austinmam/TSI/Datasheets/Linear Potentiometer Sensor with Rod End Joints_LPPS-100_Silver_Cable.png

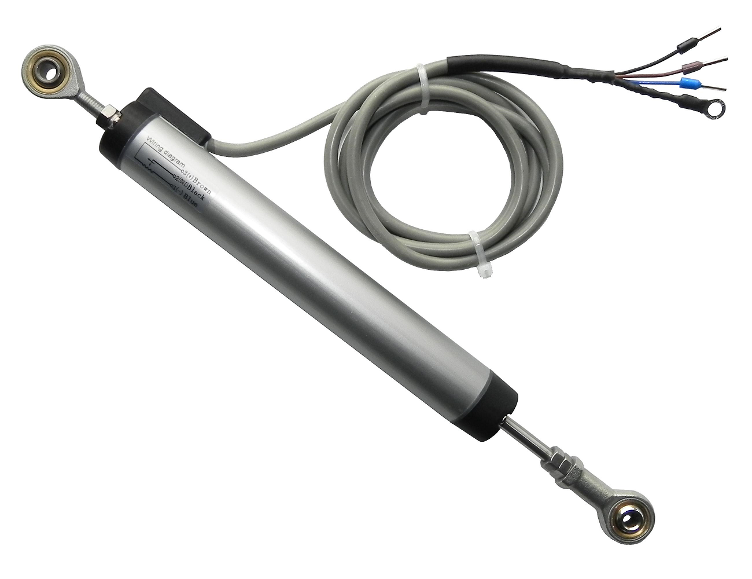
Datasheets/Linear Potentiometer Sensor with Rod End Joints_LPPS-100_Silver_Cable.png
