austinmam/TSI/Diagrams/CurtisMC_Precharge_Circuitry.PNG

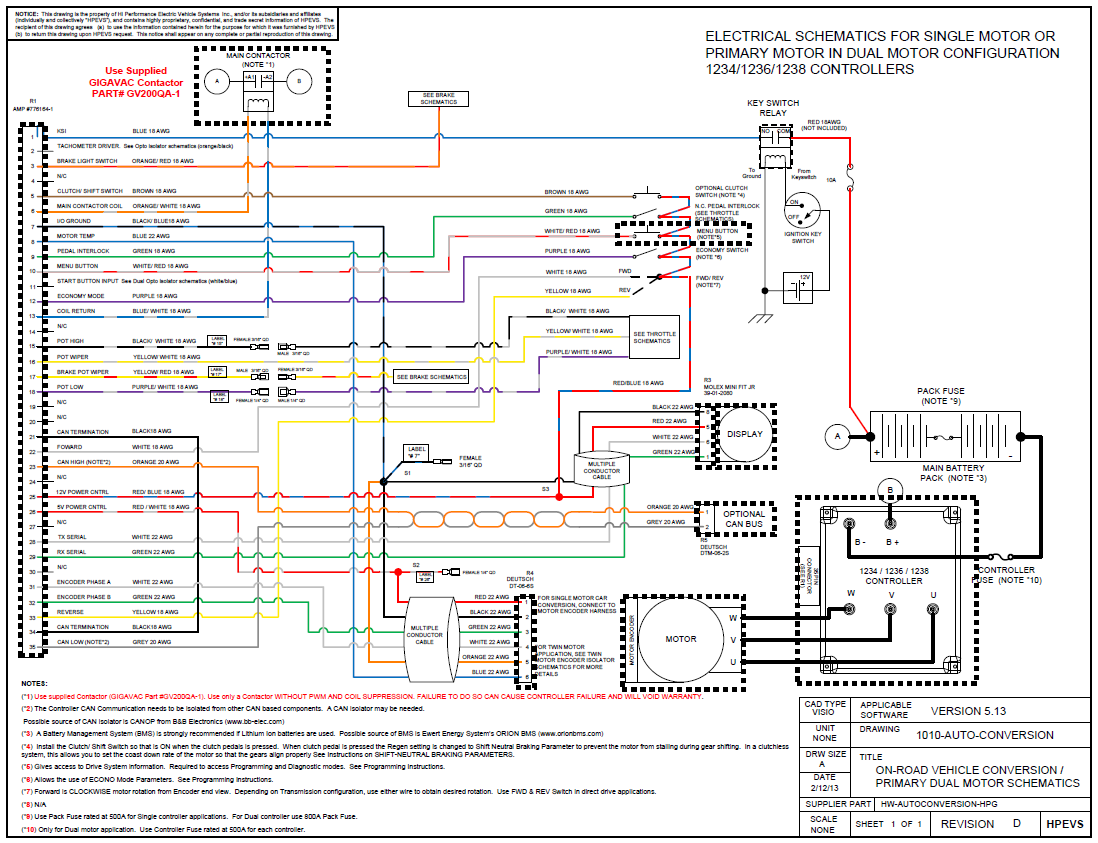
Diagrams/CurtisMC_Precharge_Circuitry.PNG
