austinmam/TSI/Diagrams/shutdown_diagram.PNG

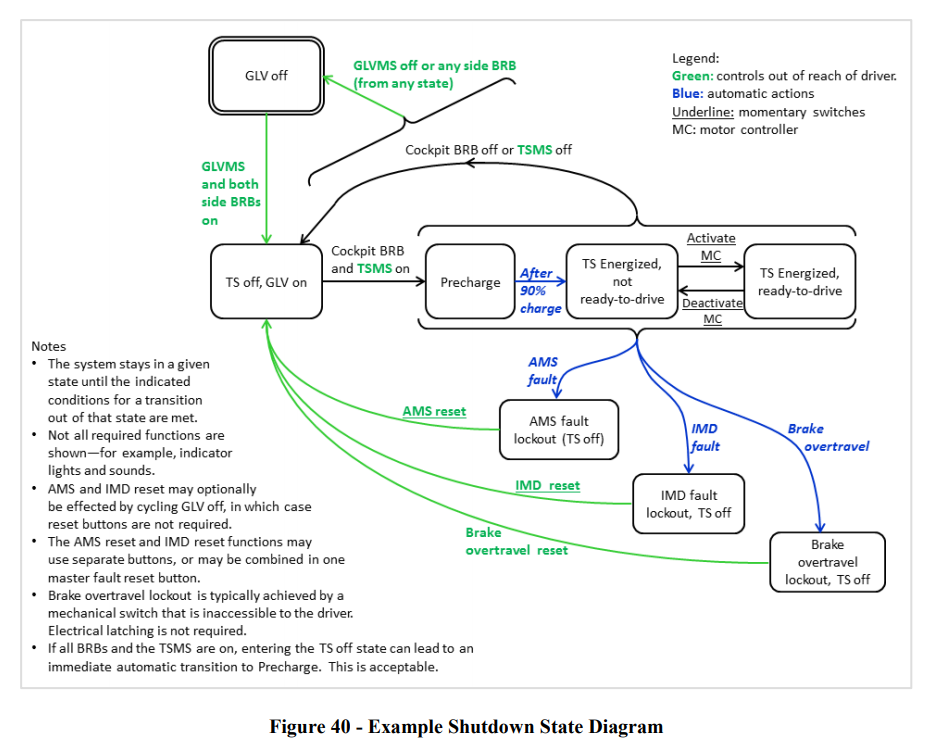
Diagrams/shutdown_diagram.PNG
