austinmam/TSI/Diagrams/ShutdownSystemPoster.png

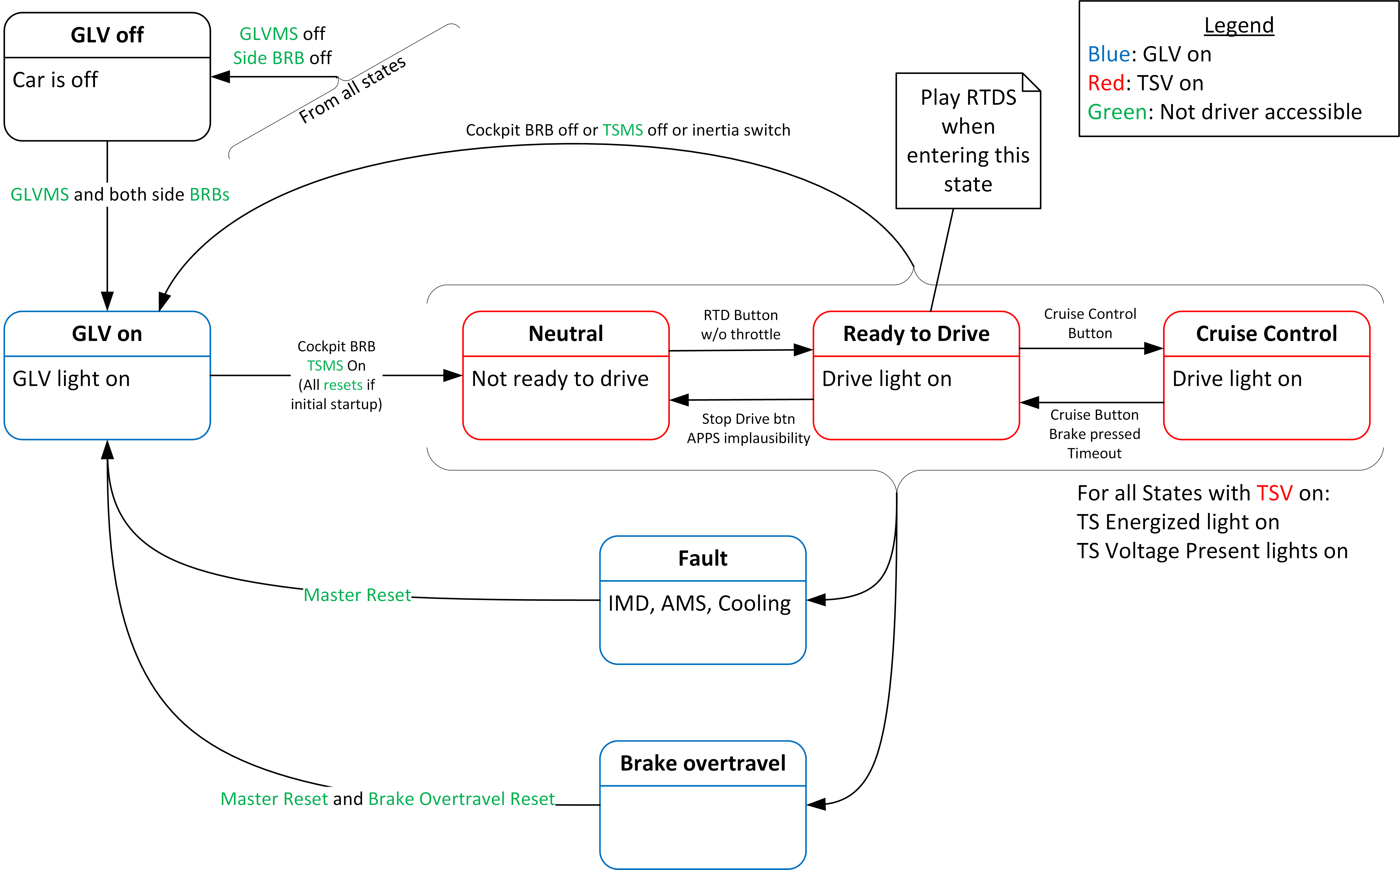
Diagrams/ShutdownSystemPoster.png
