austinmam/TSI/Diagrams/System_States.png

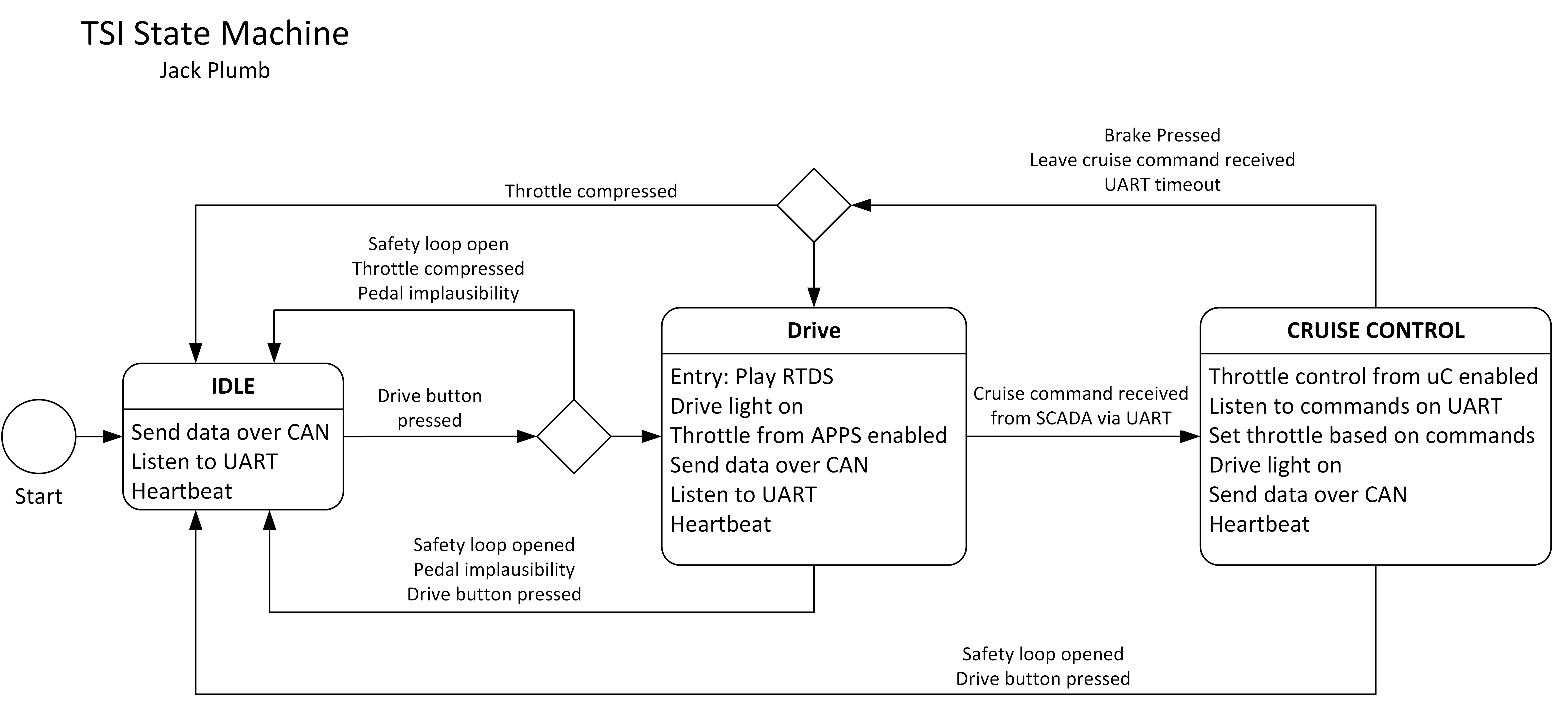
Diagrams/System_States.png
