austinmam/TSI/Diagrams/TSI_Func_Block_Diagram.png

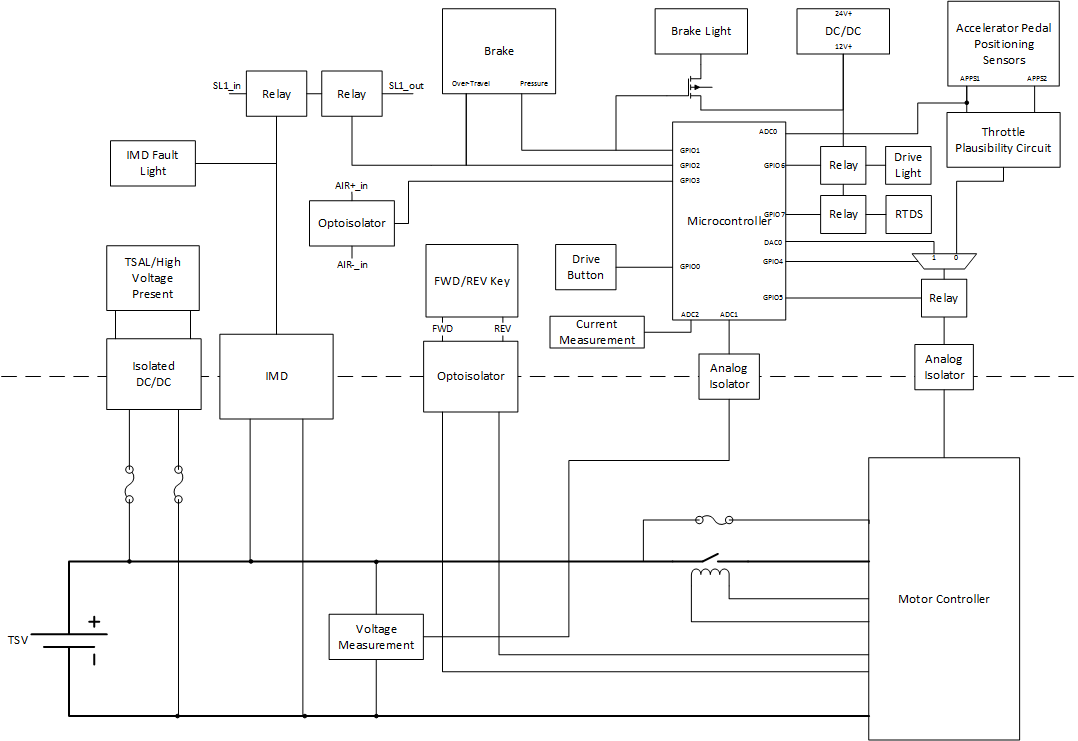
Diagrams/TSI_Func_Block_Diagram.png
