austinmam/TSI/Diagrams/TSV_to_MC.png

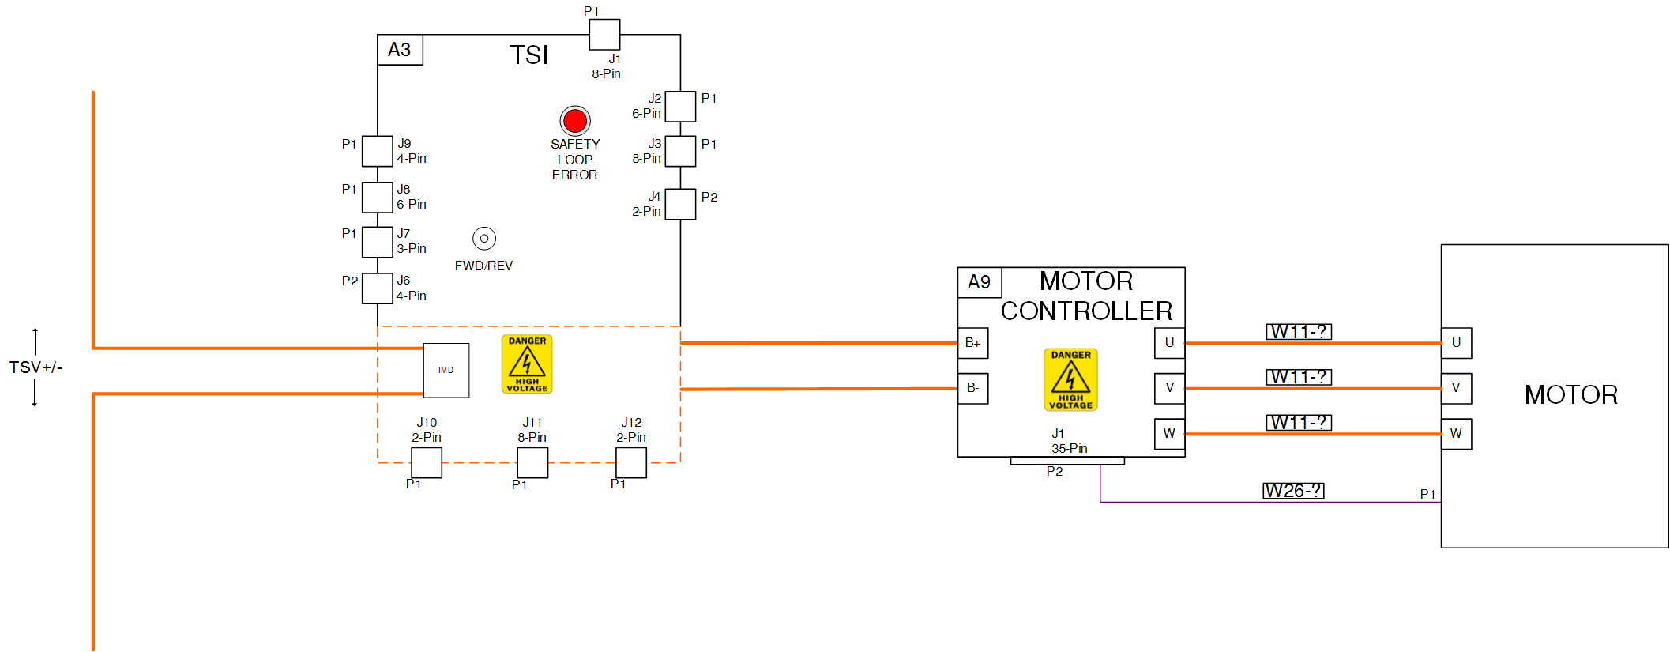
Diagrams/TSV_to_MC.png
