austinmam/TSI/For trash/Box Inventor/TSI_Box_Back_Panel.dxf

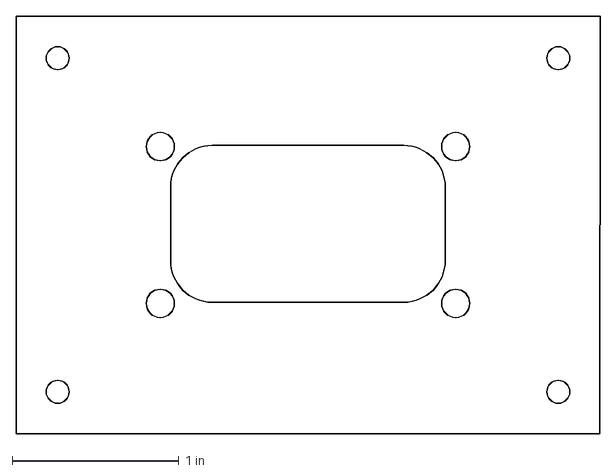
[picture p14: CAD file, 2017-04-13, last stored version]
For trash/Box Inventor/TSI_Box_Back_Panel.dxf
3.50 x 2.50 in
