austinmam/TSI/TSI Inventor Parts/TSI Inventor Parts/Wall Laser Cut.dxf

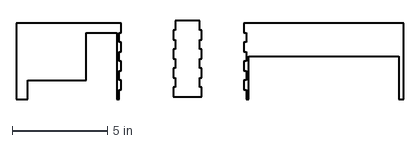
[picture p15: CAD file, 2017-05-05, last stored version]
TSI Inventor Parts/TSI Inventor Parts/Wall Laser Cut.dxf
20.3 x 4.13 in
