austinmam/TSI/For trash/Box Inventor/TSI Front Panel Cutout.dxf

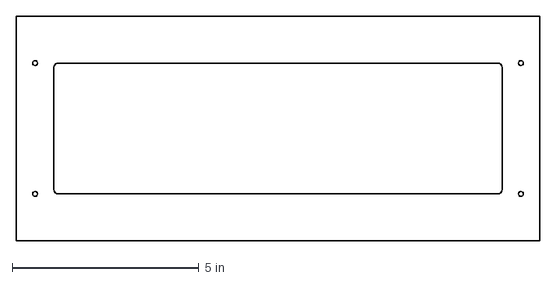
[picture p16: CAD file, 2017-04-13, last stored version]
For trash/Box Inventor/TSI Front Panel Cutout.dxf
14.0 x 6.00 in
