austinmam/TSI/Rack Plate Inventor/TSI_Rack_Plate.dxf

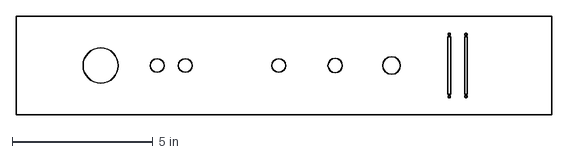
[picture p17: CAD file, 2017-04-03, last stored version]
Rack Plate Inventor/TSI_Rack_Plate.dxf
19.0 x 3.50 in
