austinmam/TSI/For trash/Box Inventor/TSI TSV+ Panel Cutout.dxf

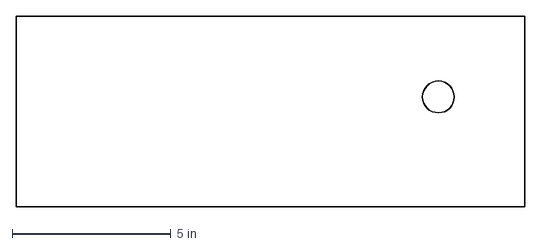
[picture p18: CAD file, 2017-04-13, last stored version]
For trash/Box Inventor/TSI TSV+ Panel Cutout.dxf
16.0 x 6.00 in
