austinmam/TSI/Rack Plate Inventor/pta4543-2x15cpxxxx.stp

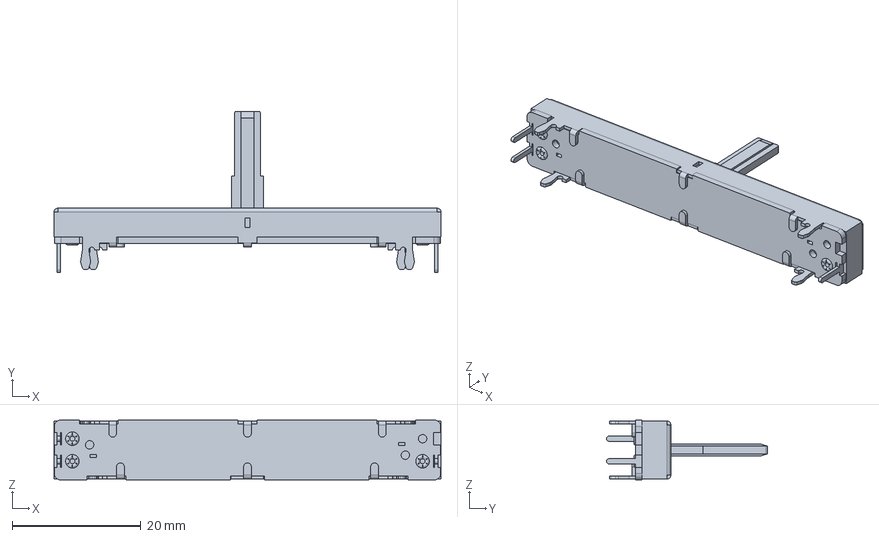
[picture p19: CAD file, 2017-03-31, last stored version]
Rack Plate Inventor/pta4543-2x15cpxxxx.stp
60.0 x 25.0 x 9.30 mm
