austinmam/TSI/TSI Inventor Parts/TSI Inventor Parts/TSI Back Panel Cutout.dxf

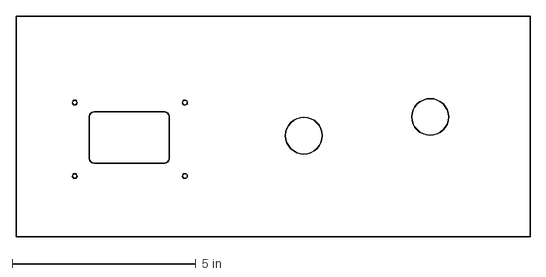
[picture p20: CAD file, 2017-04-13, last stored version]
TSI Inventor Parts/TSI Inventor Parts/TSI Back Panel Cutout.dxf
14.0 x 6.00 in
