austinmam/TSI/For trash/Box Inventor/Back Panel.dxf

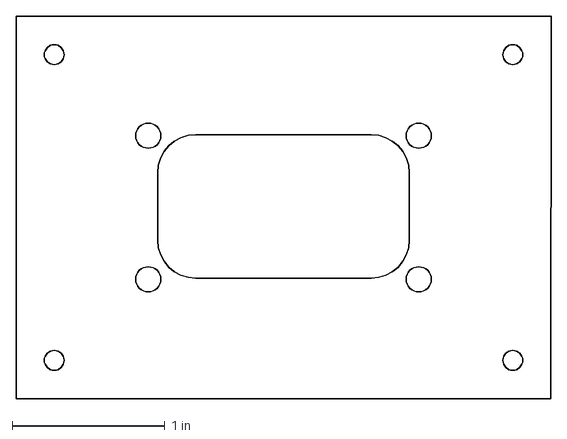
[picture p21: CAD file, 2017-04-13, last stored version]
For trash/Box Inventor/Back Panel.dxf
3.50 x 2.50 in
