austinmam/TSI/TSI Inventor Parts/TSI Inventor Parts/Mounting Plate Cut.dxf

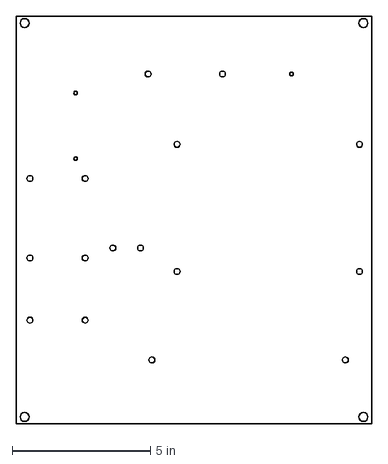
[picture p22: CAD file, 2017-04-13, last stored version]
TSI Inventor Parts/TSI Inventor Parts/Mounting Plate Cut.dxf
12.9 x 14.8 in
