austinmam/TSI/TSI Inventor Parts/TSI Inventor Parts/TSI_Box_Front_Panel.dxf

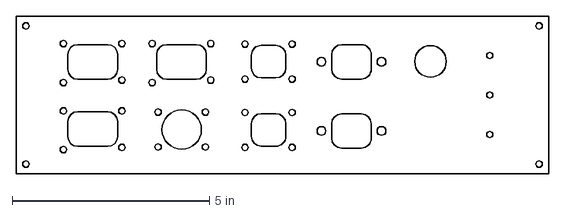
[picture p23: CAD file, 2017-04-13, last stored version]
TSI Inventor Parts/TSI Inventor Parts/TSI_Box_Front_Panel.dxf
13.5 x 4.00 in
