austinmam/TSI/For trash/Box Inventor/Front Panel.dxf

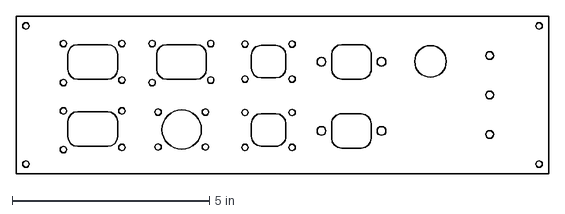
[picture p24: CAD file, 2017-04-13, last stored version]
For trash/Box Inventor/Front Panel.dxf
13.5 x 4.00 in
