austinmam/TSI/TSI Inventor Parts/TSI Inventor Parts/Current Sensor Bar.dxf

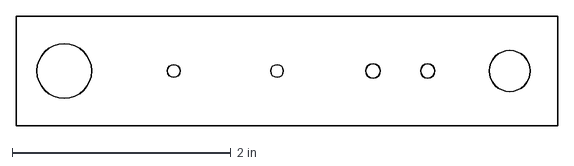
[picture p25: CAD file, 2017-04-13, last stored version]
TSI Inventor Parts/TSI Inventor Parts/Current Sensor Bar.dxf
4.95 x 1 in
