austinmam/TSI/For trash/Box Inventor/TSV-Bar.dxf

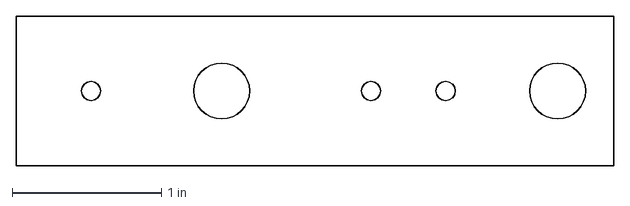
[picture p26: CAD file, 2017-04-13, last stored version]
For trash/Box Inventor/TSV-Bar.dxf
4.00 x 1 in
