austinmam/TSI/(list of files, cad)

Other CAD files:
Initial_Layout.dwg
TSI Inventor Parts/TSI Inventor Parts/15x11Plate.dwg
For trash/Box Inventor/15x11Plate.dwg
Box Inventor/1 inch screw.ipt
Box Inventor/15x11Plate.dwg
Box Inventor/15x11Plate.idw
Box Inventor/15x11Plate.ipt
Box Inventor/18x12x6Box.ipt
Box Inventor/2inStandoff.ipt
Box Inventor/2inchMcMasterStandoff.ipt
Box Inventor/2inchStandoff.ipt
Box Inventor/6-32 .25 inch screw.ipt
Box Inventor/6-32 inserts.ipt
Box Inventor/94335A115_ELECTRICAL-INSULATING FEM THRDED STANDOFF.ipt
Box Inventor/BackPanel Cutout.idw
Box Inventor/BackPanel Cutout.ipt
Box Inventor/BackPanel.idw
Box Inventor/BackPanel.ipt
Box Inventor/Box Connector Panel.ipt
Box Inventor/CAN2CAN.ipt
Box Inventor/CANIMDWall.ipt
Box Inventor/Current Sensor Bar.idw
Box Inventor/Current Sensor Bar.ipt
Box Inventor/DIN Rail (TS) 35mm Wide v1.ipt
Box Inventor/DIN Rail (TS) 35mm Wide v1/OldVersions/TS35x7.5 mm H - 5.2 mm dia slot - 100 mm long.0001.ipt
Box Inventor/DIN Rail (TS) 35mm Wide v1/TS35x7.5 mm H - 5.2 mm dia slot - 100 mm long.ipt
Box Inventor/FrontPanel.idw
Box Inventor/FrontPanel.ipt
Box Inventor/Garalite Support.ipt
Box Inventor/IMD20216.ipt
Box Inventor/L16-TSV-64.2.ipt
Box Inventor/L16-TSV-65.1.iam
Box Inventor/MockPCB.ipt
Box Inventor/OldVersions/15x11Plate.0003.dwg
Box Inventor/OldVersions/15x11Plate.0010.idw
Box Inventor/OldVersions/15x11Plate.0055.ipt
Box Inventor/OldVersions/18x12x6Box.0065.ipt
Box Inventor/OldVersions/BackPanel Cutout.0003.ipt
Box Inventor/OldVersions/BackPanel Cutout.0009.idw
Box Inventor/OldVersions/BackPanel Cutout.0011.idw
Box Inventor/OldVersions/BackPanel.0007.idw
Box Inventor/OldVersions/BackPanel.0014.ipt
Box Inventor/OldVersions/Box Connector Panel.0008.ipt
Box Inventor/OldVersions/CAN2CAN.0002.ipt
Box Inventor/OldVersions/CANIMDWall.0002.ipt
Box Inventor/OldVersions/Current Sensor Bar.0006.idw
Box Inventor/OldVersions/Current Sensor Bar.0007.idw
Box Inventor/OldVersions/Current Sensor Bar.0023.ipt
Box Inventor/OldVersions/DIN Rail (TS) 35mm Wide v1.0011.ipt
Box Inventor/OldVersions/FrontPanel.0008.idw
Box Inventor/OldVersions/FrontPanel.0018.ipt
Box Inventor/OldVersions/Garalite Support.0002.ipt
Box Inventor/OldVersions/IMD20216.0001.ipt
Box Inventor/OldVersions/L16-TSV-65.1.0018.iam
Box Inventor/OldVersions/MockPCB.0010.ipt
Box Inventor/OldVersions/PCBWall.0001.ipt
Box Inventor/OldVersions/Plug-in Plate.0001.ipt
Box Inventor/OldVersions/PrechargeRelay2016.0005.ipt
Box Inventor/OldVersions/Ring Connector model 2.0001.ipt
Box Inventor/OldVersions/Ring Connector model 3.0009.ipt
Box Inventor/OldVersions/Ring Connector model 4.0005.ipt
Box Inventor/OldVersions/Ring Connector model 5.0005.ipt
Box Inventor/OldVersions/SmallWall.0006.ipt
Box Inventor/OldVersions/TSI Front Cutout.0003.ipt
Box Inventor/OldVersions/TSI Front Cutout.0010.idw
Box Inventor/OldVersions/TSI Front Cutout.0012.idw
Box Inventor/OldVersions/TSIWall.0006.ipt
Box Inventor/OldVersions/TSI_Assembly.0045.iam
Box Inventor/OldVersions/TSV+ Side Panel.0001.ipt
Box Inventor/OldVersions/TSV+ Side Panel.0005.idw
Box Inventor/OldVersions/TSV+Panel.0002.ipt
Box Inventor/OldVersions/TSV+Panel.0005.ipt
Box Inventor/OldVersions/TSV+Support.0003.ipt
Box Inventor/OldVersions/TSV-Bar.0006.idw
Box Inventor/OldVersions/TSV-Bar.0017.ipt
Box Inventor/OldVersions/TSV-Panel.0001.ipt
Box Inventor/OldVersions/TSV-PanelCutout.0002.ipt
Box Inventor/OldVersions/TSV-PanelCutout.0008.idw
Box Inventor/OldVersions/TSV-Support.0006.ipt
Box Inventor/OldVersions/WallBend.0001.ipt
Box Inventor/PCBWall.ipt
Box Inventor/Plug-in Plate.ipt
Box Inventor/PrechargeRelay2016.ipt
Box Inventor/Ring Connector model 2.ipt
Box Inventor/Ring Connector model 3.ipt
Box Inventor/Ring Connector model 4.ipt
Box Inventor/Ring Connector model 5.ipt
Box Inventor/Ring Connector model.ipt
Box Inventor/SmallWall.ipt
Box Inventor/TSAL2016.ipt
Box Inventor/TSI Front Cutout.idw
Box Inventor/TSI Front Cutout.ipt
Box Inventor/TSI TSV- Panel Cutout.dxf
Box Inventor/TSIWall.ipt
Box Inventor/TSI_Assembly.iam
Box Inventor/TSV+ Side Panel.idw
Box Inventor/TSV+ Side Panel.ipt
Box Inventor/TSV+In.ipt
Box Inventor/TSV+Panel.ipt
Box Inventor/TSV+Support.ipt
Box Inventor/TSV-Bar.idw
Box Inventor/TSV-Bar.ipt
Box Inventor/TSV-Panel.ipt
Box Inventor/TSV-PanelCutout.idw
Box Inventor/TSV-PanelCutout.ipt
Box Inventor/TSV-Support.ipt
Box Inventor/WallBend.ipt
For trash/Box Inventor/1 inch screw.ipt
For trash/Box Inventor/15x11Plate.idw
For trash/Box Inventor/15x11Plate.ipt
For trash/Box Inventor/18x12x6Box.ipt
For trash/Box Inventor/2inStandoff.ipt
For trash/Box Inventor/2inchMcMasterStandoff.ipt
For trash/Box Inventor/2inchStandoff.ipt
For trash/Box Inventor/6-32 .25 inch screw.ipt
For trash/Box Inventor/6-32 inserts.ipt
For trash/Box Inventor/94335A115_ELECTRICAL-INSULATING FEM THRDED STANDOFF.ipt
For trash/Box Inventor/BackPanel Cutout.idw
For trash/Box Inventor/BackPanel Cutout.ipt
For trash/Box Inventor/BackPanel.idw
For trash/Box Inventor/BackPanel.ipt
For trash/Box Inventor/Box Connector Panel.ipt
For trash/Box Inventor/CAN2CAN.ipt
For trash/Box Inventor/CANIMDWall.ipt
For trash/Box Inventor/Current Sensor Bar.idw
For trash/Box Inventor/Current Sensor Bar.ipt
For trash/Box Inventor/DIN Rail (TS) 35mm Wide v1.ipt
For trash/Box Inventor/DIN Rail (TS) 35mm Wide v1/OldVersions/TS35x7.5 mm H - 5.2 mm dia slot - 100 mm long.0001.ipt
For trash/Box Inventor/DIN Rail (TS) 35mm Wide v1/TS35x7.5 mm H - 5.2 mm dia slot - 100 mm long.ipt
For trash/Box Inventor/FrontPanel.idw
For trash/Box Inventor/FrontPanel.ipt
For trash/Box Inventor/Garalite Support.ipt
For trash/Box Inventor/IMD20216.ipt
For trash/Box Inventor/L16-TSV-64.2.ipt
For trash/Box Inventor/L16-TSV-65.1.iam
For trash/Box Inventor/MockPCB.ipt
For trash/Box Inventor/OldVersions/15x11Plate.0003.dwg
For trash/Box Inventor/OldVersions/15x11Plate.0010.idw
For trash/Box Inventor/OldVersions/15x11Plate.0055.ipt
For trash/Box Inventor/OldVersions/18x12x6Box.0065.ipt
For trash/Box Inventor/OldVersions/BackPanel Cutout.0003.ipt
For trash/Box Inventor/OldVersions/BackPanel Cutout.0009.idw
For trash/Box Inventor/OldVersions/BackPanel Cutout.0011.idw
For trash/Box Inventor/OldVersions/BackPanel.0007.idw
For trash/Box Inventor/OldVersions/BackPanel.0014.ipt
For trash/Box Inventor/OldVersions/Box Connector Panel.0008.ipt
For trash/Box Inventor/OldVersions/CAN2CAN.0002.ipt
For trash/Box Inventor/OldVersions/CANIMDWall.0002.ipt
For trash/Box Inventor/OldVersions/Current Sensor Bar.0006.idw
For trash/Box Inventor/OldVersions/Current Sensor Bar.0007.idw
For trash/Box Inventor/OldVersions/Current Sensor Bar.0023.ipt
For trash/Box Inventor/OldVersions/DIN Rail (TS) 35mm Wide v1.0011.ipt
For trash/Box Inventor/OldVersions/FrontPanel.0008.idw
For trash/Box Inventor/OldVersions/FrontPanel.0018.ipt
For trash/Box Inventor/OldVersions/Garalite Support.0002.ipt
For trash/Box Inventor/OldVersions/IMD20216.0001.ipt
For trash/Box Inventor/OldVersions/L16-TSV-65.1.0018.iam
For trash/Box Inventor/OldVersions/MockPCB.0010.ipt
For trash/Box Inventor/OldVersions/PCBWall.0001.ipt
For trash/Box Inventor/OldVersions/Plug-in Plate.0001.ipt
For trash/Box Inventor/OldVersions/PrechargeRelay2016.0005.ipt
For trash/Box Inventor/OldVersions/Ring Connector model 2.0001.ipt
For trash/Box Inventor/OldVersions/Ring Connector model 3.0009.ipt
For trash/Box Inventor/OldVersions/Ring Connector model 4.0005.ipt
For trash/Box Inventor/OldVersions/Ring Connector model 5.0005.ipt
For trash/Box Inventor/OldVersions/SmallWall.0006.ipt
For trash/Box Inventor/OldVersions/TSI Front Cutout.0003.ipt
For trash/Box Inventor/OldVersions/TSI Front Cutout.0010.idw
For trash/Box Inventor/OldVersions/TSI Front Cutout.0012.idw
For trash/Box Inventor/OldVersions/TSIWall.0006.ipt
For trash/Box Inventor/OldVersions/TSI_Assembly.0045.iam
For trash/Box Inventor/OldVersions/TSV+ Side Panel.0001.ipt
For trash/Box Inventor/OldVersions/TSV+ Side Panel.0005.idw
For trash/Box Inventor/OldVersions/TSV+Panel.0002.ipt
For trash/Box Inventor/OldVersions/TSV+Panel.0005.ipt
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
