austinmam/TSI/Diagrams/Wiring_Diagram.png

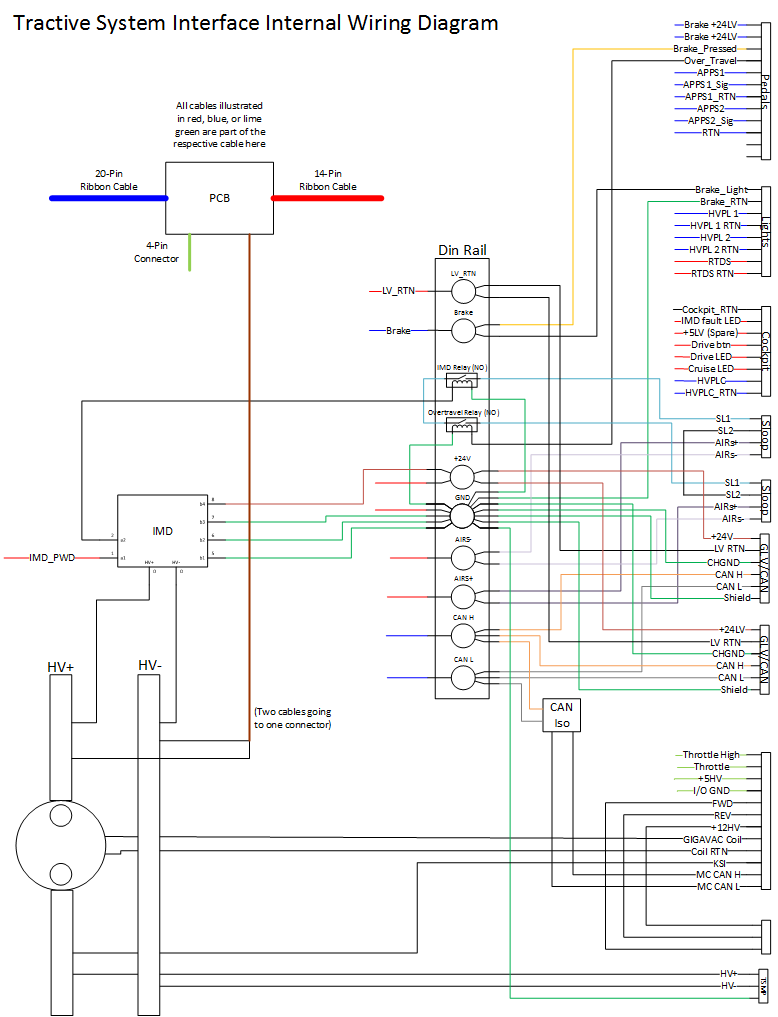
Diagrams/Wiring_Diagram.png
