austinmam/TSI/Diagrams/DriveStates.pdf

## DRIVE_SETUP

## DRIVE

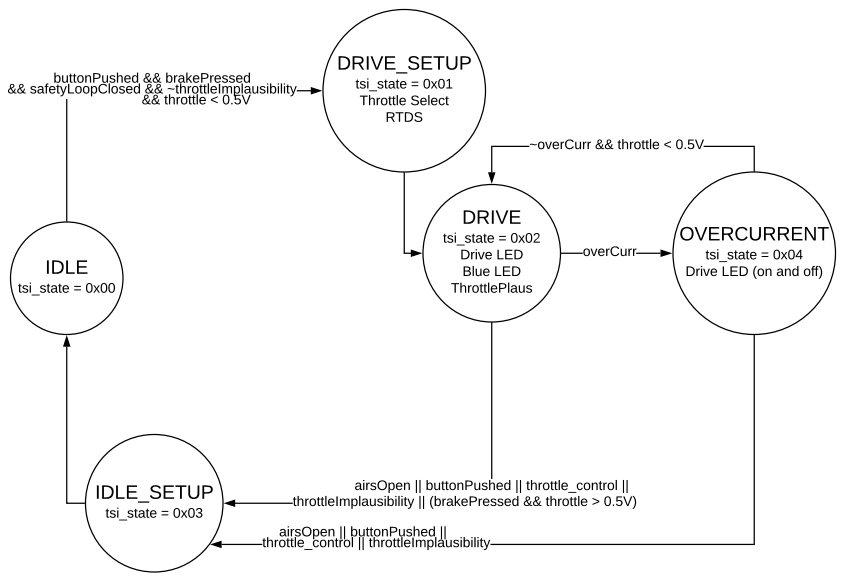
[picture p38: page 1]
IDLE; tsi_state = 0x00; tsi_state = 0x01 Throttle Select RTDS; tsi_state = 0x02 Drive LED Blue LED ThrottlePlaus; IDLE_SETUP; tsi_state = 0x03; airsOpen || buttonPushed || throttle_control ||; airsOpen || buttonPushed || throttle_control || throttleImplausibility; ~overCurr && throttle < 0.5V; overCurr

buttonPushed && brakePressed
&& safetyLoopClosed && ~throttleImplausibility && throttle < 0.5V

OVERCURRENT
tsi_state = 0x04
Drive LED (on and off)

throttleImplausibility || (brakePressed && throttle > 0.5V)
