austinmam/TSI/(list of files, drawings)

Other design files:
For trash/TSI_HV_Isolater/TSI_HV_Isolater.dsn
TSI_HV_Isolater/TSI_HV_Isolater.dsn
