austinmam/TSI/For trash/TSI_HV_Isolater/TSI_HV_Isolater.kicad_pcb

## KiCad design For trash/TSI_HV_Isolater/TSI_HV_Isolater.kicad_pcb (2017-02-14, last stored version)

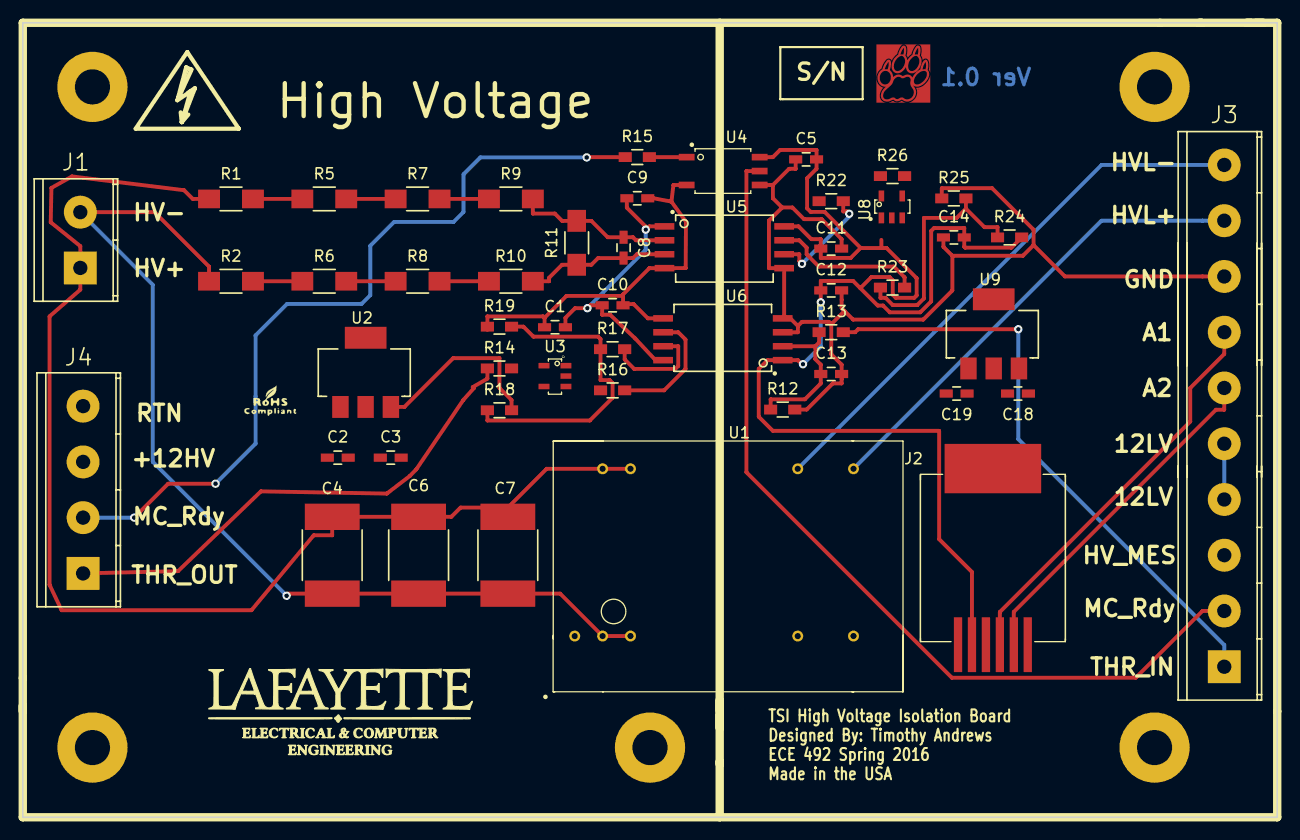
[picture p39: board TSI_HV_Isolater.kicad_pcb from above]

Board: 2 copper layers, 114.3 x 72.4 mm, 59 parts (0 on the bottom side), 34 nets.

Parts:
C1, C5, C9, C10, C11, C12, C13, C14: 0.1u; C_0603_HandSoldering
C2, C18: 10u; C_0603_HandSoldering
C3, C19: 22u; C_0603_HandSoldering
C4, C6, C7: 1u; C_2220_HandSoldering
C8: 330p; C_0603_HandSoldering
J1: CONN_01X02; TerminalBlock_Pheonix_MPT-5.08mm_2pol
J2: RJ12; MOLEX_RJ11
J3: CONN_01X10; TerminalBlock_Pheonix_MPT-5.08mm_10pol
J4: CONN_01X04; TerminalBlock_Pheonix_MPT-5.08mm_4pol
R1, R2, R5, R6, R7, R8, R9, R10: 10k; R_1206_HandSoldering
R11: 120; R_1206_HandSoldering
R12, R18, R19, R24, R25: 2k; R_0603_HandSoldering
R13: 3k; R_0603_HandSoldering
R14, R16, R17, R22, R23: 1k; R_0603_HandSoldering
R15: 20k; R_0603_HandSoldering
R26: 4.99k; R_0603_HandSoldering
U1: RDD08110S12
U2, U9: AZ1117CH-5.0TRG1; SOT-223_cus
U3, U8: MCP6001; MCP6001_SOT_23-5
U4: TLP2361; FODM8701
U5: AMC1100DWVR; amc1100_SOIC
U6: ACPL-C870; amc1100_SOIC
U10: place_holder; logo_lafayette_ece_24mmx9mm
U11: place_holder; lafLogo
U12: place_holder; rohs_symbol
U13: place_holder; Symbol_HighVoltage_Type2_FSilk_VerySmall
U16, U17, U18, U21, U30: place_holder; MountingHole_3.2mm_M3_Pad

Connections:
/24MC_RDYHV: J4.2, R15.1
/24MC_RDYLV: J3.2, U4.5
/+5HV: C1.2, C3.1, C9.1, C10.1, R18.2, U2.2, U3.5, U5.1, U6.8
/+5LV: C5.2, C11.1, C12.1, C14.2, C19.1, J2.5, R24.2, U4.6, U5.8, U6.1, U8.5, U9.2
/+12HV: C2.1, J4.3, U2.3
/+12LV: C18.1, J3.4, J3.5, U9.3
/A1_LV: J2.3, J3.7
/A2_LV: J2.2, J3.6
/GND: C5.1, C11.2, C12.2, C13.2, C14.1, C18.2, C19.2, J2.4, J3.8, R12.2, R25.1, U4.4, U5.5, U6.3, U6.4, U8.2, U9.1
/HV+: C4.2, C6.2, C7.2, J1.1, R1.1, U1.22, U1.23
/HV-: C4.1, C6.1, C7.1, J1.2, R2.1, U1.2, U1.3
/HV_LED+: J3.9, U1.14
/HV_LED-: J3.10, U1.16
/HV_MES: J3.3, R26.1, U8.1
/RTN: C1.1, C2.2, C3.2, C9.2, C10.2, J4.4, R19.1, U2.1, U3.2, U4.3, U5.4, U6.5
/Throttle_IN: J3.1, R13.2
/Throttle_OUT: J4.1, R14.1, U3.1
unnamed: C8.1, R9.2, R11.2, U5.2
unnamed: C8.2, R10.2, R11.1, U5.3
unnamed: C13.1, R12.1, R13.1, U6.2
unnamed: R1.2, R5.1
unnamed: R2.2, R6.1
unnamed: R5.2, R7.1
unnamed: R6.2, R8.1
unnamed: R7.2, R9.1
unnamed: R8.2, R10.1
unnamed: R14.2, R16.1
unnamed: R15.2, U4.1
unnamed: R17.1, R18.1, R19.2, U6.7
unnamed: R17.2, U3.3
unnamed: R22.1, R26.2, U8.4
unnamed: R22.2, U5.6
unnamed: R23.1, R24.1, R25.2, U8.3
unnamed: R23.2, U5.7
