austinmam/TSI/Circuit_layout/Circuit_layout.kicad_pcb

## KiCad design Circuit_layout/Circuit_layout.kicad_pcb (2017-03-28, last stored version)

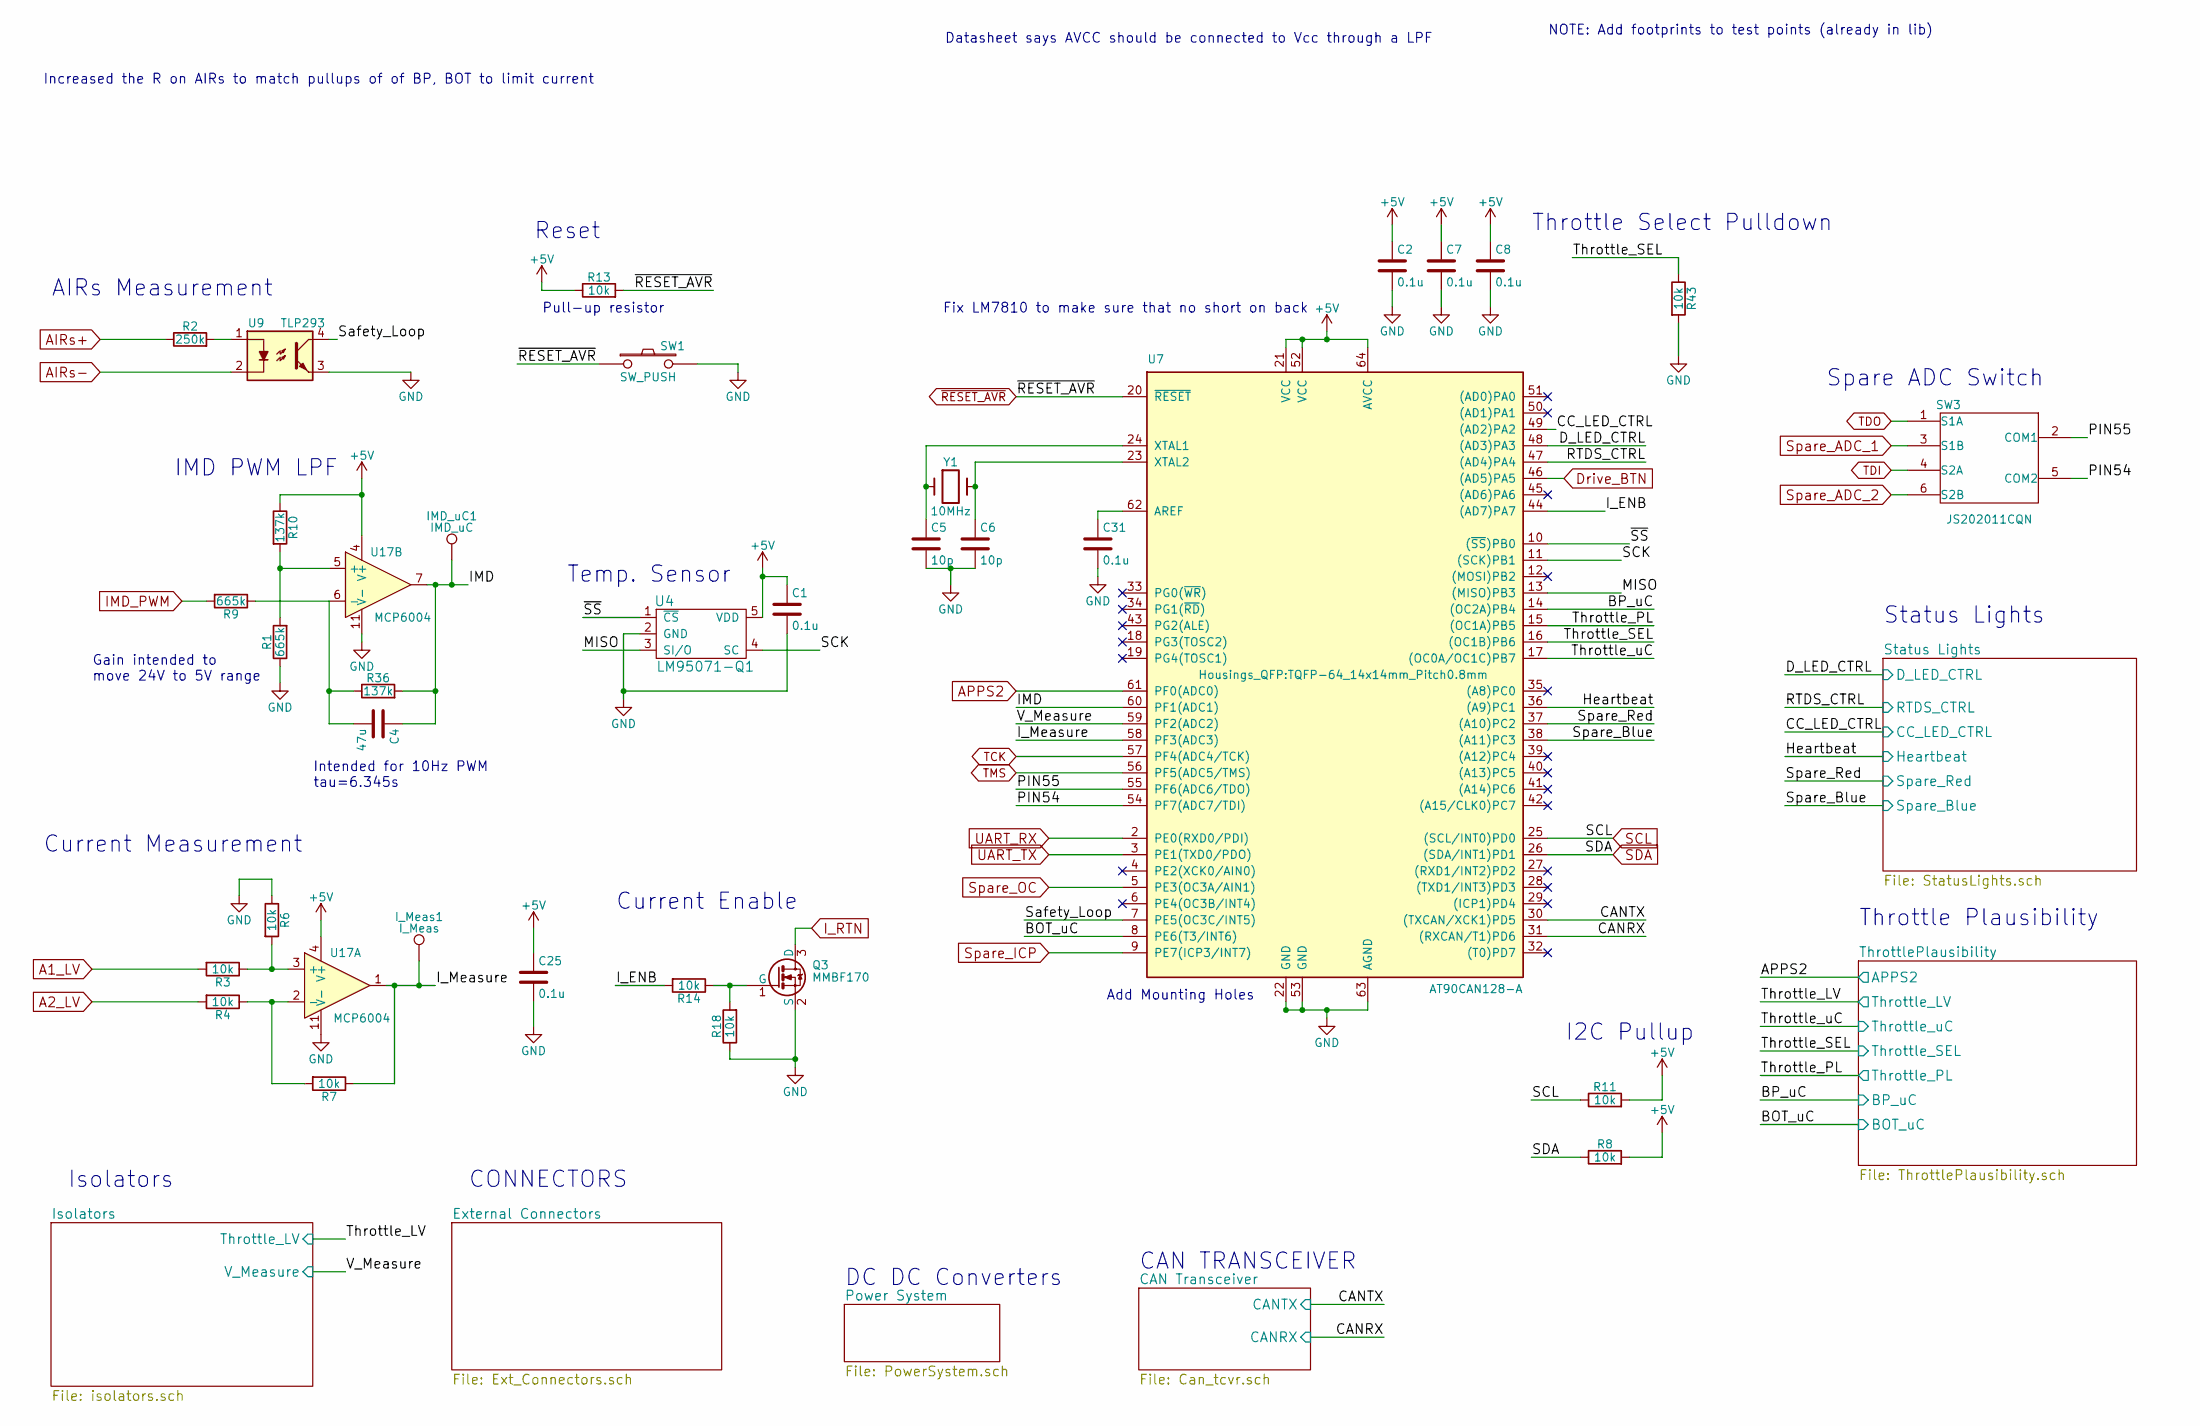
[picture p40: schematic Circuit_layout.sch, Tractive System Interface]

Parts:
C1, C2, C7, C8, C25, C31: 0.1u; C_0805_HandSoldering; Digikey P/N 399-1168-1-ND
C4: 47u; C_1210_HandSoldering; Digikey P/N 490-6538-1-ND
C5, C6: 10p; C_0805_HandSoldering; DigiKey P/N 399-1108-1-ND
IMD_uC1: IMD_uC; Measurement_Point_Round-SMD-Pad_Big
I_Meas1: I_Meas; Measurement_Point_Round-SMD-Pad_Big
Q3: MMBF170; SOT-23; Digikey P/N MMBF170CT-ND
R1, R9: 665k; R_0805_HandSoldering; DigiKey P/N P665KCCT-ND
R2: 250k; R_0805_HandSoldering; DigiKey P/N P249KCCT-ND
R3, R4, R6, R7, R8, R11, R13, R14, R18, R43: 10k; R_0805_HandSoldering; DigiKey P/N P10.0KCCT-ND
R10, R36: 137k; R_0805_HandSoldering; DigiKey P/N P137KCCT-ND
SW1: SW_PUSH; SW_RACON_8; DigiKey P/N 1715-1676-1-ND
SW3: JS202011CQN; CK_DPDT_Switch; DigiKey P/N 401-2001-ND
U4: LM95071-Q1; SOT-23-5_HandSoldering; DigiKey P/N 296-40259-1-ND
U7: AT90CAN128-A; TQFP-64_14x14mm_Pitch0.8mm; DigiKey P/N AT90CAN128-16AURCT-ND
U9: TLP293; SOP-4_4.4x2.8mm_Pitch1.27mm; DigiKey P/N TLP293(GB-TPLECT-ND
U17: MCP6004; SOIC-14_3.9x8.7mm_Pitch1.27mm; Digikey P/N MCP6004T-I/SLCT-ND
Y1: 10MHz; crystal_TXC_7A; DigiKey P/N 887-1741-1-ND

Connections:
+5V: C1.1, C2.1, C7.1, C8.1, C25.1, R8.2, R10.1, R11.2, R13.1, U4.5 (VDD), U7.21 (VCC), U7.52 (VCC), U7.64 (AVCC), U17.4 (V+); also elsewhere on the board
/CAN Transceiver/CANRX: U7.31 ((RXCAN/T1)PD6); also elsewhere on the board
/CAN Transceiver/CANTX: U7.30 ((TXCAN/XCK1)PD5); also elsewhere on the board
/IMD: C4.1, IMD_uC1.1, R36.2, U7.60 (PF1(ADC1)), U17.7
/I_ENB: R14.2, U7.44 ((AD7)PA7)
/I_Measure: I_Meas1.1, R7.1, U7.58 (PF3(ADC3)), U17.1
/Isolators/V_Measure: U7.59 (PF2(ADC2)); also elsewhere on the board
/MISO: U4.3 (SI/O), U7.13 ((MISO)PB3)
/PIN54: SW3.5 (COM2), U7.54 (PF7(ADC7/TDI))
/PIN55: SW3.2 (COM1), U7.55 (PF6(ADC6/TDO))
/SCK: U4.4 (SC), U7.11 ((SCK)PB1)
/Safety_Loop: U7.7 (PE5(OC3C/INT5)), U9.4
/Status Lights/CC_LED_CTRL: U7.49 ((AD2)PA2); also elsewhere on the board
/Status Lights/D_LED_CTRL: U7.48 ((AD3)PA3); also elsewhere on the board
/Status Lights/Heartbeat: U7.36 ((A9)PC1); also elsewhere on the board
/Status Lights/RTDS_CTRL: U7.47 ((AD4)PA4); also elsewhere on the board
/Status Lights/Spare_Blue: U7.38 ((A11)PC3); also elsewhere on the board
/Status Lights/Spare_Red: U7.37 ((A10)PC2); also elsewhere on the board
/ThrottlePlausibility/BOT_uC: U7.8 (PE6(T3/INT6)); also elsewhere on the board
/ThrottlePlausibility/BP_uC: U7.14 ((OC2A)PB4); also elsewhere on the board
/ThrottlePlausibility/Throttle_PL: U7.15 ((OC1A)PB5); also elsewhere on the board
/ThrottlePlausibility/Throttle_SEL: R43.1, U7.16 ((OC1B)PB6); also elsewhere on the board
/ThrottlePlausibility/Throttle_uC: U7.17 ((OC0A/OC1C)PB7); also elsewhere on the board
/~SS: U4.1 (~CS), U7.10 ((~SS~)PB0)
A1_LV: R3.2; also elsewhere on the board
A2_LV: R4.2; also elsewhere on the board
AIRs+: R2.1; also elsewhere on the board
AIRs-: U9.2; also elsewhere on the board
APPS2: U7.61 (PF0(ADC0)); also elsewhere on the board
CH_GND: C1.2, C2.2, C5.2, C6.2, C7.2, C8.2, C25.2, C31.2, Q3.2 (S), R1.1, R6.1, R18.1, R43.2, SW1.2, U4.2 (GND), U7.22 (GND), U7.53 (GND), U7.63 (AGND), U9.3, U17.11 (V-); also elsewhere on the board
Drive_BTN: U7.46 ((AD5)PA5); also elsewhere on the board
IMD_PWM: R9.2; also elsewhere on the board
I_RTN: Q3.3 (D); also elsewhere on the board
unnamed: C4.2, R9.1, R36.1, U17.6 (-)
unnamed: C5.1, U7.24 (XTAL1), Y1.1
unnamed: C6.1, U7.23 (XTAL2), Y1.2
unnamed: C31.1, U7.62 (AREF)
unnamed: Q3.1 (G), R14.1, R18.2
unnamed: R1.2, R10.2, U17.5 (+)
unnamed: R2.2, U9.1
unnamed: R3.1, R6.2, U17.3 (+)
unnamed: R4.1, R7.2, U17.2 (-)
SCL: R11.1, U7.25 ((SCL/INT0)PD0); also elsewhere on the board
SDA: R8.1, U7.26 ((SDA/INT1)PD1); also elsewhere on the board
Spare_ADC_1: SW3.3 (S1B); also elsewhere on the board
Spare_ADC_2: SW3.6 (S2B); also elsewhere on the board
Spare_ICP: U7.9 (PE7(ICP3/INT7)); also elsewhere on the board
Spare_OC: U7.5 (PE3(OC3A/AIN1)); also elsewhere on the board
TCK: U7.57 (PF4(ADC4/TCK)); also elsewhere on the board
TDI: SW3.4 (S2A); also elsewhere on the board
TDO: SW3.1 (S1A); also elsewhere on the board
TMS: U7.56 (PF5(ADC5/TMS)); also elsewhere on the board
UART_RX: U7.2 (PE0(RXD0/PDI)); also elsewhere on the board
UART_TX: U7.3 (PE1(TXD0/PDO)); also elsewhere on the board
~RESET_AVR: R13.2, SW1.1, U7.20 (~RESET); also elsewhere on the board

Notes on the sheet:
CONNECTORS
CAN TRANSCEIVER
Current Measurement
IMD PWM LPF
AIRs Measurement
Throttle Plausibility
Status Lights
DC DC Converters
Isolators
Add Mounting Holes
Intended for 10Hz PWM tau=6.345s
I2C Pullup
Datasheet says AVCC should be connected to Vcc through a LPF
Pull-up resistor
Reset
Throttle Select Pulldown
NOTE: Add footprints to test points (already in lib)
Spare ADC Switch
Increased the R on AIRs to match pullups of of BP, BOT to limit current
Current Enable
Gain intended to move 24V to 5V range
Temp. Sensor
Fix LM7810 to make sure that no short on back

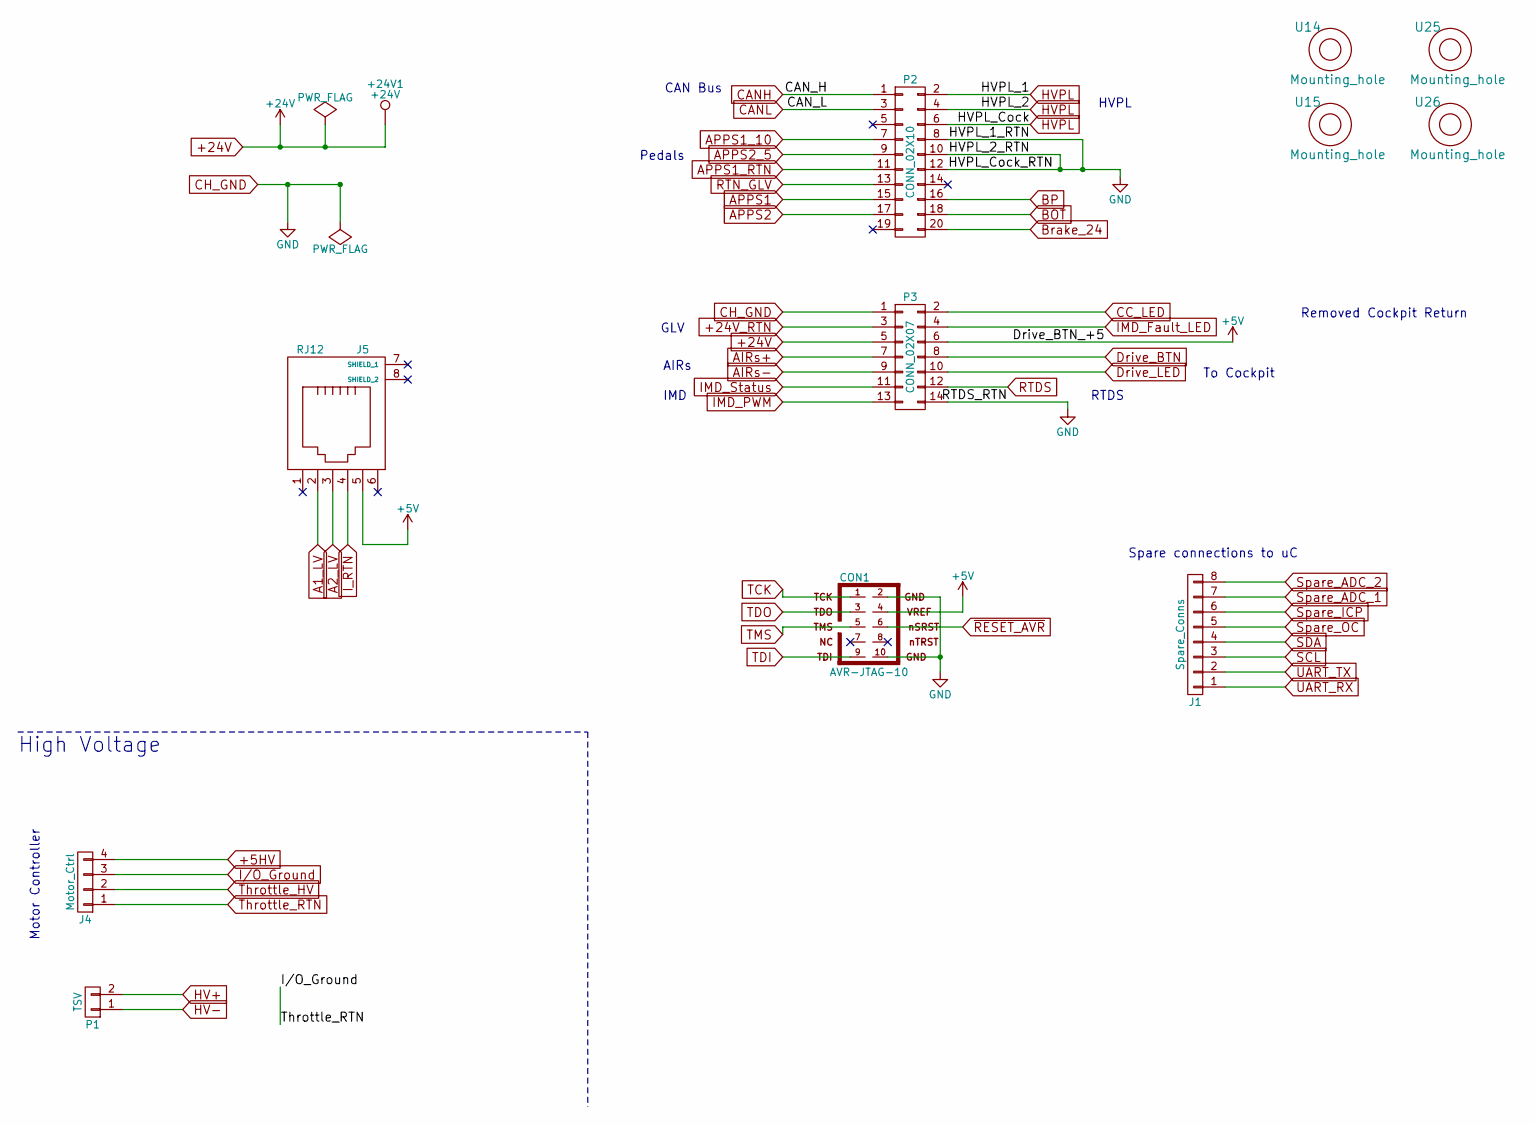
[picture p41: schematic Ext_Connectors.sch, Tractive System Interface]

Parts:
+24V1: +24V; Measurement_Point_Round-SMD-Pad_Big
CON1: AVR-JTAG-10; JTAG; DigiKey P/N 609-4054-ND
J1: Spare_Conns; Molex_8x1_2.54mm; DigiKey P/N WM4128-ND
J4: Motor_Ctrl; Molex_4x1_2.54mm; DigiKey P/N WM4802-ND
J5: RJ12; MOLEX_RJ11; DigiKey P/N WM3789CT-ND
P1: TSV; AMPCONN_2; DigiKey P/N A113980-ND
P2: CONN_02X10; IDC_Header_Straight_20pins; DigiKey P/N WM14741-ND
P3: CONN_02X07; IDC_Header_Straight_14pins; DigiKey P/N WM8632-ND
U14, U15, U25, U26: Mounting_hole; MountingHole_3.5mm_Pad

Connections:
+5HV: J4.4; also elsewhere on the board
+5V: CON1.4, J5.5, P3.6; also elsewhere on the board
+24V: +24V1.1, P2.20, P3.5; also elsewhere on the board
+24V_RTN: P3.3; also elsewhere on the board
A1_LV: J5.2; also elsewhere on the board
A2_LV: J5.3; also elsewhere on the board
AIRs+: P3.7; also elsewhere on the board
AIRs-: P3.9; also elsewhere on the board
APPS1: P2.15; also elsewhere on the board
APPS1_10: P2.7; also elsewhere on the board
APPS1_RTN: P2.11; also elsewhere on the board
APPS2: P2.17; also elsewhere on the board
APPS2_5: P2.9; also elsewhere on the board
BOT: P2.18; also elsewhere on the board
BP: P2.16; also elsewhere on the board
CANH: P2.1; also elsewhere on the board
CANL: P2.3; also elsewhere on the board
CC_LED: P3.2; also elsewhere on the board
CH_GND: CON1.2, CON1.10, P2.8, P2.10, P2.12, P2.13, P3.1, P3.14; also elsewhere on the board
Drive_BTN: P3.8; also elsewhere on the board
Drive_LED: P3.10; also elsewhere on the board
HV+: P1.2; also elsewhere on the board
HV-: P1.1; also elsewhere on the board
HVPL: P2.2, P2.4, P2.6; also elsewhere on the board
I/O_Ground: J4.1, J4.3; also elsewhere on the board
IMD_Fault_LED: P3.4; also elsewhere on the board
IMD_PWM: P3.13; also elsewhere on the board
IMD_Status: P3.11; also elsewhere on the board
I_RTN: J5.4; also elsewhere on the board
RTDS: P3.12; also elsewhere on the board
SCL: J1.3; also elsewhere on the board
SDA: J1.4; also elsewhere on the board
Spare_ADC_1: J1.7; also elsewhere on the board
Spare_ADC_2: J1.8; also elsewhere on the board
Spare_ICP: J1.6; also elsewhere on the board
Spare_OC: J1.5; also elsewhere on the board
TCK: CON1.1; also elsewhere on the board
TDI: CON1.9; also elsewhere on the board
TDO: CON1.3; also elsewhere on the board
TMS: CON1.5; also elsewhere on the board
Throttle_HV: J4.2; also elsewhere on the board
UART_RX: J1.1; also elsewhere on the board
UART_TX: J1.2; also elsewhere on the board
~RESET_AVR: CON1.6; also elsewhere on the board

Notes on the sheet:
To Cockpit
Motor Controller
AIRs
CAN Bus
High Voltage
IMD
GLV
Spare connections to uC
RTDS
Pedals
HVPL
Removed Cockpit Return

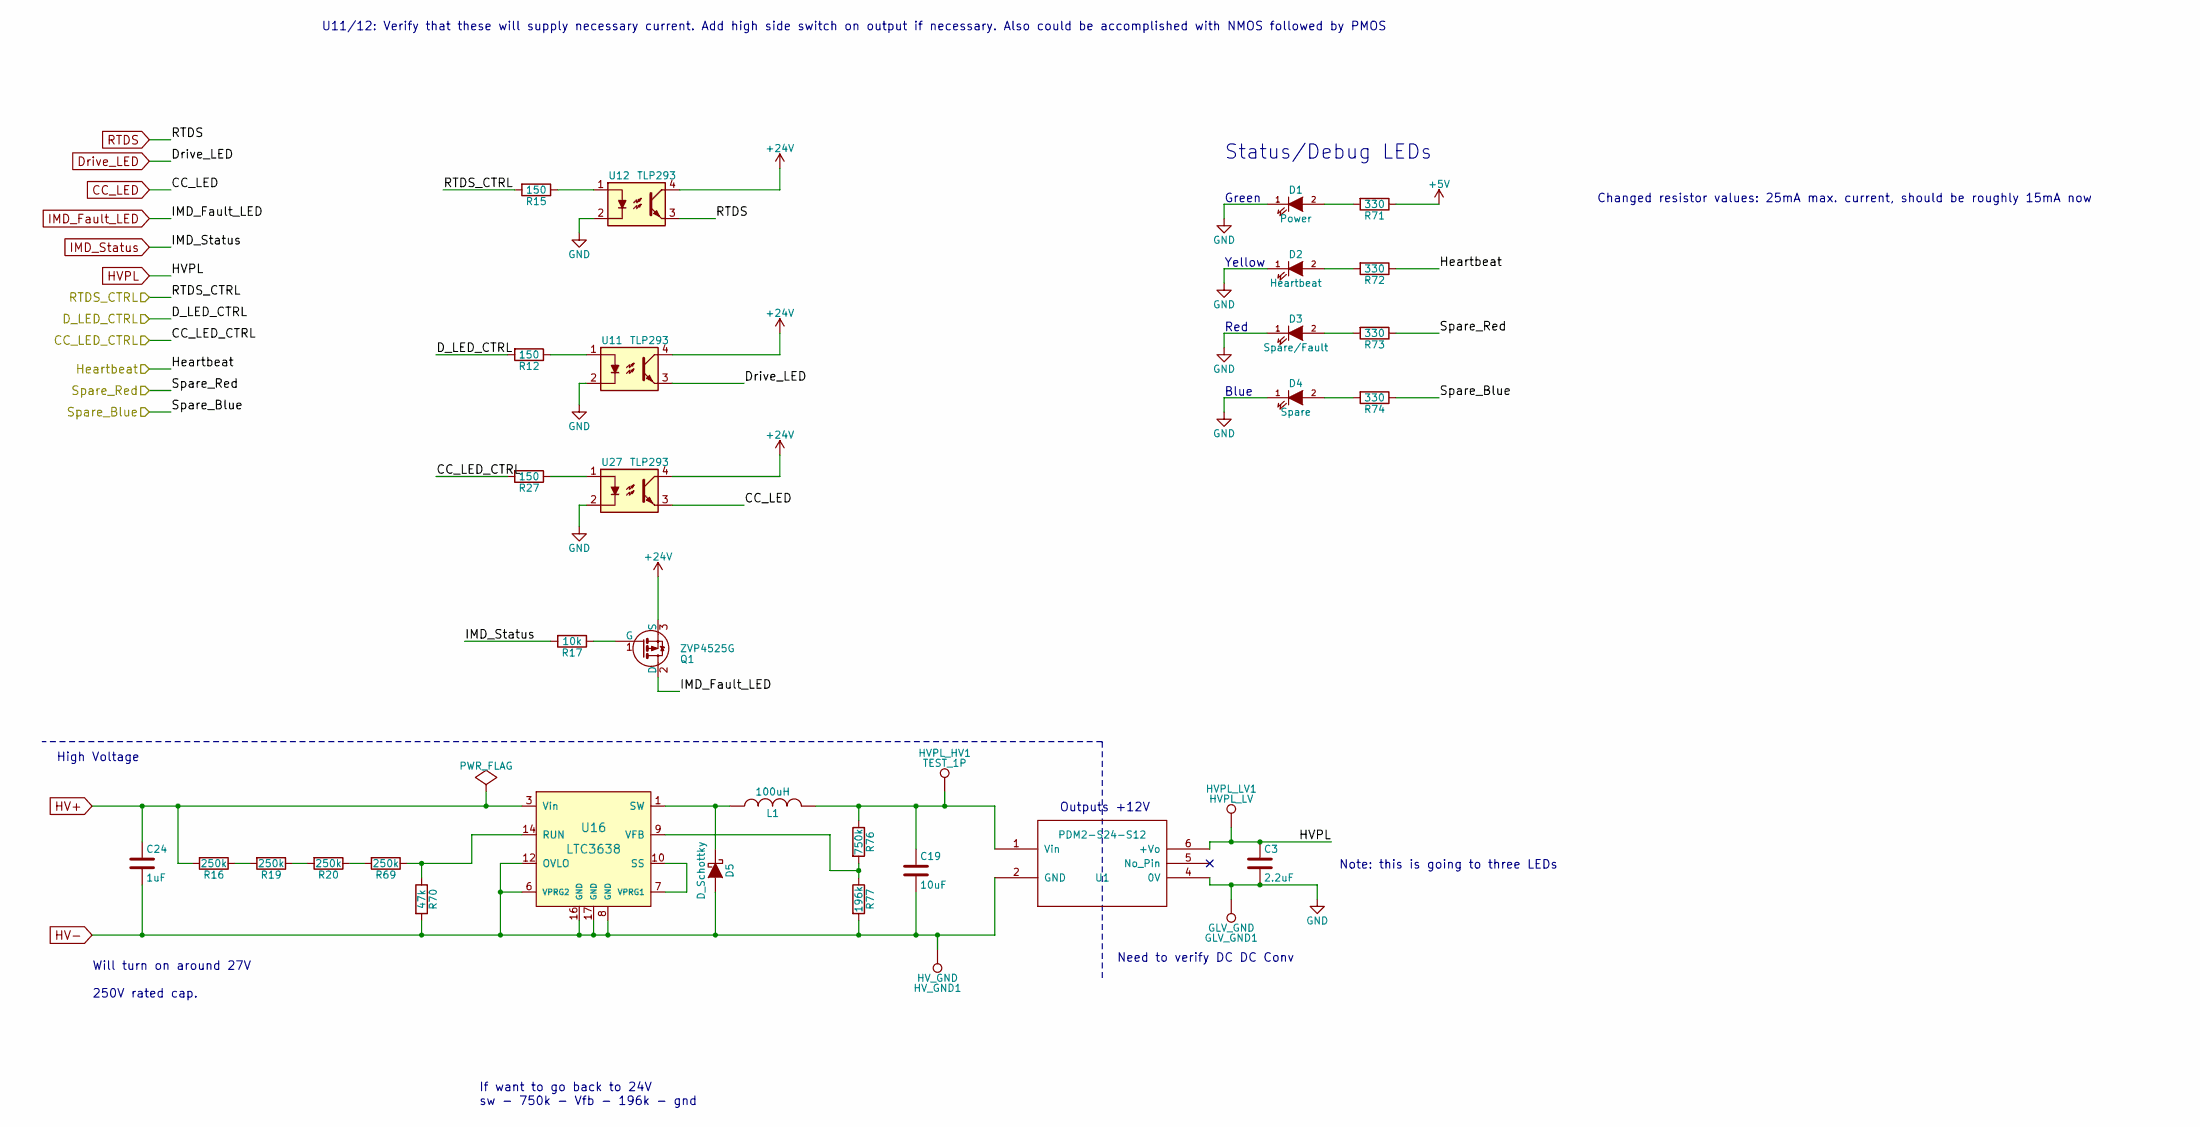
[picture p42: schematic StatusLights.sch, Tractive System Interface]

Parts:
C3: 2.2uF; C_0805_HandSoldering; DigiKey P/N 587-1293-1-ND
C19: 10uF; C_0805_HandSoldering; DigiKey P/N 490-10515-1-ND
C24: 1uF; C_2220_HandSoldering; DigiKey P/N 490-3550-1-ND
D1: Power; LED_0805; DigiKey P/N 475-1410-1-ND
D2: Heartbeat; LED_0805; DigiKey P/N 475-2560-1-ND
D3: Spare/Fault; LED_0805; DigiKey P/N 475-1278-1-ND
D4: Spare; LED_0805; DigiKey P/N 516-1445-1-ND
D5: D_Schottky; do214ac; DigiKey P/N SK310A-LTPMSCT-ND
GLV_GND1: GLV_GND; Measurement_Point_Square-SMD-Pad_Big
HVPL_HV1: TEST_1P; Measurement_Point_Round-SMD-Pad_Big
HVPL_LV1: HVPL_LV; Measurement_Point_Round-SMD-Pad_Big
HV_GND1: HV_GND; Measurement_Point_Square-SMD-Pad_Big
L1: 100uH; Inductor_Taiyo-Yuden_NR-80xx_HandSoldering; DigiKey P/N 587-2004-1-ND
Q1: ZVP4525G; SOT-223-3Lead_TabPin2; DigiKey P/N ZVP4525GCT-ND
R12, R15, R27: 150; R_0805_HandSoldering; DigiKey P/N 311-150CRCT-ND
R16, R19, R20, R69: 250k; R_0805_HandSoldering; DigiKey P/N P249KCCT-ND
R17: 10k; R_0805_HandSoldering; DigiKey P/N P10.0KCCT-ND
R70: 47k; R_0805_HandSoldering; DigiKey P/N 311-47.0KCRCT-ND
R71, R72, R73, R74: 330; R_0805_HandSoldering; DigiKey P/N P330CCT-ND
R76: 750k; R_0805_HandSoldering; DigiKey P/N P750KCCT-ND
R77: 196k; R_0805_HandSoldering; DigiKey P/N P196CCT-ND
U1: PDM2-S24-S12; DCDC-Conv_TRACO_TMR_1-xxxx_Single; DigiKey P/N 102-2728-ND
U11, U12, U27: TLP293; SOP-4_4.4x2.8mm_Pitch1.27mm; DigiKey P/N TLP293(GB-TPLECT-ND
U16: LTC3638; TSSOP16_LTC3638; DigiKey P/N LTC3638EMSE#PBF-ND

Connections:
+5V: R71.1; also elsewhere on the board
+24V: Q1.3 (S), U11.4, U12.4, U27.4; also elsewhere on the board
/Status Lights/CC_LED_CTRL: R27.2; also elsewhere on the board
/Status Lights/D_LED_CTRL: R12.2; also elsewhere on the board
/Status Lights/Heartbeat: R72.1; also elsewhere on the board
/Status Lights/RTDS_CTRL: R15.2; also elsewhere on the board
/Status Lights/Spare_Blue: R74.1; also elsewhere on the board
/Status Lights/Spare_Red: R73.1; also elsewhere on the board
CC_LED: U27.3; also elsewhere on the board
CH_GND: C3.2, D1.1 (K), D2.1 (K), D3.1 (K), D4.1 (K), GLV_GND1.1, U1.4 (0V), U11.2, U12.2, U27.2; also elsewhere on the board
Drive_LED: U11.3; also elsewhere on the board
HV+: C24.1, R16.2, U16.3 (Vin); also elsewhere on the board
HV-: C19.2, C24.2, D5.2 (A), HV_GND1.1, R70.2, R77.2, U1.2 (GND), U16.6 (VPRG2), U16.8 (GND), U16.12 (OVLO), U16.16 (GND), U16.17 (GND); also elsewhere on the board
HVPL: C3.1, HVPL_LV1.1, U1.6 (+Vo); also elsewhere on the board
IMD_Fault_LED: Q1.2 (D); also elsewhere on the board
IMD_Status: R17.2; also elsewhere on the board
unnamed: C19.1, HVPL_HV1.1, L1.2, R76.1, U1.1 (Vin)
unnamed: D1.2 (A), R71.2
unnamed: D2.2 (A), R72.2
unnamed: D3.2 (A), R73.2
unnamed: D4.2 (A), R74.2
unnamed: D5.1 (K), L1.1, U16.1 (SW)
unnamed: Q1.1 (G), R17.1
unnamed: R12.1, U11.1
unnamed: R15.1, U12.1
unnamed: R16.1, R19.2
unnamed: R19.1, R20.2
unnamed: R20.1, R69.2
unnamed: R27.1, U27.1
unnamed: R69.1, R70.1, U16.14 (RUN)
unnamed: R76.2, R77.1, U16.9 (VFB)
unnamed: U16.7 (VPRG1), U16.10 (SS)
RTDS: U12.3; also elsewhere on the board

Notes on the sheet:
Green
Yellow
Red
Blue
Status/Debug LEDs
High Voltage
If want to go back to 24V sw - 750k - Vfb - 196k - gnd
Will turn on around 27V 250V rated cap.
Changed resistor values: 25mA max. current, should be roughly 15mA now
Note: this is going to three LEDs
Need to verify DC DC Conv
Outputs +12V
U11/12: Verify that these will supply necessary current. Add high side switch on output if necessary. Also could be accomplished with NMOS followed by PMOS

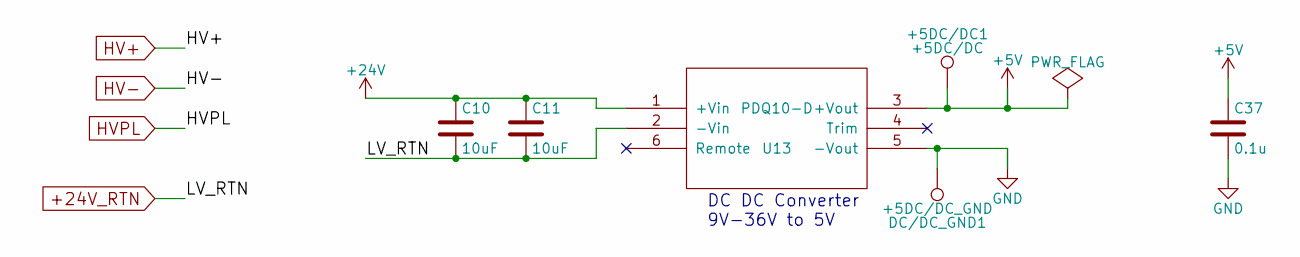
[picture p43: schematic PowerSystem.sch, Tractive System Interface]

Parts:
+5DC/DC1: +5DC/DC; Measurement_Point_Round-SMD-Pad_Big
C10, C11: 10uF; C_0805_HandSoldering; DigiKey P/N 490-10515-1-ND
C37: 0.1u; C_0805_HandSoldering; Digikey P/N 399-1168-1-ND
DC/DC_GND1: +5DC/DC_GND; Measurement_Point_Square-SMD-Pad_Big
U13: PDQ10-D; PDQ_DCDC; DigiKey P/N 102-3865-ND

Connections:
+5V: +5DC/DC1.1, C37.1, U13.3 (+Vout); also elsewhere on the board
+24V: C10.1, C11.1, U13.1 (+Vin); also elsewhere on the board
+24V_RTN: C10.2, C11.2, U13.2 (-Vin); also elsewhere on the board
CH_GND: C37.2, DC/DC_GND1.1, U13.5 (-Vout); also elsewhere on the board

Notes on the sheet:
DC DC Converter 9V-36V to 5V

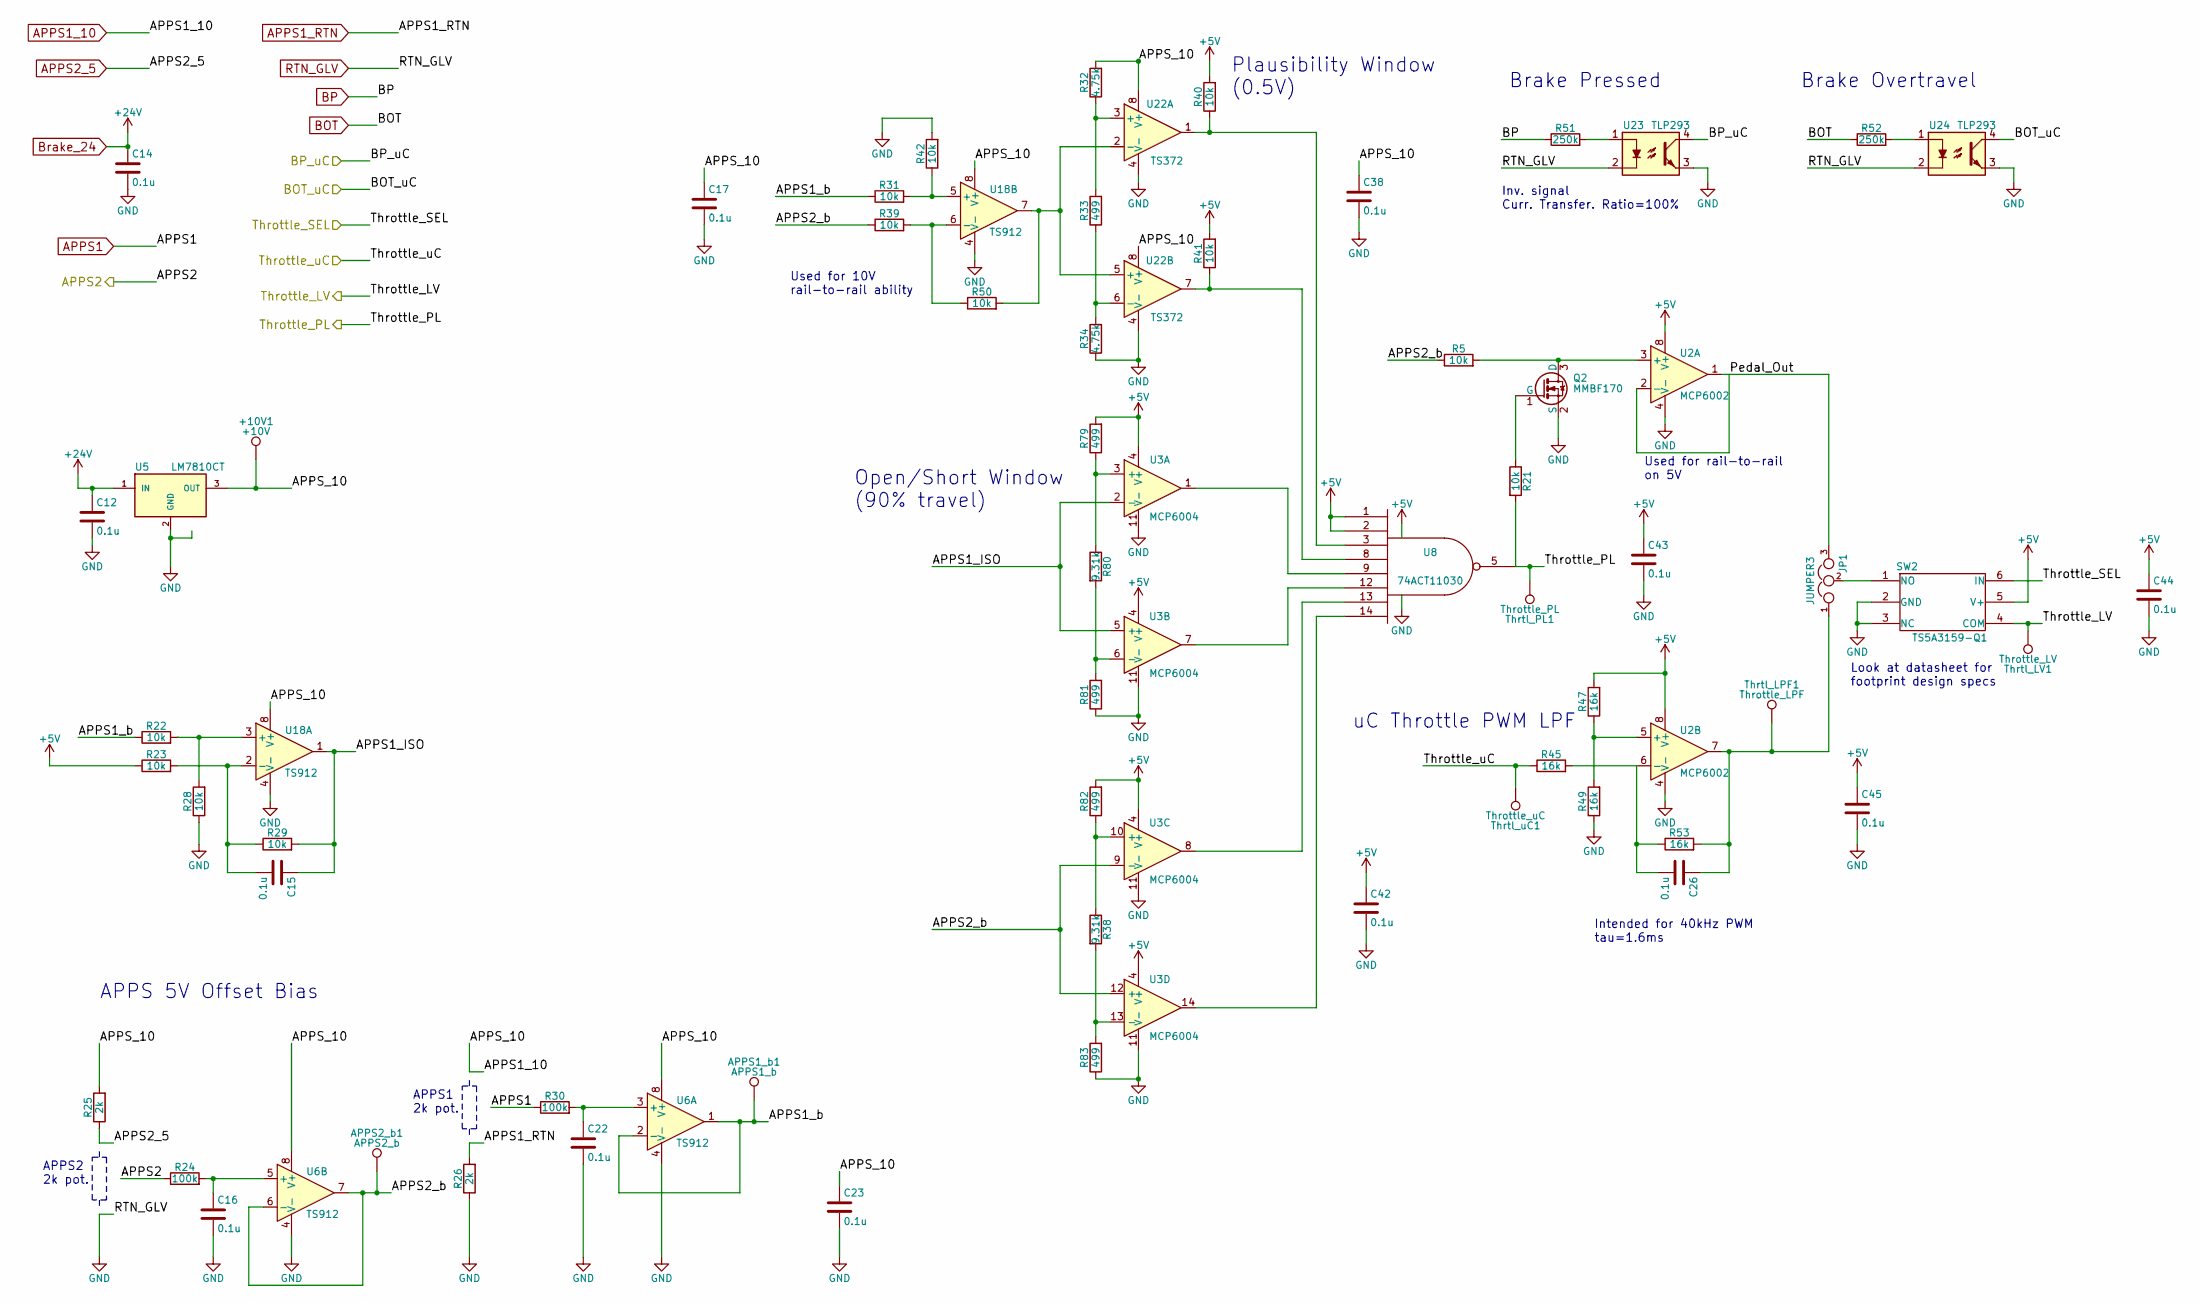
[picture p44: schematic ThrottlePlausibility.sch, Tractive System Interface]

Parts:
+10V1: +10V; Measurement_Point_Round-SMD-Pad_Big
APPS1_b1: APPS1_b; Measurement_Point_Round-SMD-Pad_Big
APPS2_b1: APPS2_b; Measurement_Point_Round-SMD-Pad_Big
C12, C14, C15, C16, C17, C22, C23, C26, C38, C42, C43, C44, C45: 0.1u; C_0805_HandSoldering; Digikey P/N 399-1168-1-ND
JP1: JUMPER3; Pin_Header_Straight_1x03_Pitch2.54mm; DigiKey P/N Z5375-ND
Q2: MMBF170; SOT-23; Digikey P/N MMBF170CT-ND
R5, R21, R22, R23, R28, R29, R31, R39, R40, R41, R42, R50: 10k; R_0805_HandSoldering; DigiKey P/N P10.0KCCT-ND
R24, R30: 100k; R_0805_HandSoldering; DigiKey P/N P100KCCT-ND
R25, R26: 2k; R_0805_HandSoldering; DigiKey P/N P2.00KCCT-ND
R32, R34: 4.75k; R_0805_HandSoldering; DigiKey P/N P4.75KCCT-ND
R33, R79, R81, R82, R83: 499; R_0805_HandSoldering; DigiKey P/N P499DACT-ND
R38, R80: 9.31k; R_0805_HandSoldering; Digikey P/N P9.31KCCT-ND
R45, R47, R49, R53: 16k; R_0805_HandSoldering; DigiKey P/N P16KACT-ND
R51, R52: 250k; R_0805_HandSoldering; DigiKey P/N P249KCCT-ND
SW2: TS5A3159-Q1; SOT-23-6_Handsoldering; DigiKey P/N 296-39512-1-ND
Thrtl_LPF1: Throttle_LPF; Measurement_Point_Round-SMD-Pad_Big
Thrtl_LV1: Throttle_LV; Measurement_Point_Round-SMD-Pad_Big
Thrtl_PL1: Throttle_PL; Measurement_Point_Round-SMD-Pad_Big
Thrtl_uC1: Throttle_uC; Measurement_Point_Round-SMD-Pad_Big
U2: MCP6002; SOIC-8_3.9x4.9mm_Pitch1.27mm; DigiKey P/N MCP6002T-I/SNCT-ND
U3: MCP6004; SOIC-14_3.9x8.7mm_Pitch1.27mm; Digikey P/N MCP6004T-I/SLCT-ND
U5: LM7810CT; TO-220_Horizontal_Plated_Hole; DigiKey P/N LM7810CT-ND
U6, U18: TS912; SOIC-8_3.9x4.9mm_Pitch1.27mm; DigiKey P/N 497-10252-1-ND
U8: 74ACT11030; SOIC-14_3.9x8.7mm_Pitch1.27mm; Digikey P/N 296-4180-1-ND
U22: TS372; SOIC-8_3.9x4.9mm_Pitch1.27mm; DigiKey P/N 497-2271-1-ND
U23, U24: TLP293; SOP-4_4.4x2.8mm_Pitch1.27mm; DigiKey P/N TLP293(GB-TPLECT-ND

Connections:
+5V: C42.1, C43.1, C44.1, C45.1, R23.1, R40.2, R41.2, R47.2, R79.2, R82.2, SW2.5 (V+), U2.8 (V+), U3.4 (V+), U8.1, U8.2, U8.11 (VCC); also elsewhere on the board
+24V: C12.1, C14.1, U5.1 (IN); also elsewhere on the board
/Isolators/Throttle_LV: SW2.4 (COM), Thrtl_LV1.1; also elsewhere on the board
/ThrottlePlausibility/APPS1_ISO: C15.1, R29.2, U3.2 (-), U3.5 (+), U18.1
/ThrottlePlausibility/APPS1_b: APPS1_b1.1, R22.1, R31.1, U6.1, U6.2 (-)
/ThrottlePlausibility/APPS2_b: APPS2_b1.1, R5.1, R39.1, U3.9 (-), U3.12 (+), U6.6 (-), U6.7
/ThrottlePlausibility/BOT_uC: U24.4; also elsewhere on the board
/ThrottlePlausibility/BP_uC: U23.4; also elsewhere on the board
/ThrottlePlausibility/Pedal_Out: JP1.3, U2.1, U2.2 (-)
/ThrottlePlausibility/Throttle_PL: R21.2, Thrtl_PL1.1, U8.5; also elsewhere on the board
/ThrottlePlausibility/Throttle_SEL: SW2.6 (IN); also elsewhere on the board
/ThrottlePlausibility/Throttle_uC: R45.1, Thrtl_uC1.1; also elsewhere on the board
APPS1: R30.1; also elsewhere on the board
APPS1_10: +10V1.1, C17.1, C23.1, C38.1, R25.2, R32.2, U5.3 (OUT), U6.8 (V+), U18.8 (V+), U22.8 (V+); also elsewhere on the board
APPS1_RTN: R26.2; also elsewhere on the board
APPS2: R24.1; also elsewhere on the board
APPS2_5: R25.1; also elsewhere on the board
BOT: R52.1; also elsewhere on the board
BP: R51.1; also elsewhere on the board
CH_GND: C12.2, C14.2, C16.2, C17.2, C22.2, C23.2, C38.2, C42.2, C43.2, C44.2, C45.2, Q2.2 (S), R26.1, R28.1, R34.1, R42.2, R49.1, R81.1, R83.1, SW2.2 (GND), SW2.3 (NC), U2.4 (V-), U3.11 (V-), U5.0 (GND), U5.2 (GND), U6.4 (V-), U8.4 (GND), U18.4 (V-), U22.4 (V-), U23.2, U23.3, U24.2, U24.3; also elsewhere on the board
unnamed: C15.2, R23.2, R29.1, U18.2 (-)
unnamed: C16.1, R24.2, U6.5 (+)
unnamed: C22.1, R30.2, U6.3 (+)
unnamed: C26.1, JP1.1, R53.2, Thrtl_LPF1.1, U2.7
unnamed: C26.2, R45.2, R53.1, U2.6 (-)
unnamed: JP1.2, SW2.1 (NO)
unnamed: Q2.1 (G), R21.1
unnamed: Q2.3 (D), R5.2, U2.3 (+)
unnamed: R22.2, R28.2, U18.3 (+)
unnamed: R31.2, R42.1, U18.5 (+)
unnamed: R32.1, R33.2, U22.3 (+)
unnamed: R33.1, R34.2, U22.6 (-)
unnamed: R38.1, R82.1, U3.10 (+)
unnamed: R38.2, R83.2, U3.13 (-)
unnamed: R39.2, R50.1, U18.6 (-)
unnamed: R40.1, U8.3, U22.1
unnamed: R41.1, U8.8, U22.7
unnamed: R47.1, R49.2, U2.5 (+)
unnamed: R50.2, U18.7, U22.2 (-), U22.5 (+)
unnamed: R51.2, U23.1
unnamed: R52.2, U24.1
unnamed: R79.1, R80.1, U3.3 (+)
unnamed: R80.2, R81.2, U3.6 (-)
unnamed: U3.1, U8.9
unnamed: U3.7, U8.12
unnamed: U3.8, U8.13
unnamed: U3.14, U8.14

Notes on the sheet:
Used for 10V rail-to-rail ability
Used for rail-to-rail on 5V
Intended for 40kHz PWM tau=1.6ms
Plausibility Window (0.5V)
uC Throttle PWM LPF
Brake Pressed
Open/Short Window (90% travel)
APPS2 2k pot.
APPS1 2k pot.
Brake Overtravel
Inv. signal Curr. Transfer. Ratio=100%
APPS 5V Offset Bias
Look at datasheet for footprint design specs
