austinmam/TSI/pacman_hardware_rev_0_8/project/pacman-main.kicad_pcb

## KiCad design pacman_hardware_rev_0_8/project/pacman-main.kicad_pcb (2017-02-16, last stored version)

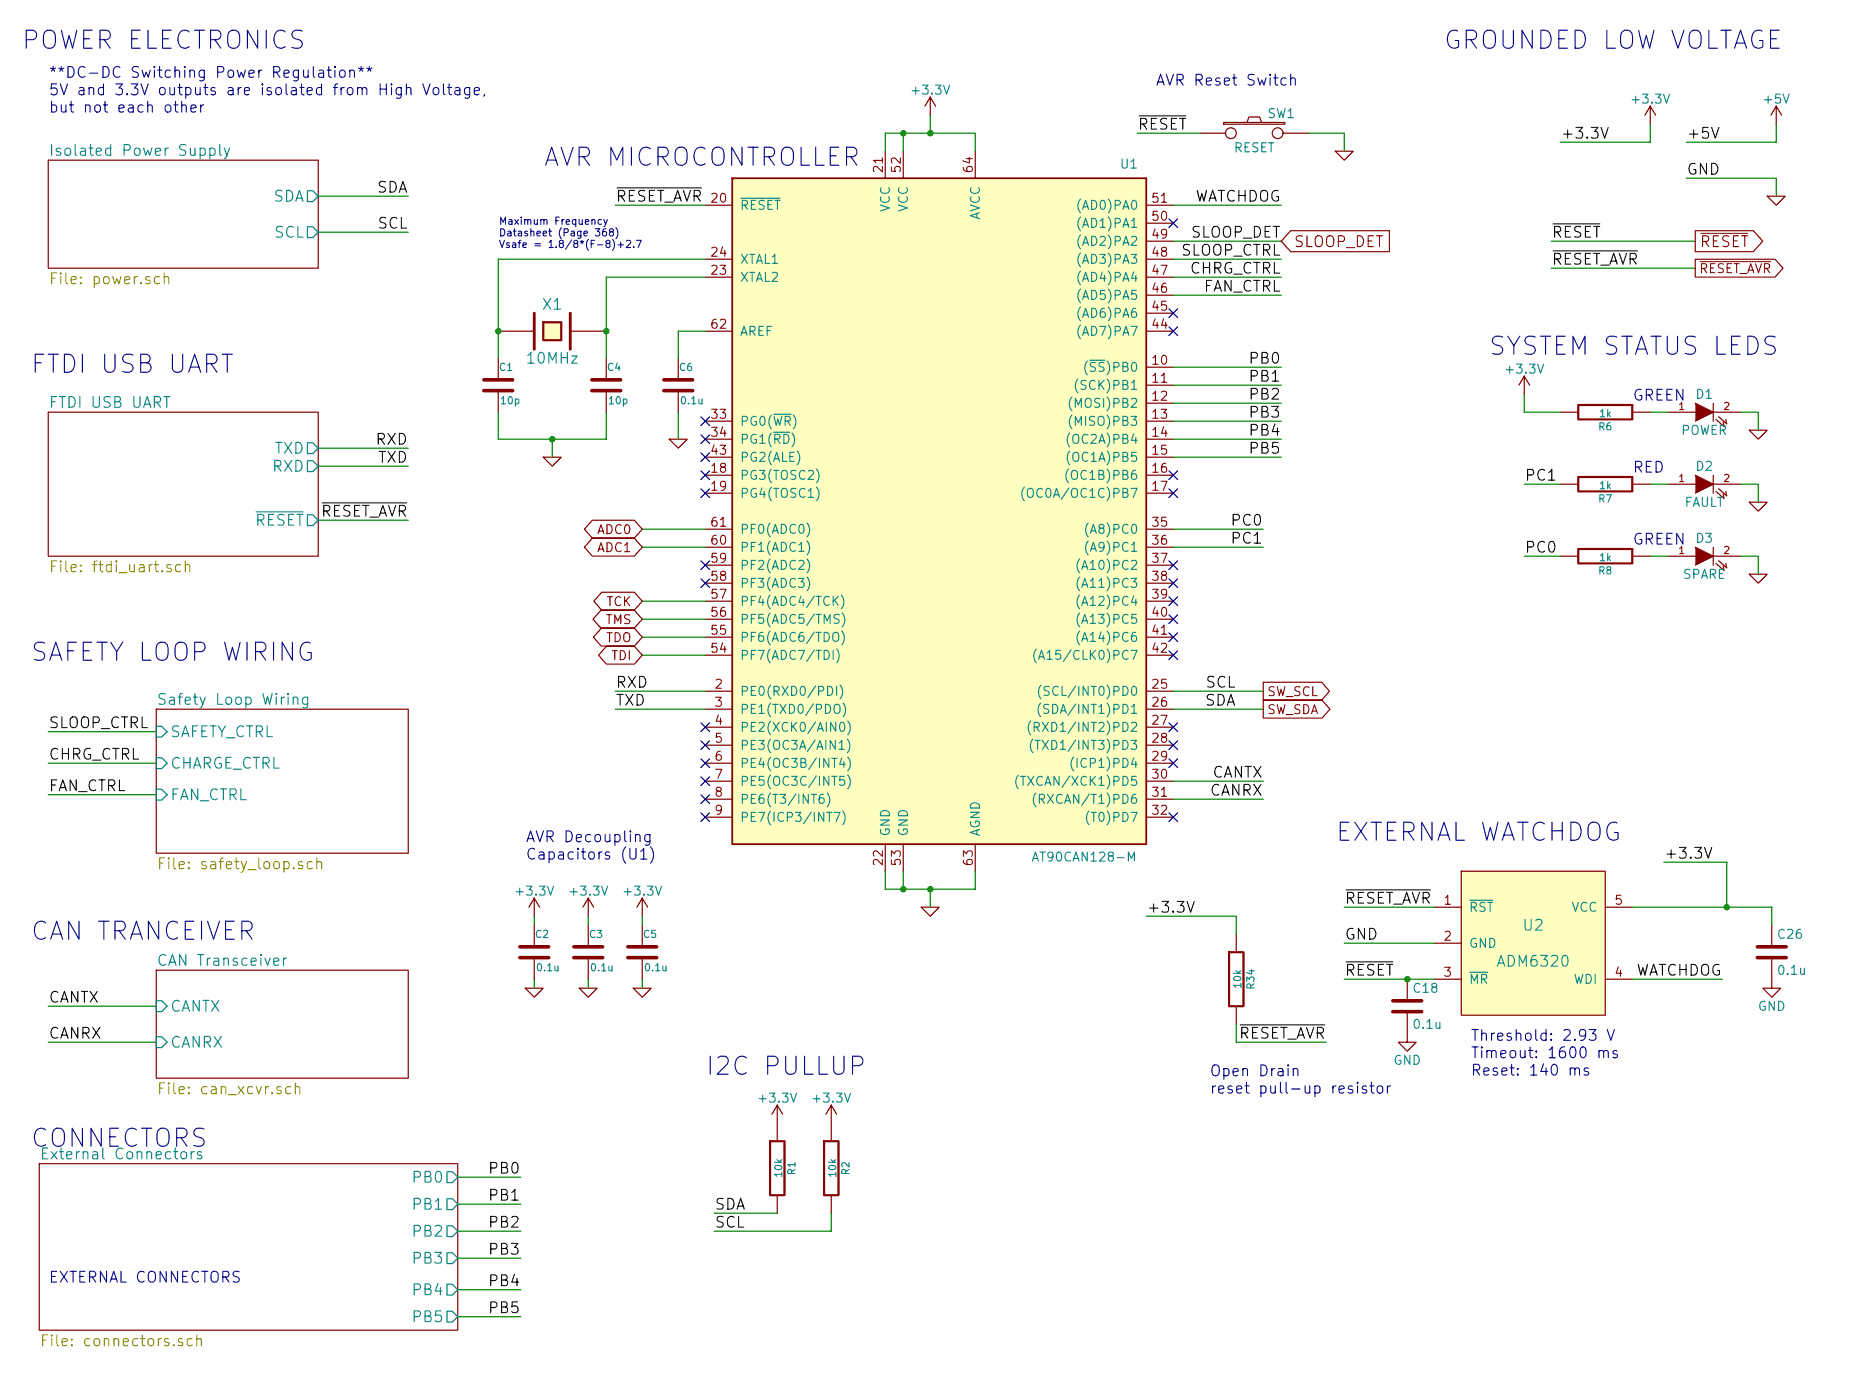
[picture p49: schematic pacman-main.sch, Battery Pack Management Computer]

Parts:
C1, C4: 10p; C_0603_HandSoldering; Manufacturer P/N GRM0335C1H100JA01D
C2, C3, C5, C6: 0.1u; C_0603_HandSoldering
C18, C26: 0.1u; C_0603_HandSoldering; Manufacturer P/N GRM188R71E104KA01D
D1: POWER; LED_0603
D2: FAULT; LED_0603
D3: SPARE; LED_0603
R1, R2, R34: 10k; R_0603_HandSoldering
R6, R7, R8: 1k; R_0603_HandSoldering
SW1: RESET; SW_RACON_8; Manufacturer P/N 1.14100.5030000
U1: AT90CAN128-M; TQFP-64_14x14mm_Pitch0.8mm; Manufacturer P/N AT90CAN128-16AUR
U2: ADM6320; SOT-23-5; Manufacturer P/N ADM6320CY29ARJZ-R7
X1: 10MHz; crystal_TXC_7A; Manufacturer P/N 7A-10.000MAAE-T

Connections:
+3V3: C2.1, C3.1, C5.1, C26.1, R1.1, R2.1, R6.2, R34.1, U1.21 (VCC), U1.52 (VCC), U1.64 (AVCC), U2.5 (VCC); also elsewhere on the board
/CAN Transceiver/CANRX: U1.31 ((RXCAN/T1)PD6); also elsewhere on the board
/CAN Transceiver/CANTX: U1.30 ((TXCAN/XCK1)PD5); also elsewhere on the board
/External Connectors/PB0: U1.10 ((~SS~)PB0); also elsewhere on the board
/External Connectors/PB1: U1.11 ((SCK)PB1); also elsewhere on the board
/External Connectors/PB2: U1.12 ((MOSI)PB2); also elsewhere on the board
/External Connectors/PB3: U1.13 ((MISO)PB3); also elsewhere on the board
/External Connectors/PB4: U1.14 ((OC2A)PB4); also elsewhere on the board
/External Connectors/PB5: U1.15 ((OC1A)PB5); also elsewhere on the board
/FTDI USB UART/RXD: U1.3 (PE1(TXD0/PDO)); also elsewhere on the board
/FTDI USB UART/TXD: U1.2 (PE0(RXD0/PDI)); also elsewhere on the board
/PC0: R8.2, U1.35 ((A8)PC0)
/PC1: R7.2, U1.36 ((A9)PC1)
/Safety Loop Wiring/CHARGE_CTRL: U1.47 ((AD4)PA4); also elsewhere on the board
/Safety Loop Wiring/FAN_CTRL: U1.46 ((AD5)PA5); also elsewhere on the board
/Safety Loop Wiring/SAFETY_CTRL: U1.48 ((AD3)PA3); also elsewhere on the board
/WATCHDOG: U1.51 ((AD0)PA0), U2.4 (WDI)
ADC0: U1.61 (PF0(ADC0)); also elsewhere on the board
ADC1: U1.60 (PF1(ADC1)); also elsewhere on the board
GND: C1.2, C2.2, C3.2, C4.2, C5.2, C6.2, C18.2, C26.2, D1.2 (K), D2.2 (K), D3.2 (K), SW1.2, U1.22 (GND), U1.53 (GND), U1.63 (AGND), U2.2 (GND); also elsewhere on the board
unnamed: C1.1, U1.24 (XTAL1), X1.1
unnamed: C4.1, U1.23 (XTAL2), X1.2
unnamed: C6.1, U1.62 (AREF)
unnamed: D1.1 (A), R6.1
unnamed: D2.1 (A), R7.1
unnamed: D3.1 (A), R8.1
SLOOP_DET: U1.49 ((AD2)PA2); also elsewhere on the board
SW_SCL: R2.2, U1.25 ((SCL/INT0)PD0); also elsewhere on the board
SW_SDA: R1.2, U1.26 ((SDA/INT1)PD1); also elsewhere on the board
TCK: U1.57 (PF4(ADC4/TCK)); also elsewhere on the board
TDI: U1.54 (PF7(ADC7/TDI)); also elsewhere on the board
TDO: U1.55 (PF6(ADC6/TDO)); also elsewhere on the board
TMS: U1.56 (PF5(ADC5/TMS)); also elsewhere on the board
~RESET: C18.1, SW1.1, U2.3 (~MR); also elsewhere on the board
~RESET_AVR: R34.2, U1.20 (~RESET), U2.1 (~RST); also elsewhere on the board

Notes on the sheet:
AVR Reset Switch
AVR Decoupling Capacitors (U1)
AVR MICROCONTROLLER
SYSTEM STATUS LEDS
POWER ELECTRONICS
Maximum Frequency Datasheet (Page 368) Vsafe = 1.8/8*(F-8)+2.7
EXTERNAL WATCHDOG
**DC-DC Switching Power Regulation** 5V and 3.3V outputs are isolated from High Voltage, but not each other
FTDI USB UART
I2C PULLUP
Threshold: 2.93 V Timeout: 1600 ms Reset: 140 ms
EXTERNAL CONNECTORS
GROUNDED LOW VOLTAGE
SAFETY LOOP WIRING
CONNECTORS
CAN TRANCEIVER
Open Drain reset pull-up resistor
GREEN
RED

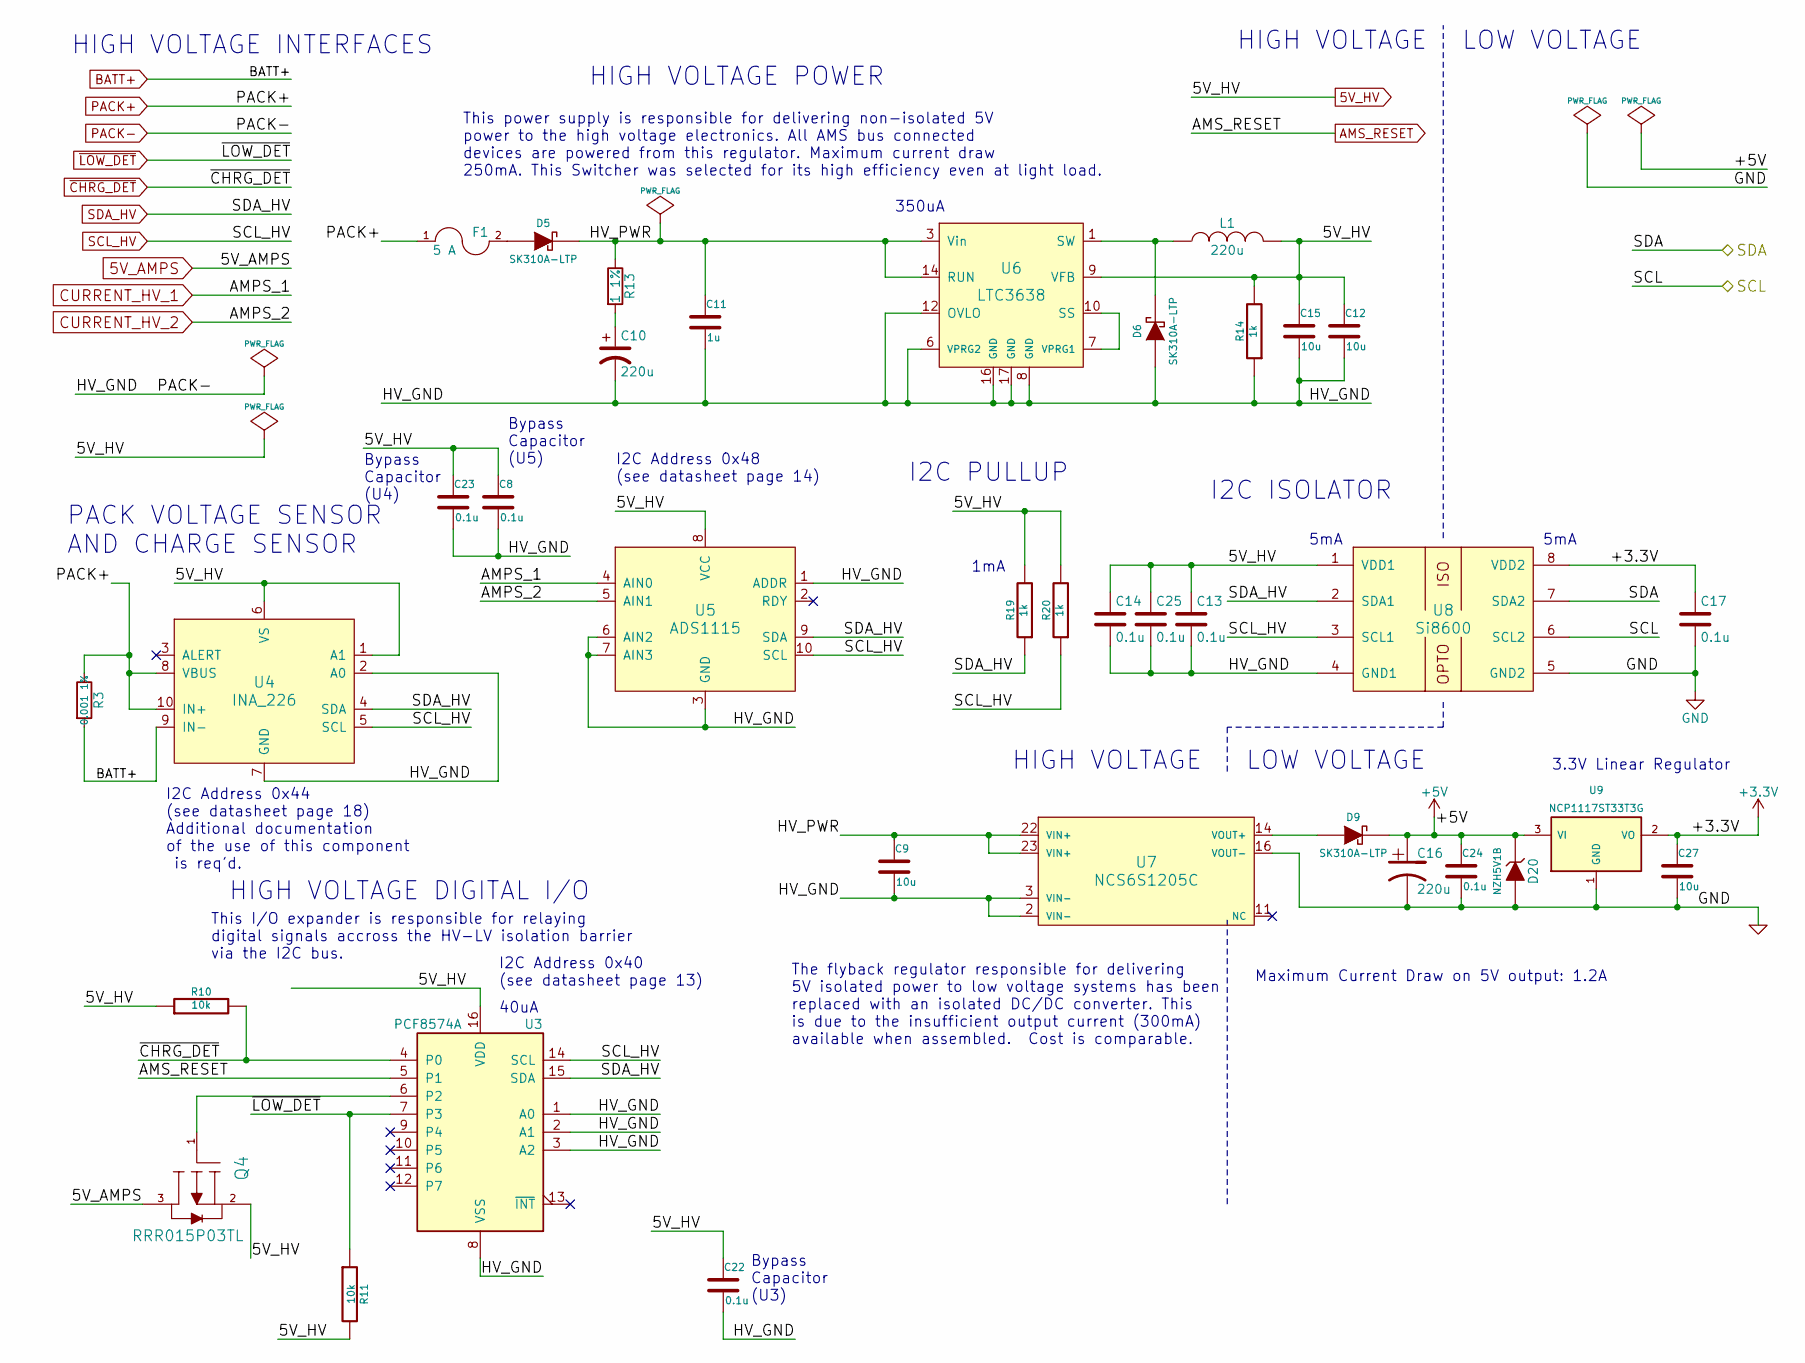
[picture p50: schematic power.sch, Battery Pack Management Computer]

Parts:
C8, C13, C14, C17, C22, C23, C24, C25: 0.1u; C_0603_HandSoldering
C9, C12, C15: 10u; C_1210_HandSoldering; Manufacturer P/N GRM32DF51H106ZA01L
C10: 220u; c_elec_10x10; Manufacturer P/N UCW1H221MNL1GS
C11: 1u; C_0603_HandSoldering; Manufacturer P/N CL10A105KB8NNNC
C16: 220u; c_elec_6.3x7.7; Manufacturer P/N UUR1C221MCL6GS
C27: 10u; C_1210_HandSoldering; Manufacturer P/N CL32A106KAULNNE
D5, D6, D9: SK310A-LTP; do214ac; Manufacturer P/N SK310A-LTP
D20: NZH5V1B; sod123; Manufacturer P/N NZH5V1B
F1: 5 A; blade_fuse_holder; Manufacturer P/N BK-6010
L1: 220u; SELF-WE-TPC_M; Manufacturer P/N VLS6045EX-221M
Q4: RRR015P03TL; sot346; Manufacturer P/N RRR015P03TL
R3: 0.001 1%; CSNL1206; Manufacturer P/N CSNL1206FT1L00
R10, R11: 10k; R_0603_HandSoldering
R13: 1 1%; R_0805_HandSoldering
R14, R19, R20: 1k; R_0805_HandSoldering
U3: PCF8574A; SOIC-16_7.5x10.3mm_Pitch1.27mm; Manufacturer P/N PCF8574AT3518
U4: INA_226; msop_10_ads1015; Manufacturer P/N INA226AIDGSR
U5: ADS1115; msop_10_ads1015; Manufacturer P/N ADS1115IDGSR
U6: LTC3638; TSSOP16_LTC3638; Manufacturer P/N LTC3638EMSE#PBF
U7: NCS6S1205C; Manufacturer P/N NCS6S1205C
U8: Si8600; SOIC-8_3.9x4.9mm_Pitch1.27mm; Manufacturer P/N Si8600AC-B-IS
U9: NCP1117ST33T3G; SOT-223; Manufacturer P/N NCP1117ST33T3G

Connections:
5V_AMPS: Q4.3 (S); also elsewhere on the board
5V_HV: C8.1, C12.1, C13.1, C14.1, C15.1, C22.1, C23.1, C25.1, L1.2, Q4.2 (D), R10.1, R11.2, R14.2, R19.2, R20.2, U3.16 (VDD), U4.1 (A1), U4.6 (VS), U5.8 (VCC), U6.9 (VFB), U8.1 (VDD1); also elsewhere on the board
+3V3: C17.1, C27.1, U8.8 (VDD2), U9.2 (VO); also elsewhere on the board
+5V: C16.1, C24.1, D9.2 (K), D20.2 (K), U9.3 (VI); also elsewhere on the board
/Isolated Power Supply/HV_PWR: C9.1, C11.1, D5.2 (K), R13.1, U6.3 (Vin), U6.14 (RUN), U7.22 (VIN+), U7.23 (VIN+)
AMS_RESET: U3.5 (P1); also elsewhere on the board
BATT+: R3.2, U4.9 (IN-); also elsewhere on the board
CURRENT_HV_1: U5.4 (AIN0); also elsewhere on the board
CURRENT_HV_2: U5.5 (AIN1); also elsewhere on the board
GND: C16.2, C17.2, C24.2, C27.2, D20.1 (A), U7.16 (VOUT-), U8.5 (GND2), U9.1 (GND); also elsewhere on the board
unnamed: C10.1, R13.2
unnamed: D5.1 (A), F1.2
unnamed: D6.2 (K), L1.1, U6.1 (SW)
unnamed: D9.1 (A), U7.14 (VOUT+)
unnamed: Q4.1 (G), U3.6 (P2)
unnamed: U6.7 (VPRG1), U6.10 (SS)
PACK+: F1.1, R3.1, U4.8 (VBUS), U4.10 (IN+); also elsewhere on the board
PACK-: C8.2, C9.2, C10.2, C11.2, C12.2, C13.2, C14.2, C15.2, C22.2, C23.2, C25.2, D6.1 (A), R14.1, U3.1 (A0), U3.2 (A1), U3.3 (A2), U3.8 (VSS), U4.2 (A0), U4.7 (GND), U5.1 (ADDR), U5.3 (GND), U5.6 (AIN2), U5.7 (AIN3), U6.6 (VPRG2), U6.8 (GND), U6.12 (OVLO), U6.16 (GND), U6.17 (GND), U7.2 (VIN-), U7.3 (VIN-), U8.4 (GND1); also elsewhere on the board
SCL_HV: R20.1, U3.14 (SCL), U4.5 (SCL), U5.10 (SCL), U8.3 (SCL1); also elsewhere on the board
SDA_HV: R19.1, U3.15 (SDA), U4.4 (SDA), U5.9 (SDA), U8.2 (SDA1); also elsewhere on the board
SW_SCL: U8.6 (SCL2); also elsewhere on the board
SW_SDA: U8.7 (SDA2); also elsewhere on the board
~CHRG_DET: R10.2, U3.4 (P0); also elsewhere on the board
~LOW_DET: R11.1, U3.7 (P3); also elsewhere on the board

Notes on the sheet:
3.3V Linear Regulator
HIGH VOLTAGE
LOW VOLTAGE
PACK VOLTAGE SENSOR AND CHARGE SENSOR
HIGH VOLTAGE POWER
The flyback regulator responsible for delivering 5V isolated power to low voltage systems has been replaced with an isolated DC/DC converter. This is due to the insufficient output current (300mA) available when assembled. Cost is comparable.
HIGH VOLTAGE INTERFACES
HIGH VOLTAGE DIGITAL I/O
I2C PULLUP
5mA
350uA
40uA
1mA
I2C Address 0x48 (see datasheet page 14)
I2C Address 0x40 (see datasheet page 13)
This I/O expander is responsible for relaying digital signals accross the HV-LV isolation barrier via the I2C bus.
I2C ISOLATOR
This power supply is responsible for delivering non-isolated 5V power to the high voltage electronics. All AMS bus connected devices are powered from this regulator. Maximum current draw 250mA. This Switcher was selected for its high efficiency even at light load.
Maximum Current Draw on 5V output: 1.2A
Bypass Capacitor (U5)
Bypass Capacitor (U3)
Bypass Capacitor (U4)
I2C Address 0x44 (see datasheet page 18) Additional documentation of the use of this component is req'd.

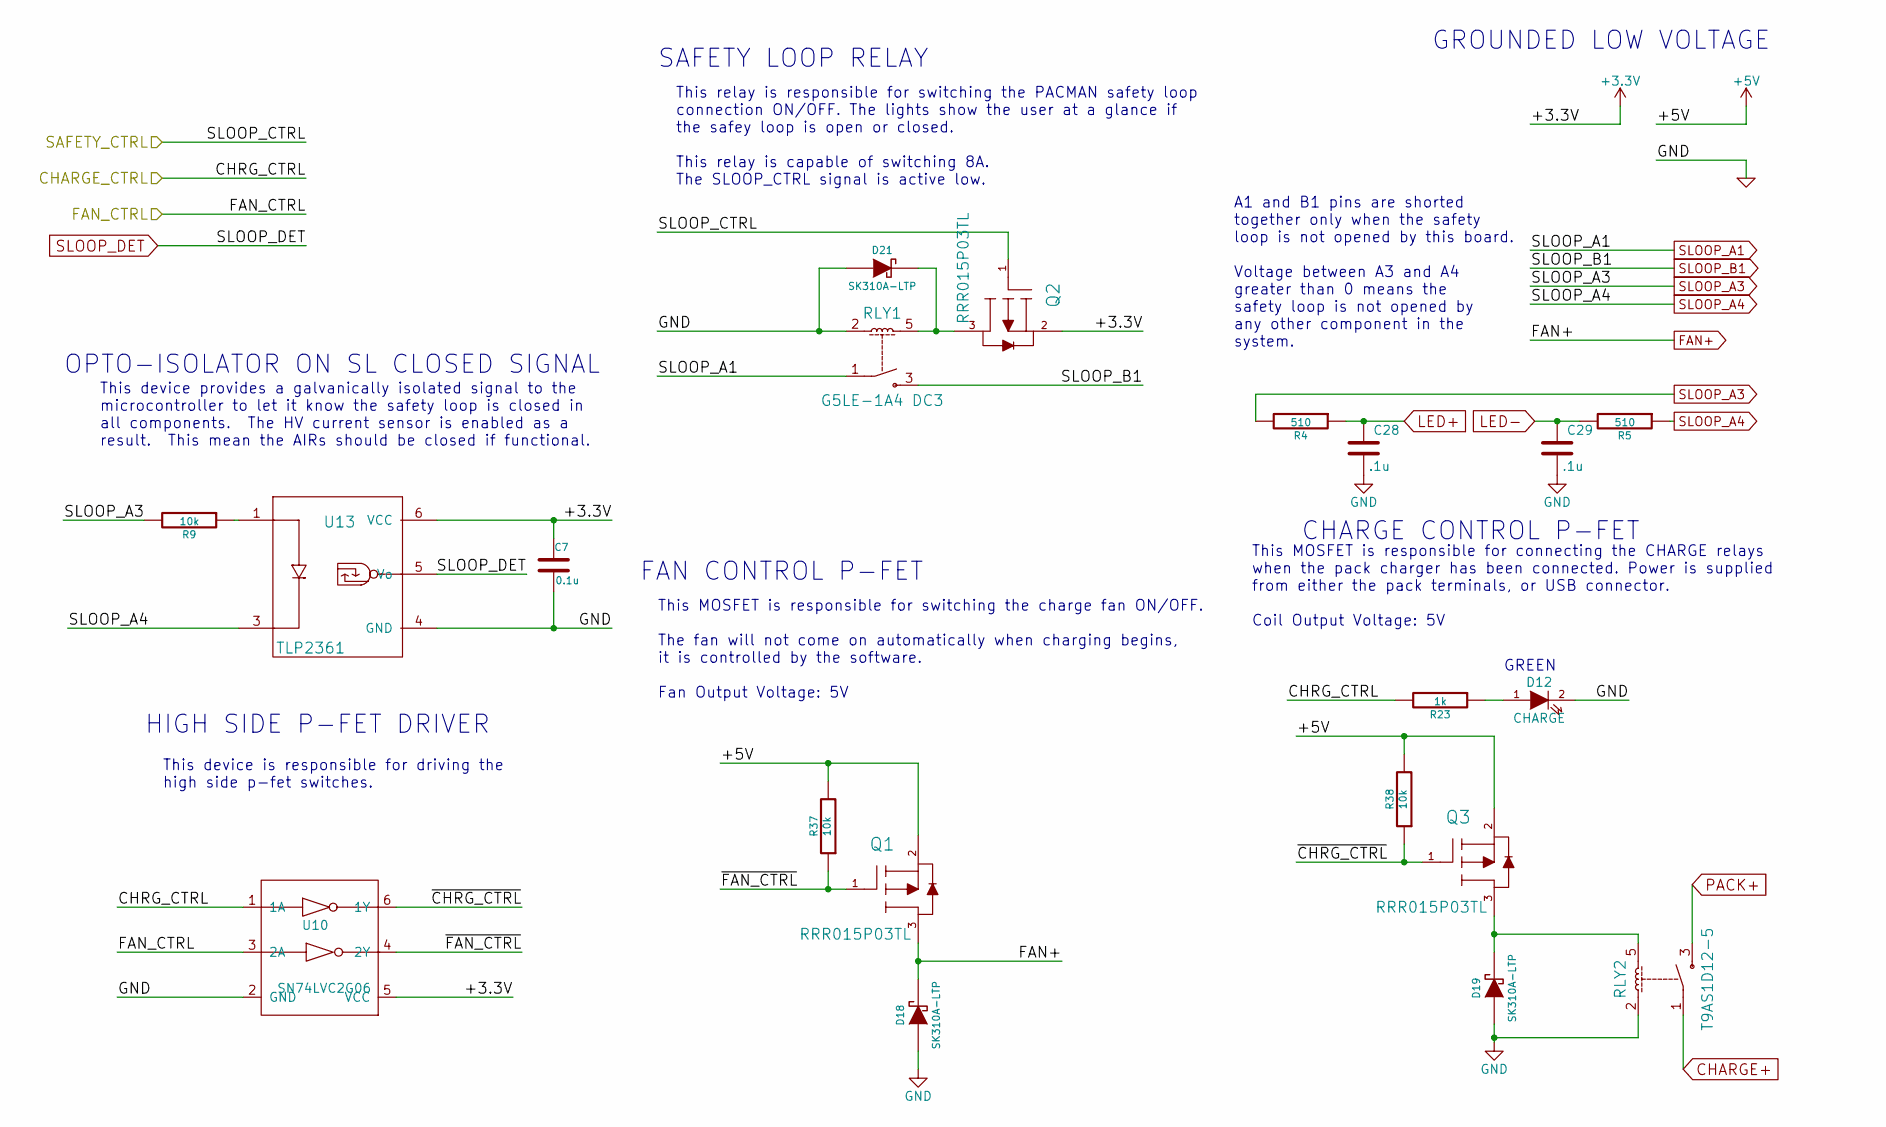
[picture p51: schematic safety_loop.sch, Battery Pack Management Computer]

Parts:
C7: 0.1u; C_0603_HandSoldering
C28, C29: .1u; C_0603_HandSoldering; Manufacturer P/N C0603C104M5RACTU
D12: CHARGE; LED_0603
D18, D19, D21: SK310A-LTP; do214ac; Manufacturer P/N SK310A-LTP
Q1, Q2, Q3: RRR015P03TL; sot346; Manufacturer P/N RRR015P03TL
R4, R5: 510; R_0805_HandSoldering; Manufacturer P/N ESR10EZPJ511
R9, R37, R38: 10k; R_0603_HandSoldering
R23: 1k; R_0603_HandSoldering
RLY1: G5LE-1A4 DC3; relay_G5LE_1A4; Manufacturer P/N G5LE-1A4 DC3
RLY2: T9AS1D12-5; RLY_T9AS1D12-5; Manufacturer P/N T9AS1D12-5
U10: SN74LVC2G06; DCK; Manufacturer P/N SN74LVC2G06DCKR
U13: TLP2361; Manufacturer P/N TLP2361(V4-TPL,E

Connections:
+3V3: C7.1, Q2.2 (D), U10.5 (VCC), U13.6 (VCC); also elsewhere on the board
+5V: Q1.2 (D), Q3.2 (D), R37.2, R38.2; also elsewhere on the board
/Safety Loop Wiring/CHARGE_CTRL: R23.2, U10.1 (1A); also elsewhere on the board
/Safety Loop Wiring/FAN_CTRL: U10.3 (2A); also elsewhere on the board
/Safety Loop Wiring/SAFETY_CTRL: Q2.1 (G); also elsewhere on the board
/Safety Loop Wiring/~CHRG_CTRL: Q3.1 (G), R38.1, U10.6 (1Y)
/Safety Loop Wiring/~FAN_CTRL: Q1.1 (G), R37.1, U10.4 (2Y)
CHARGE+: RLY2.1; also elsewhere on the board
FAN+: D18.2 (K), Q1.3 (S); also elsewhere on the board
GND: C7.2, C28.2, C29.2, D12.2 (K), D18.1 (A), D19.1 (A), D21.1 (A), RLY1.2, RLY2.2, U10.2 (GND), U13.4 (GND); also elsewhere on the board
LED+: C28.1, R4.1; also elsewhere on the board
LED-: C29.1, R5.2; also elsewhere on the board
unnamed: D12.1 (A), R23.1
unnamed: D19.2 (K), Q3.3 (S), RLY2.5
unnamed: D21.2 (K), Q2.3 (S), RLY1.5
unnamed: R9.1, U13.1
PACK+: RLY2.3; also elsewhere on the board
SLOOP_A1: RLY1.1; also elsewhere on the board
SLOOP_A3: R4.2, R9.2; also elsewhere on the board
SLOOP_A4: R5.1, U13.3; also elsewhere on the board
SLOOP_B1: RLY1.3; also elsewhere on the board
SLOOP_DET: U13.5 (Vo); also elsewhere on the board

Notes on the sheet:
CHARGE CONTROL P-FET
SAFETY LOOP RELAY
This relay is responsible for switching the PACMAN safety loop connection ON/OFF. The lights show the user at a glance if the safey loop is open or closed. This relay is capable of switching 8A. The SLOOP_CTRL signal is active low.
This MOSFET is responsible for connecting the CHARGE relays when the pack charger has been connected. Power is supplied from either the pack terminals, or USB connector. Coil Output Voltage: 5V
FAN CONTROL P-FET
This MOSFET is responsible for switching the charge fan ON/OFF. The fan will not come on automatically when charging begins, it is controlled by the software. Fan Output Voltage: 5V
GROUNDED LOW VOLTAGE
GREEN
This device is responsible for driving the high side p-fet switches.
HIGH SIDE P-FET DRIVER
A1 and B1 pins are shorted together only when the safety loop is not opened by this board. Voltage between A3 and A4 greater than 0 means the safety loop is not opened by any other component in the system.
OPTO-ISOLATOR ON SL CLOSED SIGNAL
This device provides a galvanically isolated signal to the microcontroller to let it know the safety loop is closed in all components. The HV current sensor is enabled as a result. This mean the AIRs should be closed if functional.
