austinmam/TSI/pacman_hardware_rev_0_8/project/pacman-main.kicad_pcb

## KiCad design pacman_hardware_rev_0_8/project/pacman-main.kicad_pcb (continued)

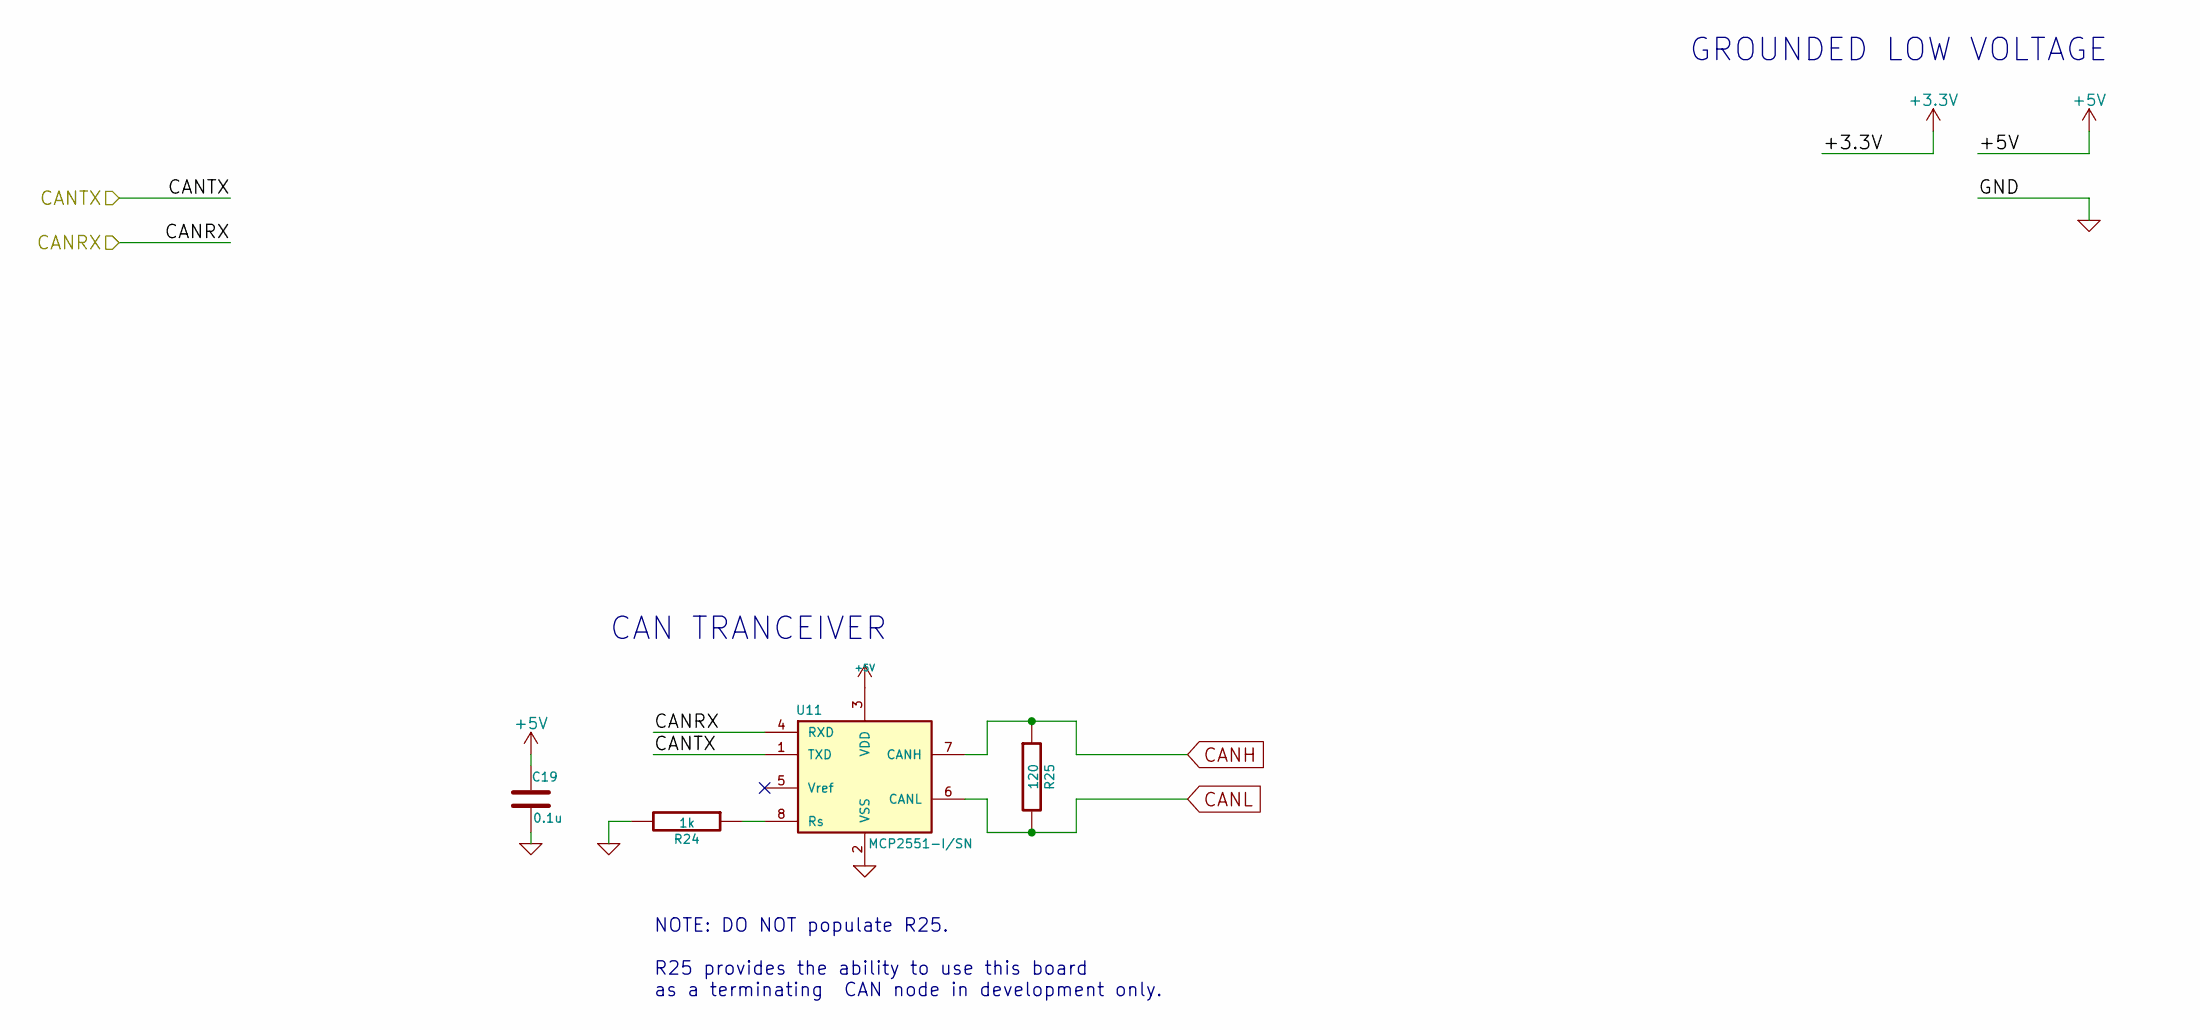
[picture p52: schematic can_xcvr.sch, Battery Pack Management Computer]

Parts:
C19: 0.1u; C_0603_HandSoldering
R24: 1k; R_0603_HandSoldering
R25: 120; R_0805_HandSoldering
U11: MCP2551-I/SN; SOIC-8_3.9x4.9mm_Pitch1.27mm; Manufacturer P/N MCP2551-I/SN

Connections:
+5V: C19.1, U11.3 (VDD); also elsewhere on the board
/CAN Transceiver/CANRX: U11.4 (RXD); also elsewhere on the board
/CAN Transceiver/CANTX: U11.1 (TXD); also elsewhere on the board
CANH: R25.1, U11.7 (CANH); also elsewhere on the board
CANL: R25.2, U11.6 (CANL); also elsewhere on the board
GND: C19.2, R24.2, U11.2 (VSS); also elsewhere on the board
unnamed: R24.1, U11.8 (Rs)

Notes on the sheet:
CAN TRANCEIVER
NOTE: DO NOT populate R25. R25 provides the ability to use this board as a terminating CAN node in development only.
GROUNDED LOW VOLTAGE

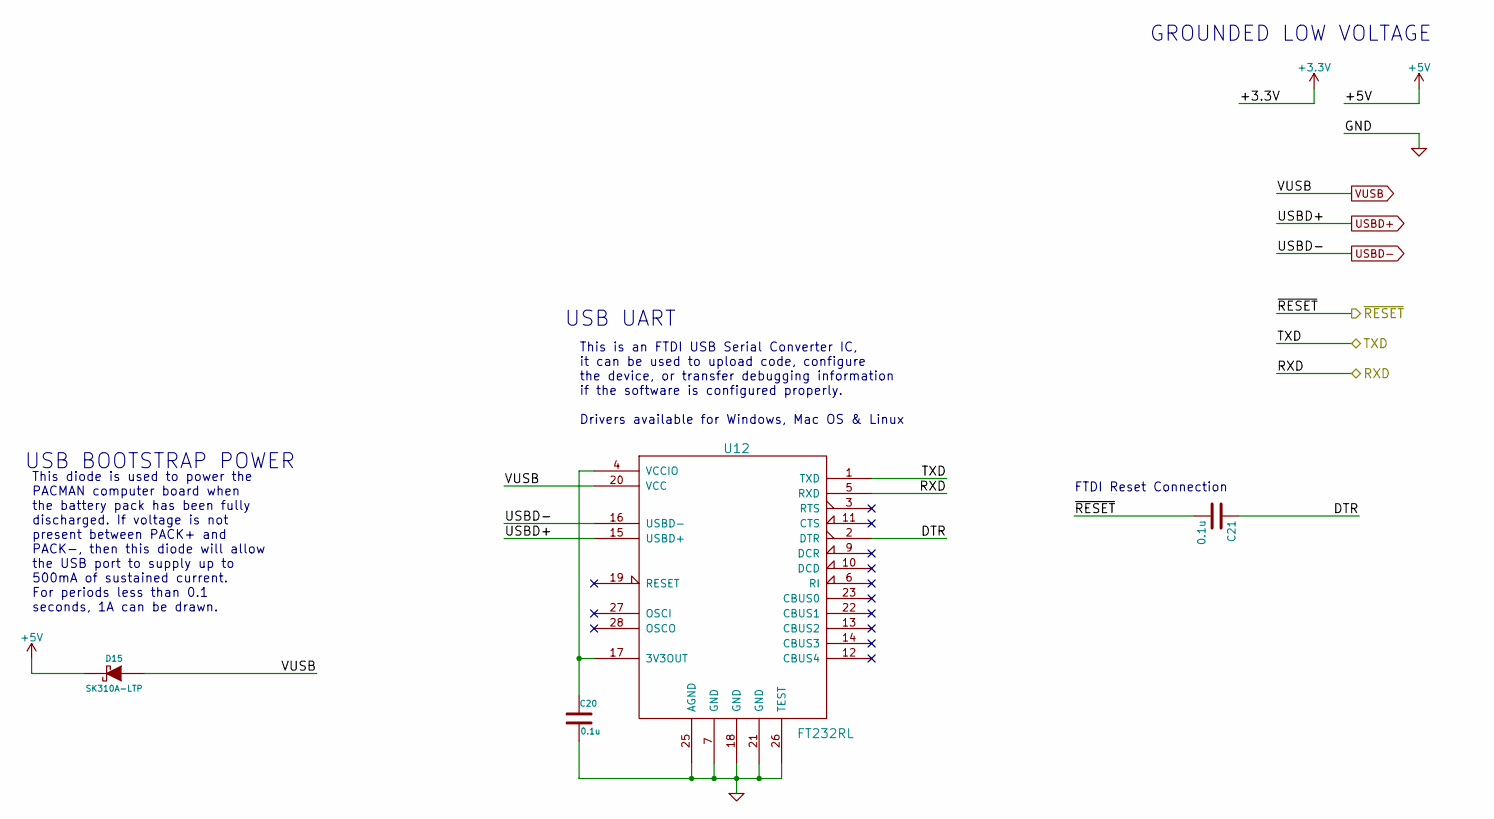
[picture p53: schematic ftdi_uart.sch, Battery Pack Management Computer]

Parts:
C20, C21: 0.1u; C_0603_HandSoldering
D15: SK310A-LTP; do214ac; Manufacturer P/N SK310A-LTP
U12: FT232RL; SSOP-28_5.3x10.2mm_Pitch0.65mm; Manufacturer P/N FT232RL-REEL

Connections:
+5V: D15.2 (K); also elsewhere on the board
/FTDI USB UART/DTR: C21.1, U12.2 (DTR)
/FTDI USB UART/RXD: U12.5 (RXD); also elsewhere on the board
/FTDI USB UART/TXD: U12.1 (TXD); also elsewhere on the board
GND: C20.2, U12.7 (GND), U12.18 (GND), U12.21 (GND), U12.25 (AGND), U12.26 (TEST); also elsewhere on the board
unnamed: C20.1, U12.4 (VCCIO), U12.17 (3V3OUT)
USBD+: U12.15 (USBD+); also elsewhere on the board
USBD-: U12.16 (USBD-); also elsewhere on the board
VUSB: D15.1 (A), U12.20 (VCC); also elsewhere on the board
~RESET_AVR: C21.2; also elsewhere on the board

Notes on the sheet:
FTDI Reset Connection
USB UART
USB BOOTSTRAP POWER
This diode is used to power the PACMAN computer board when the battery pack has been fully discharged. If voltage is not present between PACK+ and PACK-, then this diode will allow the USB port to supply up to 500mA of sustained current. For periods less than 0.1 seconds, 1A can be drawn.
This is an FTDI USB Serial Converter IC, it can be used to upload code, configure the device, or transfer debugging information if the software is configured properly. Drivers available for Windows, Mac OS & Linux
GROUNDED LOW VOLTAGE

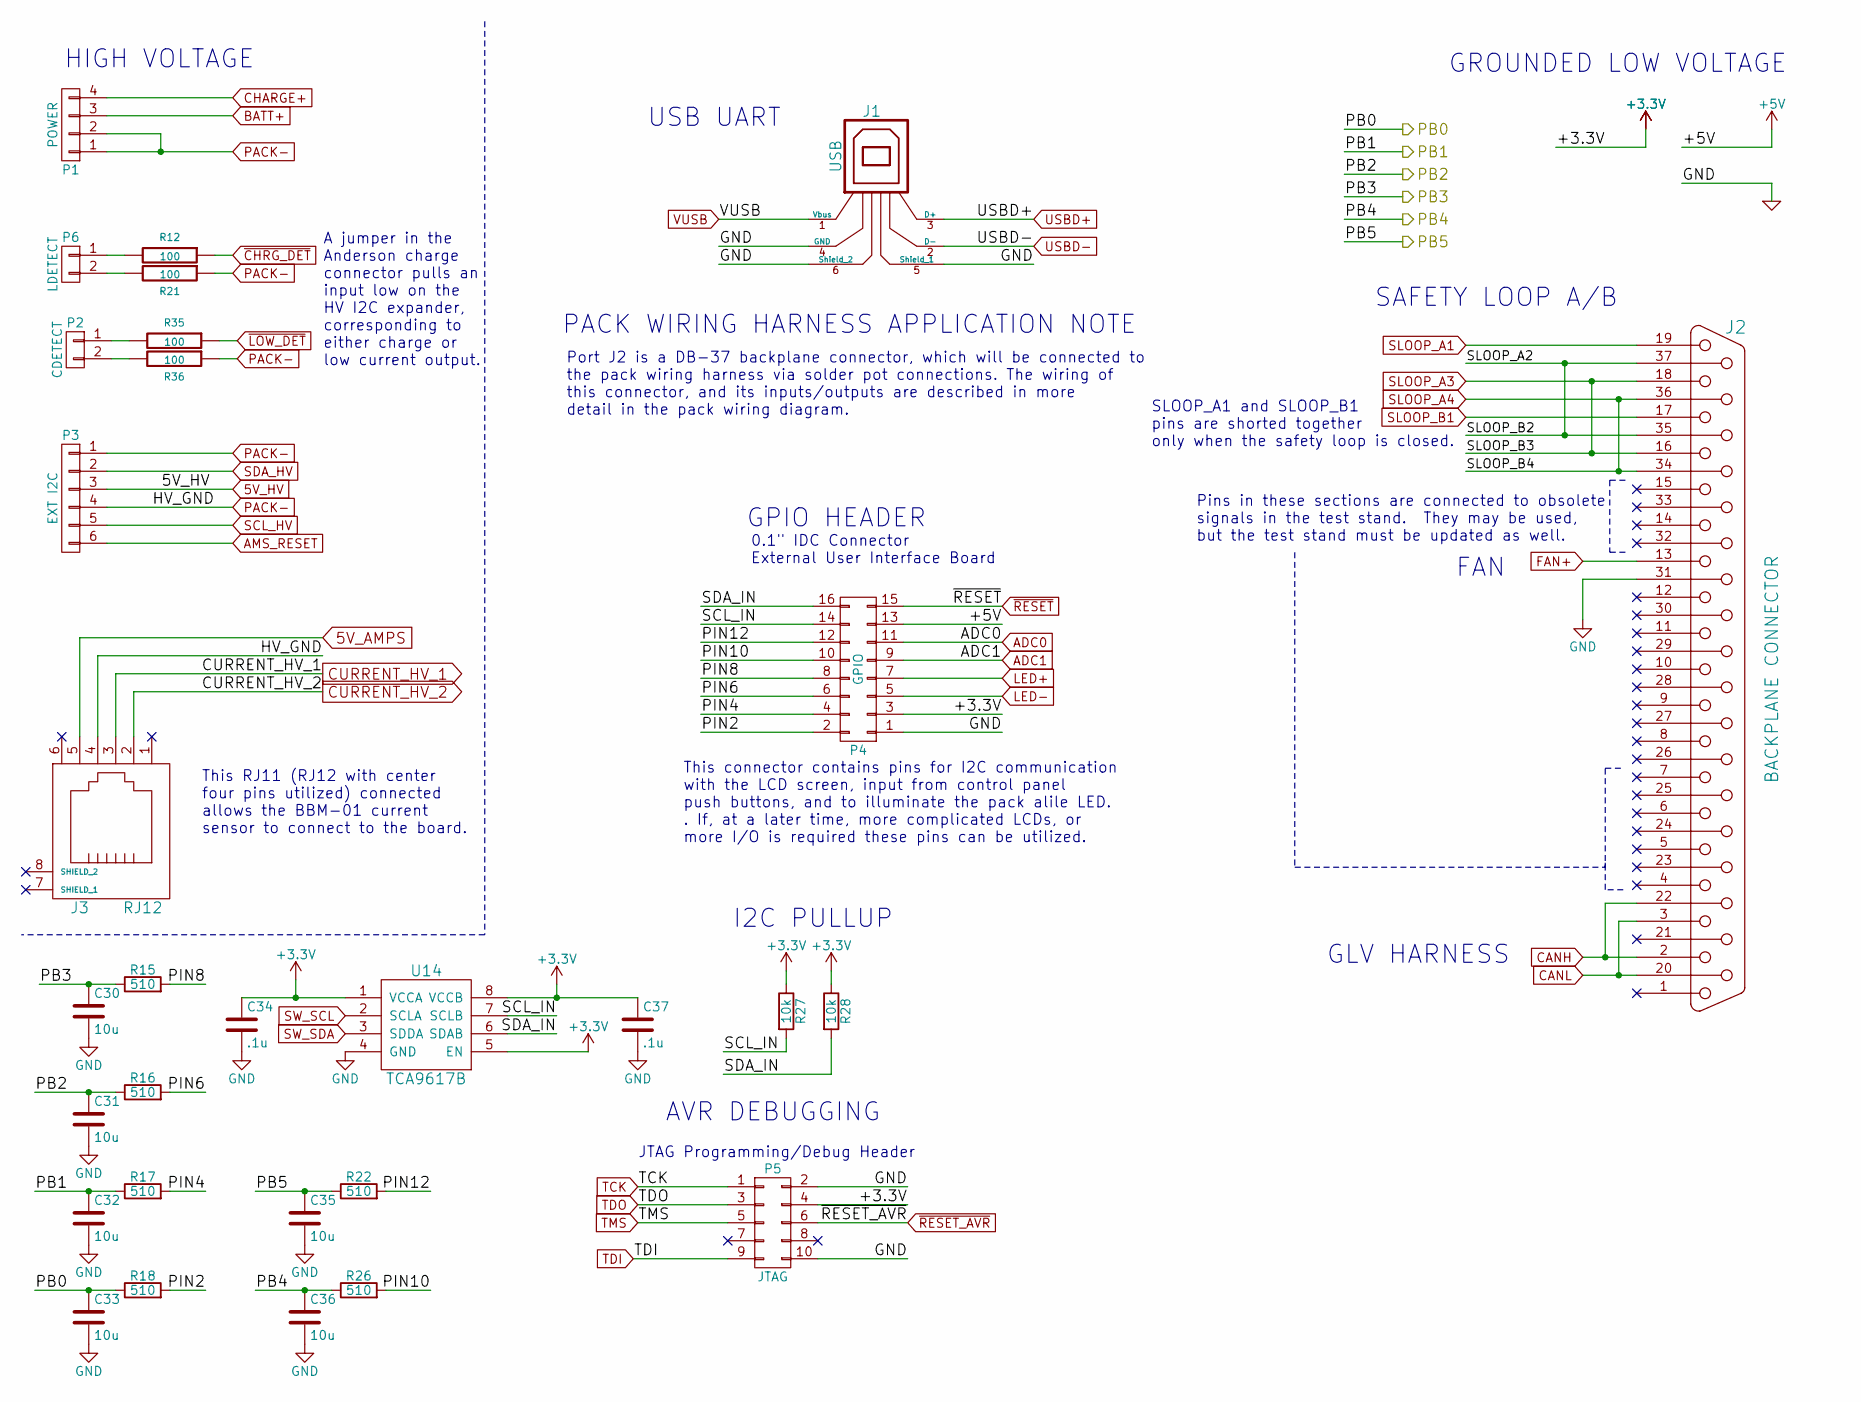
[picture p54: schematic connectors.sch, Battery Pack Management Computer]

Parts:
C30, C31, C32, C33, C35, C36: 10u; C_0805_HandSoldering; Manufacturer P/N CL21A106KQCLRNC
C34, C37: .1u; C_0603_HandSoldering; Manufacturer P/N GRM21BR71E104KA01L
J1: USB; conn_usb_B; Manufacturer P/N 1734346-1
J2: BACKPLANE CONNECTOR; DB37FD; Manufacturer P/N 171-037-213R011
J3: RJ12; MOLEX_RJ11; Manufacturer P/N 0855135002
P1: POWER; AMPCONN_4POS; Manufacturer P/N 556881-4
P2: CDETECT; MOLEX_HEADER_2POS; Manufacturer P/N 15-91-2025
P3: EXT I2C; MOLEX_HEADER_6POS; Manufacturer P/N 15-91-2065
P4: GPIO; IDC_Header_Straight_16pins; Manufacturer P/N 30316-6002HB
P5: JTAG; Manufacturer P/N 20021521-00010T1LF
P6: LDETECT; MOLEX_HEADER_2POS; Manufacturer P/N 15-91-2025
R12, R21, R35, R36: 100; R_0603_HandSoldering
R15, R16, R17, R18, R22, R26: 510; R_0603_HandSoldering; Manufacturer P/N RMCF0805JT510R
R27, R28: 10k; R_0603_HandSoldering
U14: TCA9617B; Manufacturer P/N TCA9617BDGKR

Connections:
5V_AMPS: J3.5; also elsewhere on the board
5V_HV: P3.3; also elsewhere on the board
+3V3: C34.1, C37.1, P4.3, P5.4, R27.1, R28.1, U14.1 (VCCA), U14.5 (EN), U14.8 (VCCB); also elsewhere on the board
+5V: P4.13; also elsewhere on the board
/External Connectors/PB0: C33.1, R18.1; also elsewhere on the board
/External Connectors/PB1: C32.1, R17.1; also elsewhere on the board
/External Connectors/PB2: C31.1, R16.1; also elsewhere on the board
/External Connectors/PB3: C30.1, R15.1; also elsewhere on the board
/External Connectors/PB4: C36.1, R26.1; also elsewhere on the board
/External Connectors/PB5: C35.1, R22.1; also elsewhere on the board
/External Connectors/PIN2: P4.2, R18.2
/External Connectors/PIN4: P4.4, R17.2
/External Connectors/PIN6: P4.6, R16.2
/External Connectors/PIN8: P4.8, R15.2
/External Connectors/PIN10: P4.10, R26.2
/External Connectors/PIN12: P4.12, R22.2
/External Connectors/SCL_IN: P4.14, R27.2, U14.7 (SCLB)
/External Connectors/SDA_IN: P4.16, R28.2, U14.6 (SDAB)
/External Connectors/SLOOP_A2: J2.35, J2.37
ADC0: P4.11; also elsewhere on the board
ADC1: P4.9; also elsewhere on the board
AMS_RESET: P3.6; also elsewhere on the board
BATT+: P1.3; also elsewhere on the board
CANH: J2.2, J2.22; also elsewhere on the board
CANL: J2.3, J2.20; also elsewhere on the board
CHARGE+: P1.4; also elsewhere on the board
CURRENT_HV_1: J3.3; also elsewhere on the board
CURRENT_HV_2: J3.2; also elsewhere on the board
FAN+: J2.13; also elsewhere on the board
GND: C30.2, C31.2, C32.2, C33.2, C34.2, C35.2, C36.2, C37.2, J1.4 (GND), J1.5 (Shield_1), J1.6 (Shield_2), J2.31, P4.1, P5.2, P5.10, U14.4 (GND); also elsewhere on the board
LED+: P4.7; also elsewhere on the board
LED-: P4.5; also elsewhere on the board
unnamed: P2.1, R35.2
unnamed: P2.2, R36.2
unnamed: P6.1, R12.2
unnamed: P6.2, R21.2
PACK-: J3.4, P1.1, P1.2, P3.1, P3.4, R21.1, R36.1; also elsewhere on the board
SCL_HV: P3.5; also elsewhere on the board
SDA_HV: P3.2; also elsewhere on the board
SLOOP_A1: J2.19; also elsewhere on the board
SLOOP_A3: J2.16, J2.18; also elsewhere on the board
SLOOP_A4: J2.34, J2.36; also elsewhere on the board
SLOOP_B1: J2.17; also elsewhere on the board
SW_SCL: U14.2 (SCLA); also elsewhere on the board
SW_SDA: U14.3 (SDDA); also elsewhere on the board
TCK: P5.1; also elsewhere on the board
TDI: P5.9; also elsewhere on the board
TDO: P5.3; also elsewhere on the board
TMS: P5.5; also elsewhere on the board
USBD+: J1.3 (D+); also elsewhere on the board
USBD-: J1.2 (D-); also elsewhere on the board
VUSB: J1.1 (Vbus); also elsewhere on the board
~CHRG_DET: R12.1; also elsewhere on the board
~LOW_DET: R35.1; also elsewhere on the board
~RESET: P4.15; also elsewhere on the board
~RESET_AVR: P5.6; also elsewhere on the board

Notes on the sheet:
HIGH VOLTAGE
USB UART
AVR DEBUGGING
JTAG Programming/Debug Header
0.1" IDC Connector External User Interface Board
GPIO HEADER
This connector contains pins for I2C communication with the LCD screen, input from control panel push buttons, and to illuminate the pack alile LED. . If, at a later time, more complicated LCDs, or more I/O is required these pins can be utilized.
GROUNDED LOW VOLTAGE
FAN
SLOOP_A1 and SLOOP_B1 pins are shorted together only when the safety loop is closed.
GLV HARNESS
SAFETY LOOP A/B
PACK WIRING HARNESS APPLICATION NOTE
Port J2 is a DB-37 backplane connector, which will be connected to the pack wiring harness via solder pot connections. The wiring of this connector, and its inputs/outputs are described in more detail in the pack wiring diagram.
This RJ11 (RJ12 with center four pins utilized) connected allows the BBM-01 current sensor to connect to the board.
A jumper in the Anderson charge connector pulls an input low on the HV I2C expander, corresponding to either charge or low current output.
Pins in these sections are connected to obsolete signals in the test stand. They may be used, but the test stand must be updated as well.
I2C PULLUP

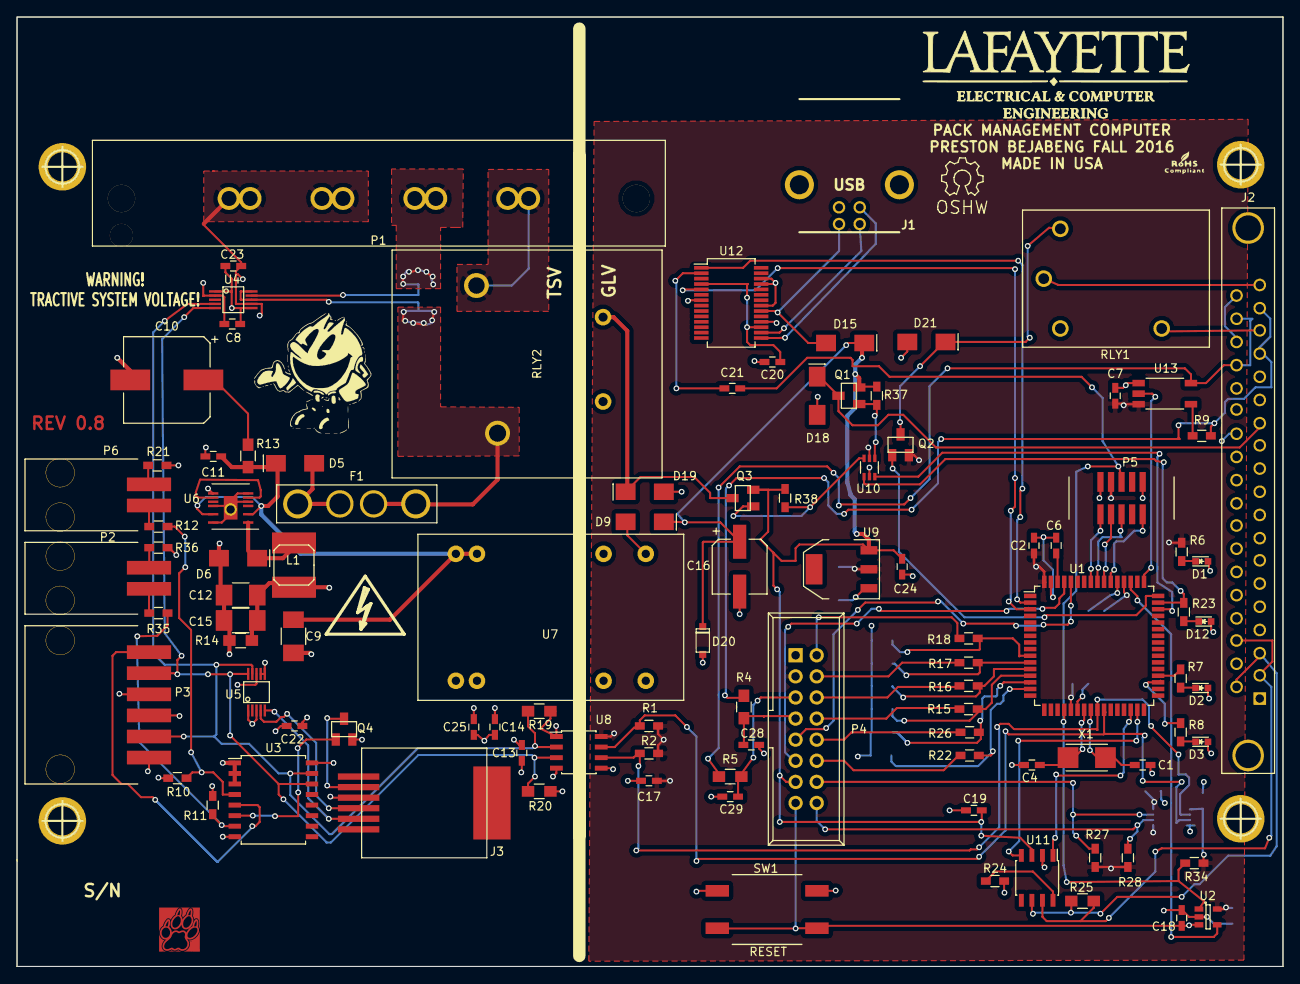
[picture p55: board pacman-main.kicad_pcb from above]

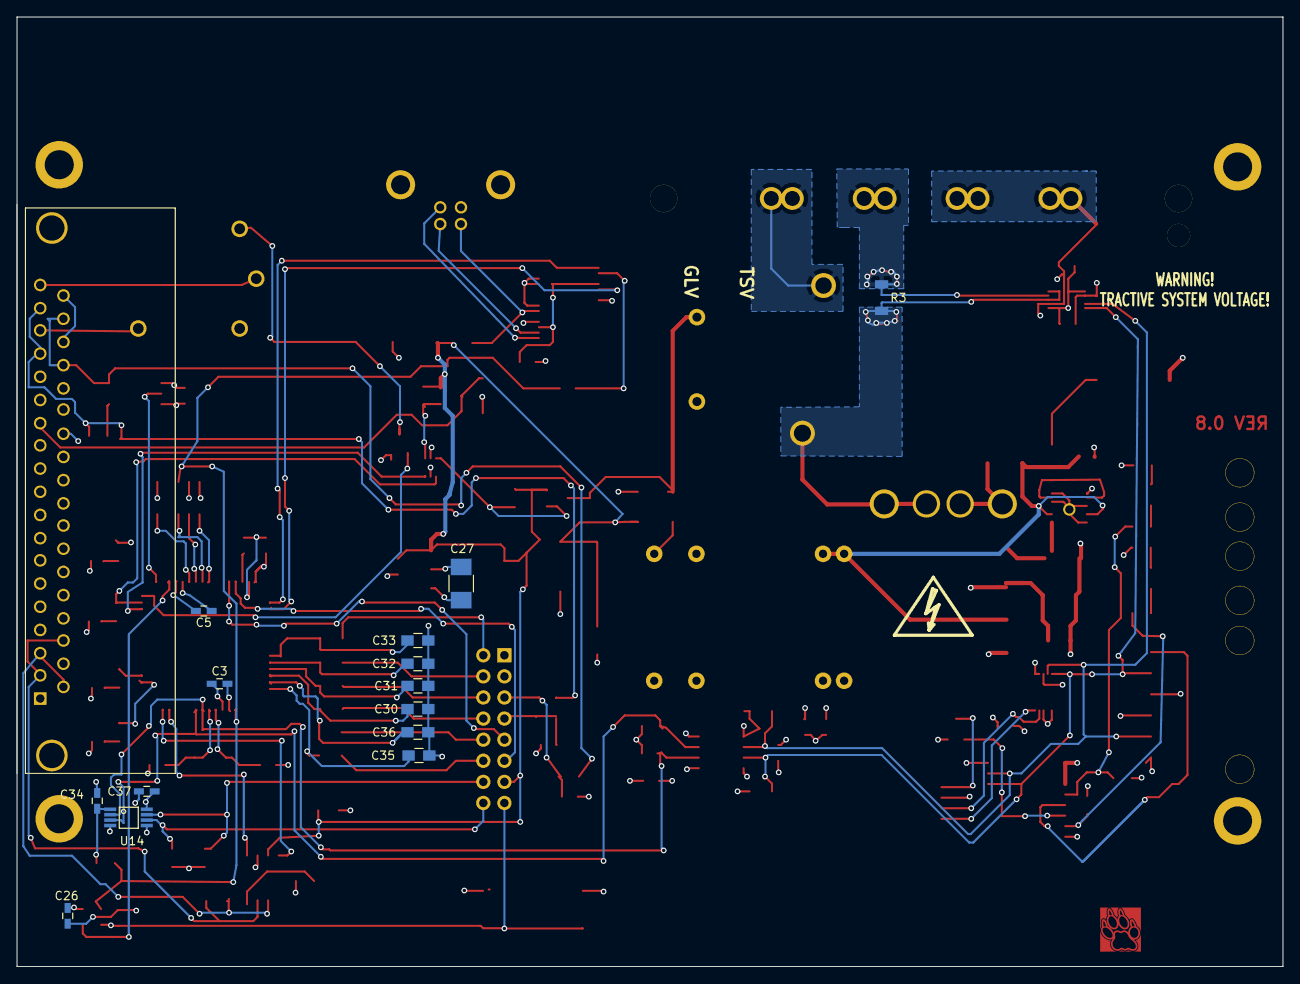
[picture p56: board pacman-main.kicad_pcb from below]

Board: 4 copper layers, 152.4 x 114.3 mm, 120 parts (14 on the bottom side), 90 nets.

Other parts of the board:
VAL: REF; lafLogo
hole_3mm5, hole_3mm5#2, hole_3mm5#3, hole_3mm5#4: VAL**; hole_3mm5
