austinmam/TSI/tsi_sw/tsi/tsi/src/pinout.h

#ifndef PINOUT_H
#define PINOUT_H

#define GPIO_INPUT          0b00
#define GPIO_INPUT_PULLUP   0b01
#define GPIO_OUTPUT_LOW     0b10
#define GPIO_OUTPUT_HIGH    0b11

/**
* @name 
* @{ */
#define HIGH  1
#define LOW   0
/**  @} */

/**
* @brief 
*/
typedef struct {
	void* prt_reg,
	void* ddr_reg,
	void* pin_reg,
	uint8_t pin_num,
} GPIO_PIN;


/**
* @name 
* @{ */
// PORTA gpio pins
//static const GPIO_PIN GPIO_PA0    =  {&PORTA, &DDRA, &PINA, 0};
//static const GPIO_PIN GPIO_PA1    =  {&PORTA, &DDRA, &PINA, 1};
static const GPIO_PIN CC_LED_CTRL =  {&PORTA, &DDRA, &PINA, 2};
static const GPIO_PIN D_LED_CTRL  =  {&PORTA, &DDRA, &PINA, 3};
static const GPIO_PIN RTDS_CTRL   =  {&PORTA, &DDRA, &PINA, 4};
static const GPIO_PIN DRIVE_BTN   =  {&PORTA, &DDRA, &PINA, 5};
//static const GPIO_PIN GPIO_PA6    =  {&PORTA, &DDRA, &PINA, 6};
static const GPIO_PIN I_END       =  {&PORTA, &DDRA, &PINA, 7};

// PORTB gpio pins
static const GPIO_PIN SS_n        =  {&PORTB, &DDRB, &PINB, 0};
static const GPIO_PIN SCK         =  {&PORTB, &DDRB, &PINB, 1};
//static const GPIO_PIN GPIO_PB2    =  {&PORTB, &DDRB, &PINB, 2};
static const GPIO_PIN MISO        =  {&PORTB, &DDRB, &PINB, 3};
static const GPIO_PIN BP_uC       =  {&PORTB, &DDRB, &PINB, 4};
static const GPIO_PIN THRTL_PL    =  {&PORTB, &DDRB, &PINB, 5};
static const GPIO_PIN THRTL_SEL   =  {&PORTB, &DDRB, &PINB, 6};
static const GPIO_PIN THRTL_uC    =  {&PORTB, &DDRB, &PINB, 7};

// PORTC gpio pins
static const GPIO_PIN FAULT       =  {&PORTC, &DDRC, &PINC, 0};
static const GPIO_PIN REQUEST     =  {&PORTC, &DDRC, &PINC, 1};
static const GPIO_PIN LOW_VOLT    =  {&PORTC, &DDRC, &PINC, 2};

// PORTF gpio pins
static const GPIO_PIN GPIO_ADC0   =  {&PORTF, &DDRF, &PINF, 0};
static const GPIO_PIN GPIO_ADC1   =  {&PORTF, &DDRF, &PINF, 1};
static const GPIO_PIN GPIO_ADC2   =  {&PORTF, &DDRF, &PINF, 2};
static const GPIO_PIN GPIO_ADC3   =  {&PORTF, &DDRF, &PINF, 3};
/**  @} */


/**
* @brief 
*
* @param pin
* @param mode
*/
static inline void pinMode(GPIO_PIN pin, uint8_t mode) {
	*(pin.ddr_reg) = 
}


/**
* @brief 
*
* @param pin
* @param value
*/
static inline void pinWrite(GPIO_PIN pin, uint8_t value) {
	pin.
	*PORT = (*PORT & _BV(pin)) | (value << pin);
}


/**
* @brief 
*
* @param pin
*
* @return 
*/
static inline uint8_t pinRead(GPIO_PIN pin) {
	
}


#endif /*PINOUT_H*/
