austinmam/TSI/(commit log)

2017-02-04 adding cad for layout
    [Initial_Layout.dwg]
2017-02-06 adding precharge relay inventor file
    [Precharge_Relay.ipt]
2017-02-09 added throttle plausibility schematic
    [ThrottlePlausibility.kicad_pcb, ThrottlePlausibility.sch]
2017-02-09 started a SPICE help file for circuit sims
2017-02-09 Adding initial circuit, modified state machine
    [Circuit_layout.kicad_pcb, Circuit_layout.sch]
2017-02-13 working on circuit schematic
    [Circuit_layout.sch]
2017-02-13 added SPICE model
    [ThrottlePlausibility.sch]
2017-02-13 started datasheet text file, altered throttle sch
    [ThrottlePlausibility.sch]
2017-02-13 updating schematic
    [Circuit_layout.sch]
2017-02-14 adding to schematic, adding tims stuff
    [Circuit_layout.sch, TSI_HV_Isolater.csv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]
2017-02-14 added throttle plausibility to circuit_layout
    [Circuit_layout.sch, ThrottlePlausibility.sch]
2017-02-14 added throttle plausibility circuit to circuit layout project
    [Circuit_layout.sch, ThrottlePlausibility.sch]
2017-02-14 oved plaus up to main circuit layout lvl
    [Circuit_layout.sch, ThrottlePlausibility.sch]
2017-02-15 added isolator for APPS1, still need to figure out diffamp/AND gate pwr rails
    [Circuit_layout.sch, ThrottlePlausibility.sch]
2017-02-16 moved throttle back down to sub-sch
    [Circuit_layout.sch, ThrottlePlausibility.sch]
2017-02-16 added kicad lib to pro
    [Circuit_layout.sch, ThrottlePlausibility.sch]
2017-02-16 pushing ki-cad lib up
    [1593K_Enclosure.kicad_pcb, 1593K_Enclosure.sch, Arduino_As_Uno.kicad_pcb, Arduino_As_Uno.sch, Arduino_Fio.kicad_pcb, Arduino_Fio.sch, Arduino_Mega.kicad_pcb, Arduino_Mega.sch]
2017-02-16 adding pacman code
    [Can_tcvr.sch, Circuit_layout.sch, ThrottlePlausibility.sch, bom.csv, can_xcvr.sch, connectors.sch, ftdi_uart.sch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]
2017-02-16 added more SPICE models and sims
    [ThrottlePlausibility.sch]
2017-02-17 working on schematic
    [Can_tcvr.sch, Circuit_layout.sch, ThrottlePlausibility.sch]
2017-02-18 Cleaned up Throttle Sch. still need to add connectors/verify voltage regulator will provide enough current, etc.
    [Can_tcvr.sch, Circuit_layout.sch, ThrottlePlausibility.sch]
2017-02-20 added analog switch, as well as datasheets to current pieces. changed to 8-input nand controlling n-mos
    [Can_tcvr.sch, Circuit_layout.sch, Ext_Connectors.sch, ThrottlePlausibility.sch]
2017-02-21 tried to organize a little. Added datasheets for brakes
2017-02-22 added to throttle. added brake outputs
    [Can_tcvr.sch, Circuit_layout.sch, Ext_Connectors.sch, ThrottlePlausibility.sch]
2017-02-22 modified schematic
2017-02-22 minor changes in throttle. added LPF for brake inputs
    [ThrottlePlausibility.sch]
2017-02-22 adding dc dc converters
    [Can_tcvr.sch, Circuit_layout.sch, Ext_Connectors.sch, PowerSystem.sch, StatusLights.sch]
2017-02-23 added filter for PWM output of uC
    [Can_tcvr.sch, Circuit_layout.sch, Ext_Connectors.sch, ThrottlePlausibility.sch]
2017-02-23 added isolation for apps
    [ThrottlePlausibility.sch]
2017-02-23 Working on power systems
    [Can_tcvr.sch, Circuit_layout.sch, Ext_Connectors.sch, PowerSystem.sch, StatusLights.sch]
2017-02-23 adding sub schematic
    [Can_tcvr.sch, Circuit_layout.sch, Ext_Connectors.sch, PowerSystem.sch, StatusLights.sch, ThrottlePlausibility.sch, isolators.sch]
2017-02-23 adding pinouts to uController
    [Circuit_layout.sch, Ext_Connectors.sch, StatusLights.sch]
2017-02-24 added isolators, as well as voltage meas circuit used by tim
    [Can_tcvr.sch, Circuit_layout.sch, Ext_Connectors.sch, PowerSystem.sch, StatusLights.sch, ThrottlePlausibility.sch, isolators.sch]
2017-02-24 added iso circuits, curr. sensor diff amp, IMD fault lt circuit, updated labels
    [Can_tcvr.sch, Circuit_layout.sch, Ext_Connectors.sch, PowerSystem.sch, StatusLights.sch, ThrottlePlausibility.sch, isolators.sch]
2017-02-25 added some fets
    [Can_tcvr.sch, Circuit_layout.sch, Ext_Connectors.sch, PowerSystem.sch, StatusLights.sch, ThrottlePlausibility.sch, isolators.sch]
2017-02-25 changes to sch. added p-ch for use as switch
    [Can_tcvr.sch, Circuit_layout.sch, Ext_Connectors.sch, PowerSystem.sch, StatusLights.sch, ThrottlePlausibility.sch, isolators.sch]
2017-02-25 standardized some names
    [Circuit_layout.sch, ThrottlePlausibility.sch]
2017-02-25 added debug LEDs and AIRs connections
    [Can_tcvr.sch, Circuit_layout.sch, Ext_Connectors.sch, PowerSystem.sch, StatusLights.sch, ThrottlePlausibility.sch, isolators.sch]
2017-02-26 filling out field info. for all added devices. think im done w/ resistors.
    [Can_tcvr.sch, Circuit_layout.sch, Ext_Connectors.sch, PowerSystem.sch, StatusLights.sch, ThrottlePlausibility.sch, isolators.sch]
2017-02-26 added footprints/data to all active comp. of throttle. need to finish caps, then copy to rest of sch
    [ThrottlePlausibility.sch]
2017-02-26 added cap. info. for orders
    [Can_tcvr.sch, Circuit_layout.sch, Ext_Connectors.sch, PowerSystem.sch, StatusLights.sch, ThrottlePlausibility.sch, isolators.sch]
2017-02-26 KiCad BOM
    [Can_tcvr.sch, Circuit_layout.csv, Circuit_layout.sch, Ext_Connectors.sch, PowerSystem.sch, StatusLights.sch, ThrottlePlausibility.sch, isolators.sch]
2017-02-26 finished adding footprints/info to all parts that I can
    [Can_tcvr.sch, Circuit_layout.sch, Ext_Connectors.sch, PowerSystem.sch, StatusLights.sch, ThrottlePlausibility.sch, isolators.sch]
2017-02-27 added TSMP
    [Can_tcvr.sch, Circuit_layout.sch, Ext_Connectors.sch, PowerSystem.sch, StatusLights.sch, ThrottlePlausibility.sch, isolators.sch]
2017-02-27 took notes w/ greg
    [Can_tcvr.sch, Circuit_layout.sch, Ext_Connectors.sch, PowerSystem.sch, StatusLights.sch, ThrottlePlausibility.sch, isolators.sch]
2017-03-01 got rid of some warnings with nets.
    [Circuit_layout.sch, Ext_Connectors.sch, PowerSystem.sch, StatusLights.sch, ThrottlePlausibility.sch, isolators.sch]
2017-03-01 eliminated warnings, need to clean things up + add footprints/datasheets
    [Circuit_layout.sch, Ext_Connectors.sch, PowerSystem.sch, StatusLights.sch, ThrottlePlausibility.sch, isolators.sch]
2017-03-02 Working on neatining up schematic and working on top level diagram
    [Can_tcvr.sch, Circuit_layout.sch, Ext_Connectors.sch, PowerSystem.sch, StatusLights.sch, ThrottlePlausibility.sch, isolators.sch]
2017-03-02 cleaned up sch, added bypass pass. no net warnings
    [Can_tcvr.sch, Circuit_layout.sch, Ext_Connectors.sch, PowerSystem.sch, StatusLights.sch, ThrottlePlausibility.sch, isolators.sch]
2017-03-02 took notes on nadovich's proposed changes
    [Ext_Connectors.sch, PowerSystem.sch, StatusLights.sch, ThrottlePlausibility.sch]
2017-03-03 fixed the throttle.
    [Can_tcvr.sch, Circuit_layout.sch, Ext_Connectors.sch, PowerSystem.sch, StatusLights.sch, ThrottlePlausibility.sch, isolators.sch]
2017-03-03 added footprints
    [Can_tcvr.sch, Circuit_layout.sch, Ext_Connectors.sch, PowerSystem.sch, StatusLights.sch, ThrottlePlausibility.sch, isolators.sch]
2017-03-03 adding footprints
    [Can_tcvr.sch, Circuit_layout.sch, Ext_Connectors.sch, PowerSystem.sch, StatusLights.sch, ThrottlePlausibility.sch, isolators.sch]
2017-03-03 changing hvpl
    [Can_tcvr.sch, Circuit_layout.sch, Ext_Connectors.sch, PowerSystem.sch, StatusLights.sch, ThrottlePlausibility.sch, isolators.sch]
2017-03-04 working on circuit fixes after sch review
    [Can_tcvr.sch, Circuit_layout.sch, Ext_Connectors.sch, PowerSystem.sch, StatusLights.sch, ThrottlePlausibility.sch, isolators.sch]
2017-03-04 made changes after init. review. Still need to add ports out of board.
    [Can_tcvr.sch, Circuit_layout.sch, Ext_Connectors.sch, PowerSystem.sch, StatusLights.sch, ThrottlePlausibility.sch, isolators.sch]
2017-03-05 updating HVPL schematic
    [Can_tcvr.sch, Circuit_layout.sch, Ext_Connectors.sch, PowerSystem.sch, StatusLights.sch, ThrottlePlausibility.sch, isolators.sch]
2017-03-06 Started PCB. Small changes to schematic. Adding system states visio file
    [Can_tcvr.sch, Circuit_layout.kicad_pcb, Circuit_layout.sch, Ext_Connectors.sch, PowerSystem.sch, StatusLights.sch, ThrottlePlausibility.sch, isolators.sch]
2017-03-06 added watchdog to schematic, added avr datasheet
    [Can_tcvr.sch, Circuit_layout.sch, Ext_Connectors.sch, PowerSystem.sch, StatusLights.sch, ThrottlePlausibility.sch, isolators.sch]
2017-03-07 added LDO volt. reg
2017-03-07 added all info for LDO, except footprint. need to add step-down for brake overtravel
    [Circuit_layout.sch, Ext_Connectors.sch, ThrottlePlausibility.sch]
2017-03-07 added optoiso for brake overtravel
    [Ext_Connectors.sch, StatusLights.sch, ThrottlePlausibility.sch, isolators.sch]
2017-03-07 need to make further changes after review w/ prof
    [Circuit_layout.sch, ThrottlePlausibility.sch]
2017-03-08 modifiying hvpl
    [Can_tcvr.sch, Circuit_layout.sch, Ext_Connectors.sch, PowerSystem.sch, StatusLights.sch, ThrottlePlausibility.sch, isolators.sch]
2017-03-08 changes before presentation
    [Can_tcvr.sch, Circuit_layout.sch, Ext_Connectors.sch, PowerSystem.sch, StatusLights.sch, ThrottlePlausibility.sch, isolators.sch]
2017-03-08 pics of schematic
    [Can_tcvr.sch, Circuit_layout.sch, Ext_Connectors.sch, PowerSystem.sch, StatusLights.sch, ThrottlePlausibility.sch, isolators.sch]
2017-03-09 added test pts
    [Can_tcvr.sch, Circuit_layout.sch, Ext_Connectors.sch, PowerSystem.sch, StatusLights.sch, ThrottlePlausibility.sch, isolators.sch]
2017-03-20 fixed switch, added pulldown resistor, added DPDT switch for extra ADCs
    [Can_tcvr.sch, Circuit_layout.sch, Ext_Connectors.sch, PowerSystem.sch, StatusLights.sch, ThrottlePlausibility.sch, isolators.sch]
2017-03-20 fixing nets. most done except for GND/driving issue
    [Can_tcvr.sch, Circuit_layout.sch, Ext_Connectors.sch, PowerSystem.sch, StatusLights.sch, ThrottlePlausibility.sch, isolators.sch]
2017-03-21 current sensor enable
    [Can_tcvr.sch, Circuit_layout.sch, Ext_Connectors.sch, PowerSystem.sch, StatusLights.sch, ThrottlePlausibility.sch, isolators.sch]
2017-03-22 modifying hvpl
    [Can_tcvr.sch, Circuit_layout.sch, Ext_Connectors.sch, PowerSystem.sch, StatusLights.sch, ThrottlePlausibility.sch, isolators.sch]
2017-03-22 added footprint to DPDT switch, test points, DRC passes
    [Can_tcvr.sch, Circuit_layout.sch, Ext_Connectors.sch, PowerSystem.sch, StatusLights.sch, ThrottlePlausibility.sch, isolators.sch]
2017-03-22 cleaned up footprints of more testpoints. ran DRC again, passed
    [Can_tcvr.sch, Circuit_layout.sch, Ext_Connectors.sch, PowerSystem.sch, StatusLights.sch, ThrottlePlausibility.sch, isolators.sch]
2017-03-23 started working on throttle layout in pcb. added ch_gnd plane
    [Can_tcvr.sch, Circuit_layout.kicad_pcb, ThrottlePlausibility.sch, isolators.sch]
2017-03-24 reviewed schematic w/ prof. nadovich. proposed changes
    [Circuit_layout.kicad_pcb, Circuit_layout.sch, StatusLights.sch, ThrottlePlausibility.sch, isolators.sch]
2017-03-24 small changes
    [Can_tcvr.sch, Circuit_layout.kicad_pcb, Circuit_layout.sch, Ext_Connectors.sch, PowerSystem.sch, StatusLights.sch, ThrottlePlausibility.sch, isolators.sch]
2017-03-24 changed connectors
    [Ext_Connectors.sch]
2017-03-24 continued work on layout of pcb
    [Circuit_layout.kicad_pcb]
2017-03-25 made changes discussed in sch review w/ prof. added back +5 plane
    [Can_tcvr.sch, Circuit_layout.kicad_pcb, Circuit_layout.sch, Ext_Connectors.sch, PowerSystem.sch, StatusLights.sch, ThrottlePlausibility.sch, _saved_Ext_Connectors.sch]
2017-03-25 slight changes
    [Ext_Connectors.sch, ThrottlePlausibility.sch, _saved_Ext_Connectors.sch, _saved_StatusLights.sch]
2017-03-25 organized sheet more, updated some footprints
    [Can_tcvr.sch, Circuit_layout.kicad_pcb, Circuit_layout.sch, Ext_Connectors.sch, PowerSystem.sch, StatusLights.sch, ThrottlePlausibility.sch, isolators.sch]
2017-03-25 added more tracks
    [Can_tcvr.sch, Circuit_layout.kicad_pcb, Circuit_layout.sch, Ext_Connectors.sch, PowerSystem.sch, StatusLights.sch, ThrottlePlausibility.sch, isolators.sch]
2017-03-25 working on pcb
    [Circuit_layout.kicad_pcb, Circuit_layout.sch, StatusLights.sch]
2017-03-26 small changes to pcb
    [Circuit_layout.kicad_pcb]
2017-03-27 finishing rev 0 of pcb
    [Circuit_layout.kicad_pcb, StatusLights.sch, ThrottlePlausibility.sch]
2017-03-27 adding silkscreen
    [Circuit_layout.kicad_pcb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]
2017-03-27 review pcb, made notes
    [Circuit_layout.kicad_pcb, Circuit_layout.sch, Ext_Connectors.sch, ThrottlePlausibility.sch]
2017-03-27 fixed changes proposed by prof. nadovich.
    [Can_tcvr.sch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]
2017-03-28 final changes to pcb. working on BOM
    [Circuit_layout.csv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]
2017-03-28 updated BOM docs
    [Circuit_layout.csv, Circuit_layout.xlsx, TSI_BOM.xlsx]
2017-03-29 took note of unavailable LM7810CT, switched to LM7810ACT
    [TSI_BOM.xlsx]
2017-03-29 working on box schematic
2017-03-29 purchase request
    [Mouser_PurchaceRequest.xls]
2017-03-31 inventor file for rack plate
    [Faceplate.0001.ipt, Faceplate.ipt, Mouser_PurchaceRequest.xls, Slide_Pot.0001.ipt, Slide_Pot.ipt]
2017-03-31 working on inventor
    [Faceplate.0001.ipt, Faceplate.0002.ipt, Faceplate.ipt, Mouser_PurchaceRequest.xls]
2017-04-03 making dfx
    [Faceplate.0007.ipt, Faceplate.0008.ipt, Faceplate.ipt, Faceplate_drawing.0007.idw, Faceplate_drawing.0008.idw, Faceplate_drawing.idw, TSI_Rack_Plate.dxf]
2017-04-05 made some edits to pinouts for tsi board
2017-04-05 purchase req
    [92095A452_18-8 SS BUTTON-HEAD SOCKET CAP SCREW.STEP, 92095A452_18-8 SS BUTTON-HEAD SOCKET CAP SCREW.ipt, Assembly1.0001.iam, Assembly1.0002.iam, Assembly1.iam, McMaster_PurchaceRequest.xls, Mouser_PurchaceRequest.xls]
2017-04-06 altered pacman code for heartbeat on tsib. started errors file
    [main.c, params.h, pinout.h, task_button.c, task_button.h, task_can.c, task_can.h, task_heartbeat.c]
2017-04-07 tested throttle plaus, working through isolation. gain needs fixed. added rest of the LEDS
    [main.c, params.h, pinout.h, task_button.c, task_button.h, task_can.c, task_can.h, task_heartbeat.c]
2017-04-08 able to now read/act on brake pressed/brake overtravel signals w/ uC
2017-04-08 confirmed functionality of brake
2017-04-10 altered pacman software so applicable to tsib
    [_saved_Circuit_layout.sch]
2017-04-11 cleaning up tsib code. attempted to prepare for i2c output of adc'd throttle
2017-04-12 trying to get the i2c up and working
2017-04-13 attempting to add task_state
    [_saved_Circuit_layout.sch]
2017-04-13 added box inventor file. Added pinouts
    [1 inch screw.ipt, 15x11Plate.0003.dwg, 15x11Plate.0010.idw, 15x11Plate.0055.ipt, 15x11Plate.dwg, 15x11Plate.idw, 15x11Plate.ipt, 18x12x6Box.0065.ipt]
2017-04-13 working on top level schematic
    [Circuit_layout.sch]
2017-04-17 got bp/throttle plausibility working better
2017-04-18 now able to read button
2017-04-19 Drive button latching properly
2017-04-19 Have Throttle Select responding to Brake input
2017-04-20 Working on getting adc up
2017-04-20 small change to pinout
    [Pinout.xlsx]
2017-04-21 tried different adc protocol, no luck
2017-04-24 updating pinout
    [Pinout.xlsx]
2017-04-25 Made heartbeat work again, added Drive LED
2017-04-26 Added AIRs + BOT to Drive State Fallout
    [_saved_Circuit_layout.sch]
2017-04-26 Removed BOT from Drive state kickout, due to AIRs already being read for this purpose
    [_saved_Circuit_layout.sch]
2017-04-26 Inverted the AIRs input
    [task_safety.c]
2017-04-27 Added notes for board errata:
2017-05-03 Added comments to schematic to aid future years in understanding what went wrong and where
    [Can_tcvr.sch, Circuit_layout.sch, Ext_Connectors.sch, PowerSystem.sch, StatusLights.sch, ThrottlePlausibility.sch, isolators.sch]
2017-05-04 wire diagram
2017-05-05 Worked on the Maintenance Manual. Updated some stuff of the schematic/errata
    [Can_tcvr.sch, Circuit_layout.sch, Ext_Connectors.sch, PowerSystem.sch, StatusLights.sch, ThrottlePlausibility.sch, isolators.sch]
2017-05-05 cleaning up git
    [Initial_Layout.dwg, McMaster_PurchaceRequest.xls, Mouser_PurchaceRequest.xls, Precharge_Relay.ipt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]
2017-05-05 Inventor Files
    [1 inch screw.ipt, 15x11Plate.0003.dwg, 15x11Plate.0010.idw, 15x11Plate.0055.ipt, 15x11Plate.dwg, 15x11Plate.idw, 15x11Plate.ipt, 18x12x6Box.0065.ipt]
2018-02-16 added new parameters for temp, throttle, and CAN
2018-02-16 fixed typo in code
    [task_temp.c]
2018-02-20 fixed temp sensing, updated can addresses
    [params.h, task_can.c, task_temp.c, task_temp.h]
2018-02-27 Add files via upload
    voltage and IMD sensing operational
2018-02-27 Add files via upload
    Finished current sensing
2018-02-27 Deleted unnecessary files. Cleaned up repo.
    [1 inch screw.ipt, 1593K_Enclosure.kicad_pcb, 1593K_Enclosure.sch, 15x11Plate.0003.dwg, 15x11Plate.0010.idw, 15x11Plate.0055.ipt, 15x11Plate.dwg, 15x11Plate.idw]
2018-02-27 Cleaned up files.
    [bom.csv, can_xcvr.sch, connectors.sch, ftdi_uart.sch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]
2018-03-07 added in throttle control condition to drive states
2018-03-08 Changed throttle_control back to 0 after dropping out of drive.
2018-03-09 Need to brake and press drive button to drop out of drive now.
2018-03-13 throttle_sel is high now so Peter can test. This is temporary.
2018-03-18 Fixed typos leading to make errors
    [task_overcurrent.c]
2018-03-20 fixed throttle select problem on start up
    [task_safety.c]
2018-03-21 throttle voltage > 0.5V DRIVE
2018-03-21 OVERCURRENT not controlled by button
2018-03-23 Added throttle plausibility to can communication
2018-03-23 ADC Conversions
2018-03-24 Fixed the overcurrent state problem
    [task_overcurrent.c, task_readApps.c, task_safety.c]
2018-03-26 temperature is in celsius now
2018-03-26 Fixed integer division problems
    [task_readApps.c, task_readVoltage.c]
2018-03-26 conversion messed with reading of throttle for drive state
2018-03-26 fixed conversion error interfering with drive state
    [task_readApps.c]
2018-03-27 ADC fixes
2018-04-04 Brake and Safety over CAN
2018-04-04 voltage conversion
2018-04-14 edited throttle plausibility signals
2018-04-14 Changed throttlePlaus variable to correctly reflect implausibility
    [task_safety.c]
2018-04-15 Removed an error that put us in setup_drive when button was just pushed.
    [task_safety.c]
2018-04-15 Added buttonpush init to 0 in safety_init method
2018-04-15 Added something to make buttonPushed 0
2018-04-15 Added additional logic to prevent going into drive mode when scada drop signal is 1.
    [task_safety.c]
2018-04-21 Changed the button to active low
2018-04-21 testing for button with LED on board
2018-04-21 Changed led logic
2018-04-21 Changed LED logic for button press
2018-04-21 LED logic
2018-04-21 Active low button
2018-04-21 Took out everything except brake and button
2018-04-21 added in throttle plaus
2018-04-21 added in throttle stuff
2018-04-21 LED for drop out signal
2018-04-21 took out throttle drop out
2018-04-21 Added LEDs for throttle reading
2018-04-21 Took out led in button logic
2018-04-21 edited throttle
2018-04-21 Changed button push to send on CAN
2018-04-21 Button push
2018-04-21 Changed button to uint8_t
2018-04-21 Changed buttonCan to be sent over CAN, reset after sending and set to 1 in pushed state
    [task_button.c, task_button.h, task_can.c]
2018-04-24 Fixed ADC readings
2018-04-24 Changed throttle on threshold
2018-04-24 Changed throttle threshold to drop out in case brake and throttle pressed
2018-04-24 Throttle_out signal
2018-04-27 Brake issue
2018-05-01 Updated Safety loop and button after probelms in competition
2018-05-01 Added pull-up resistors
2018-05-01 Working drive button without other conditions
